coxlab/physiology_rig/sensors/light_sensor/light_sensor_v4_box.pdf

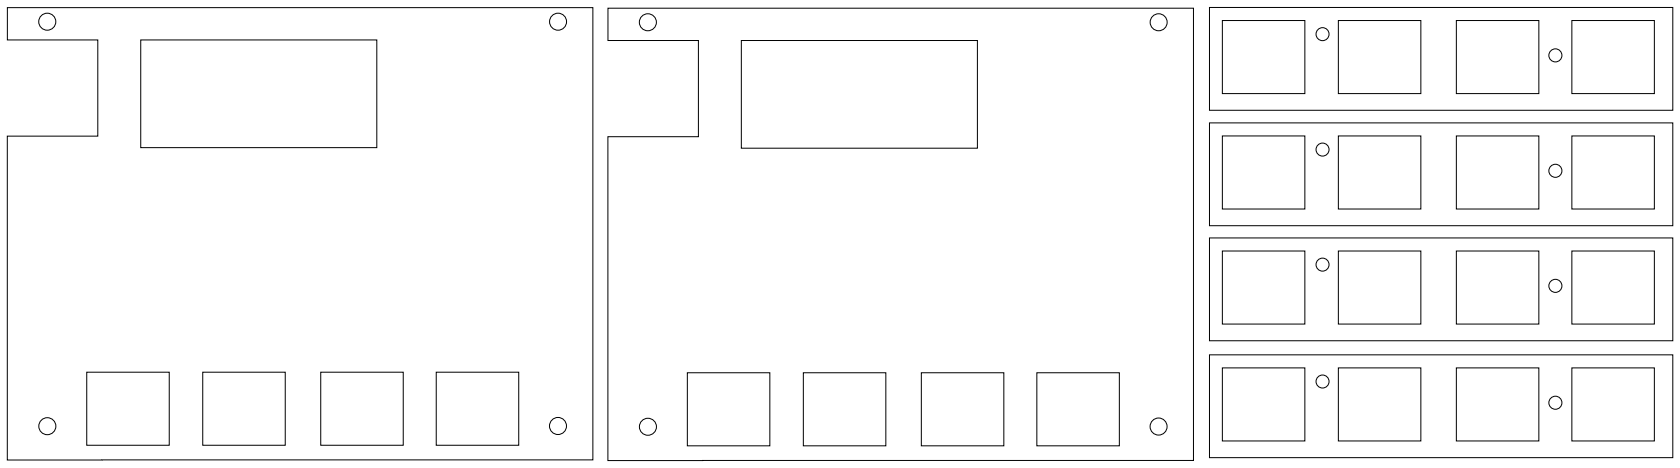
[picture p1: figure]
