coxlab/physiology_rig/implants/ratcam/ratcam/bracket.pdf

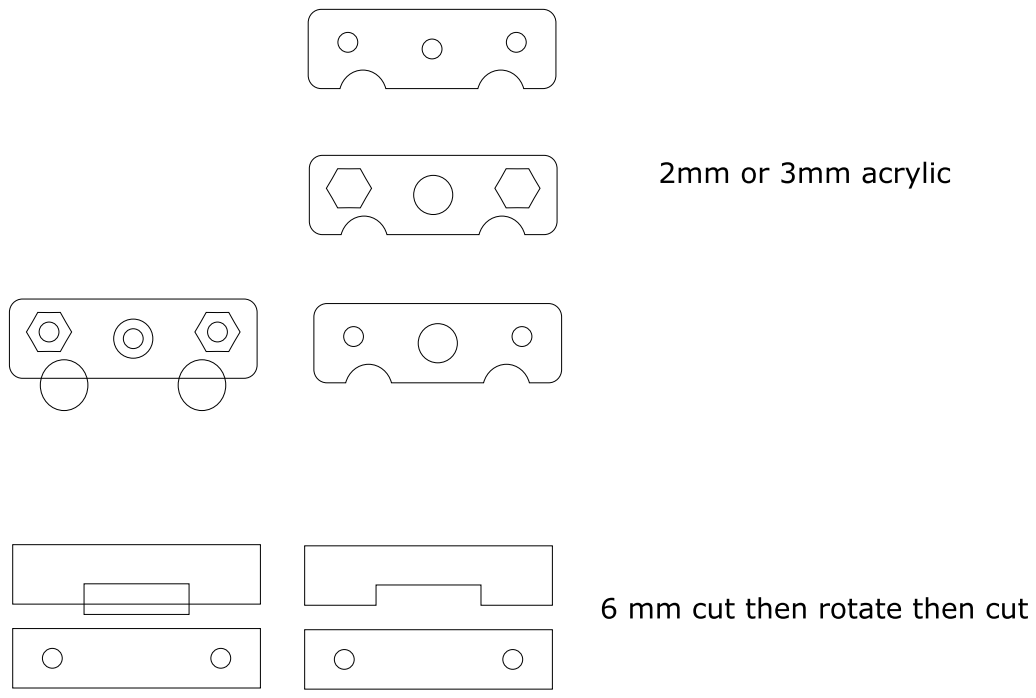
[picture p2: page 1]
