coxlab/physiology_rig/sensors/light_sensor/eagleUp/eagleUp_light_sensor_bottom_mask.png

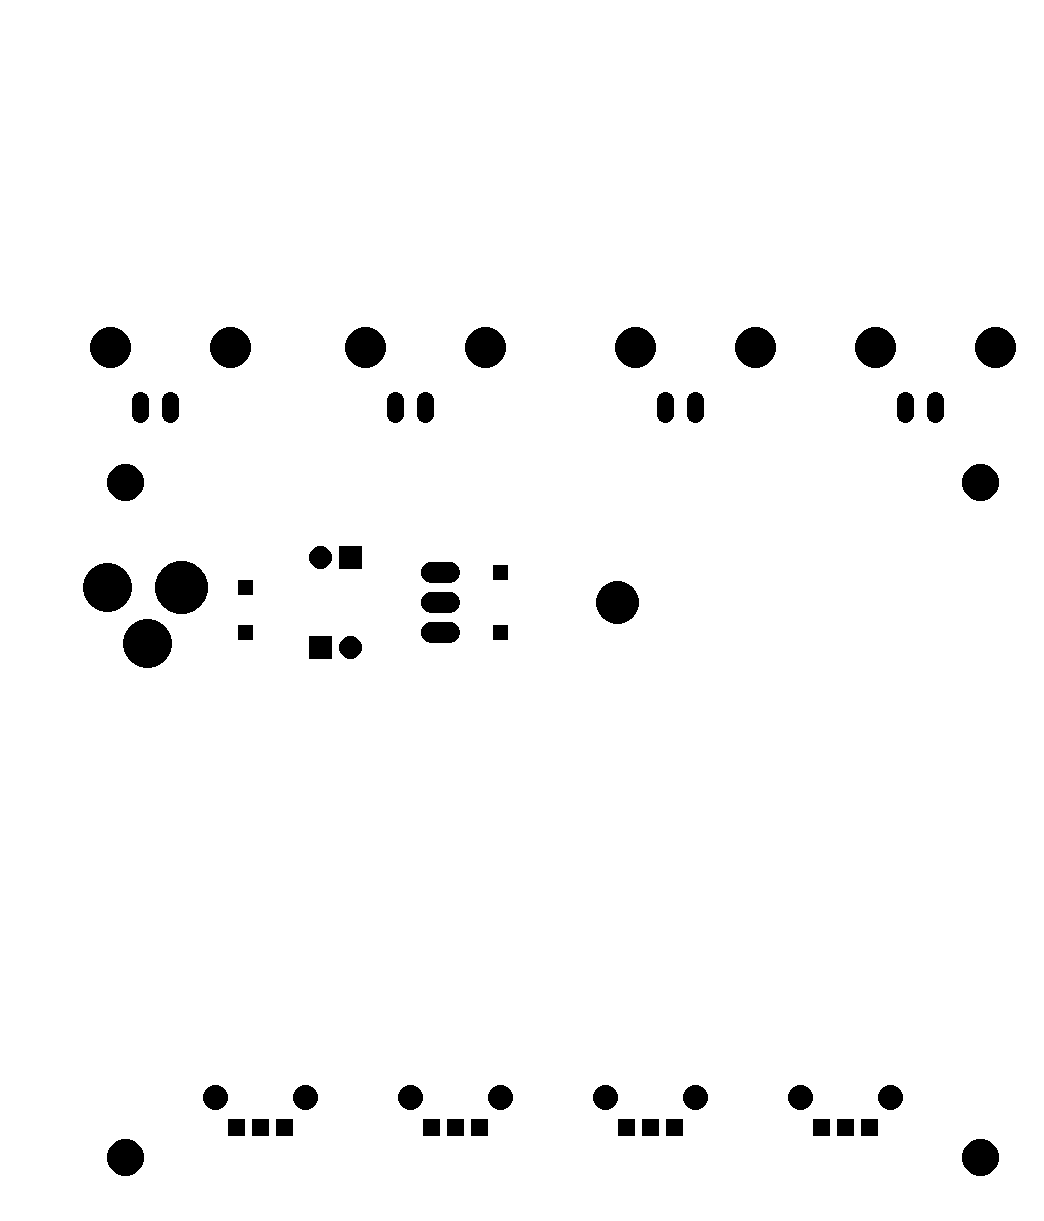
sensors/light_sensor/eagleUp/eagleUp_light_sensor_bottom_mask.png
