coxlab/physiology_rig/sensors/light_sensor/eagleUp/eagleUp_light_sensor_imagesize.png

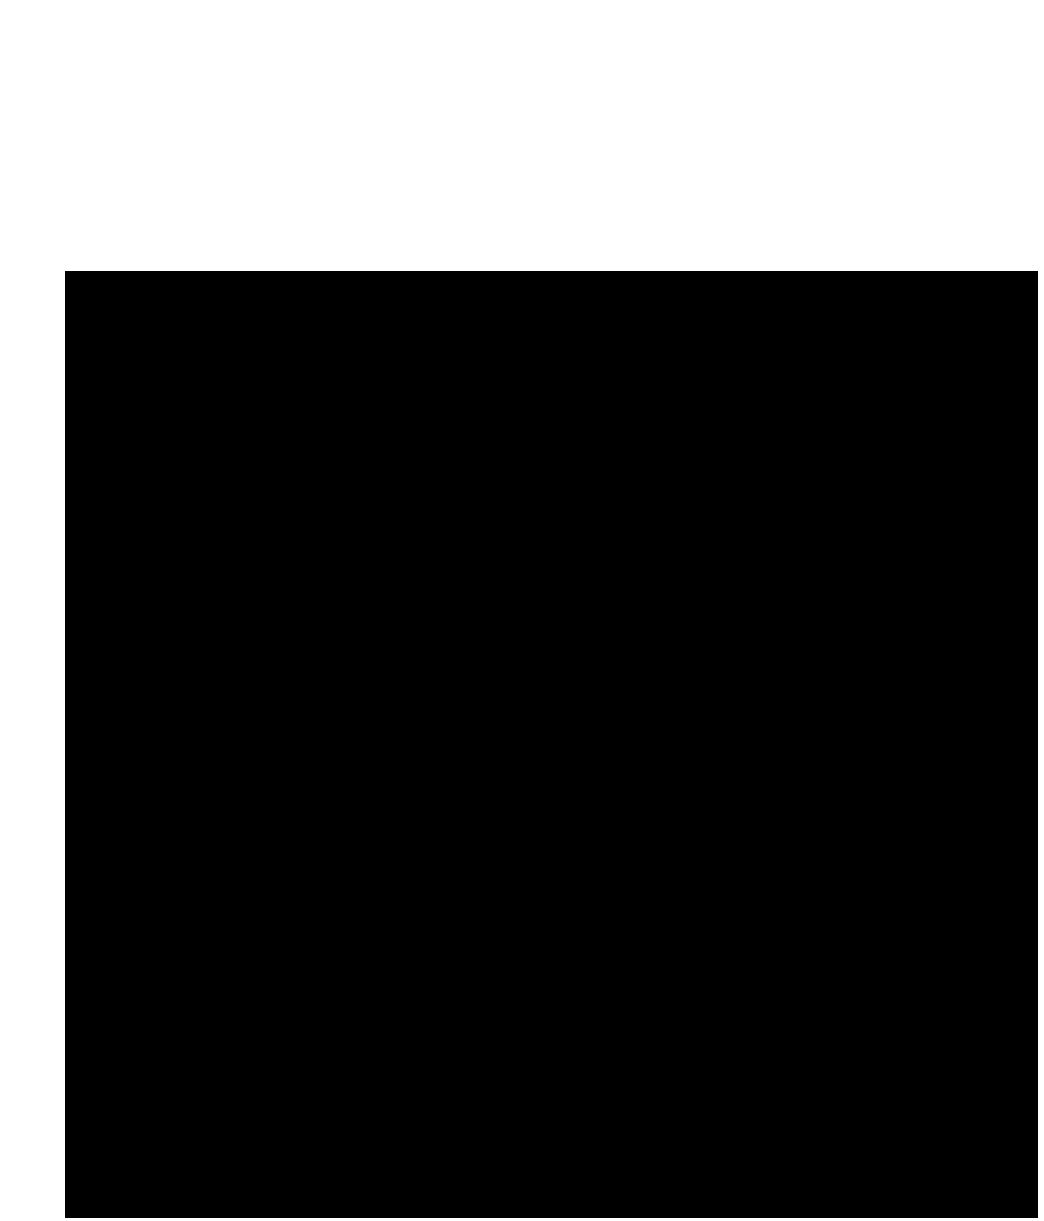
sensors/light_sensor/eagleUp/eagleUp_light_sensor_imagesize.png
