coxlab/physiology_rig/sensors/light_sensor/eagleUp/eagleUp_light_sensor_outline.png

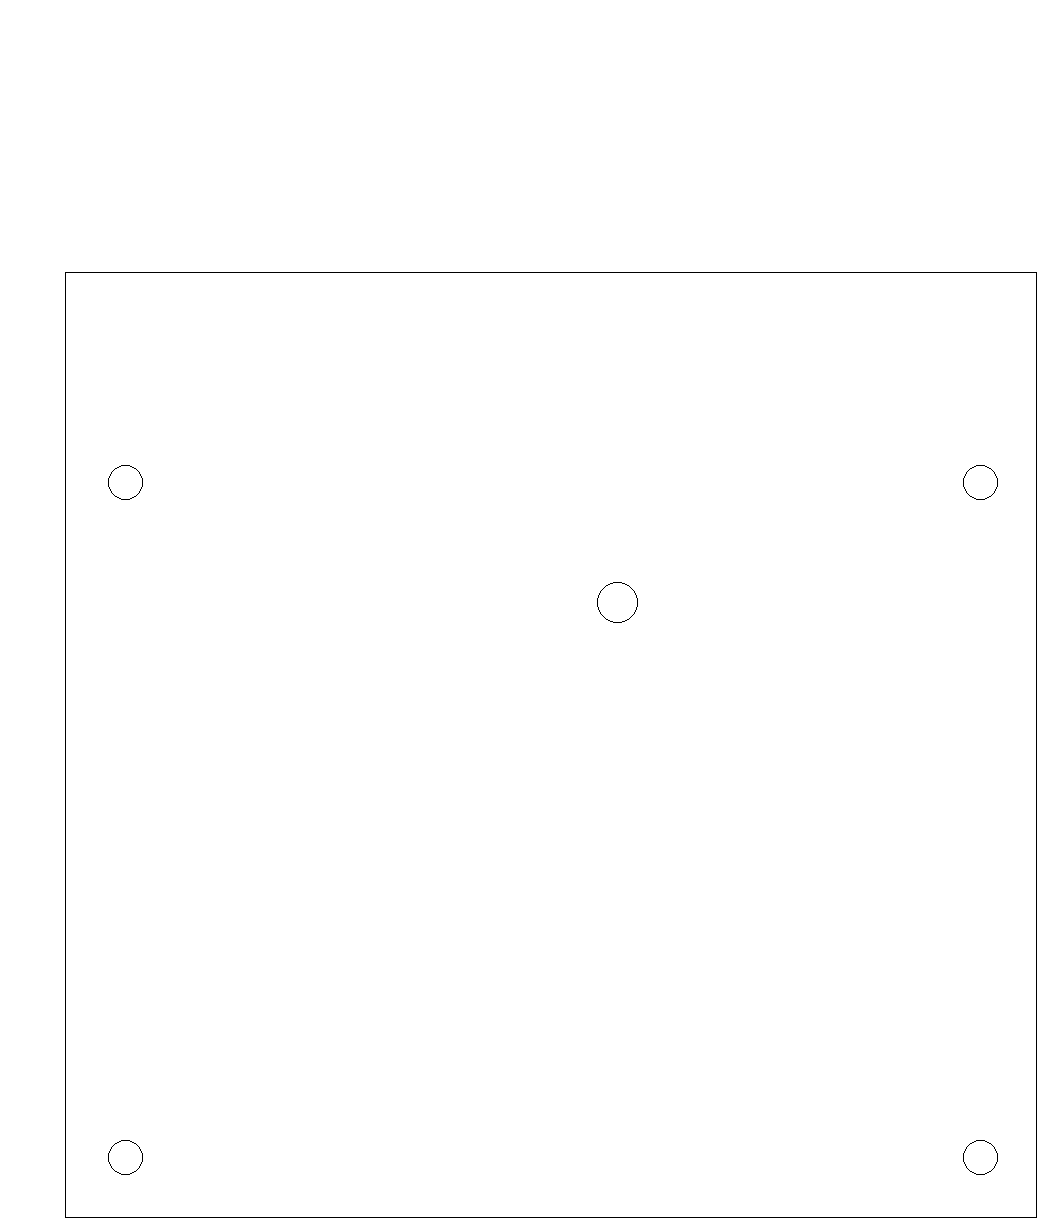
sensors/light_sensor/eagleUp/eagleUp_light_sensor_outline.png
