coxlab/physiology_rig/sensors/light_sensor/eagleUp/eagleUp_light_sensor_top.png

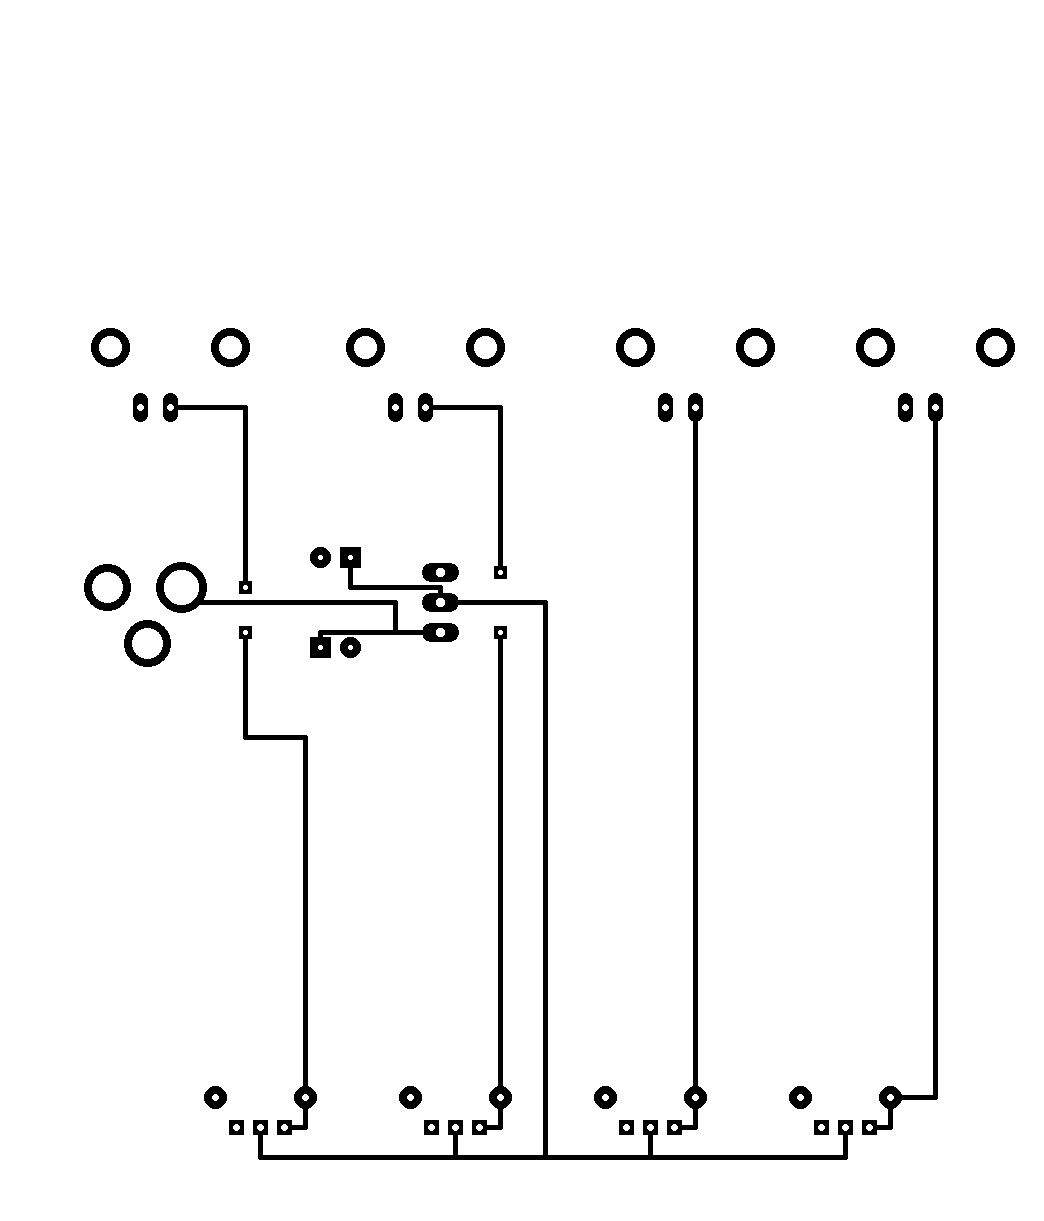
sensors/light_sensor/eagleUp/eagleUp_light_sensor_top.png
