coxlab/physiology_rig/sensors/light_sensor/light_sensor_v4.png

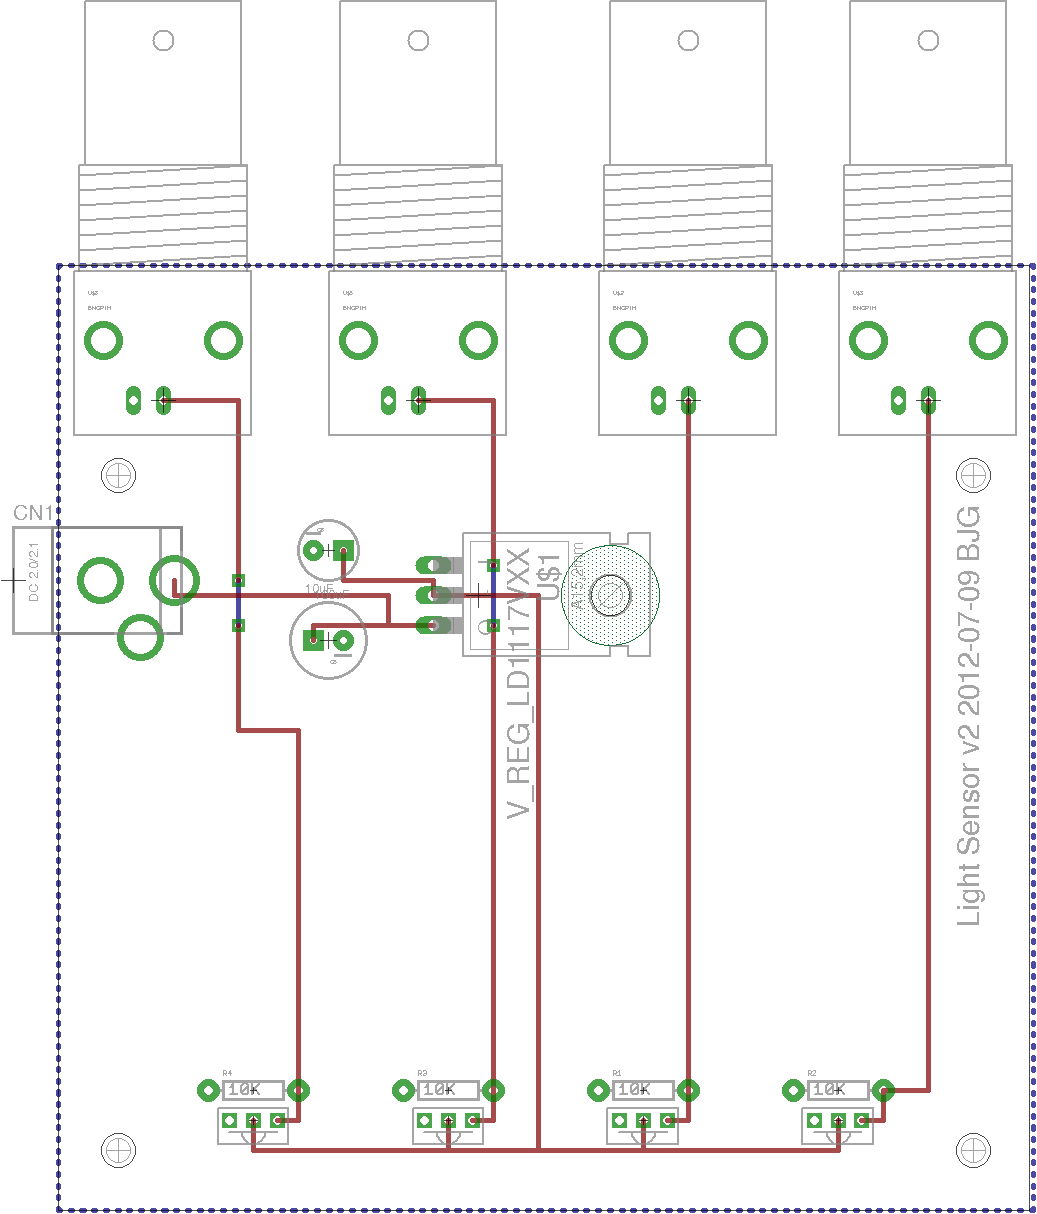
sensors/light_sensor/light_sensor_v4.png
