coxlab/physiology_rig/sensors/light_sensor/light_sensor_v4_box.png

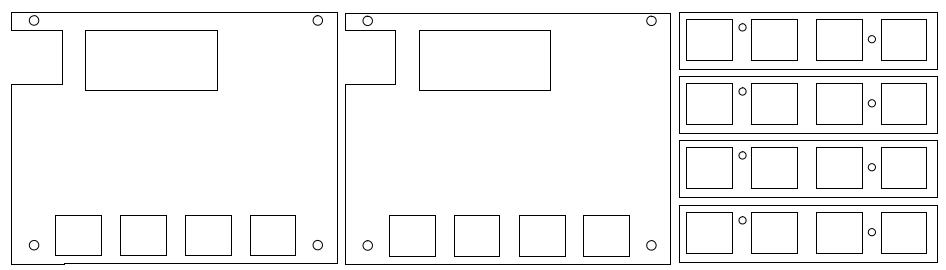
sensors/light_sensor/light_sensor_v4_box.png
