coxlab/physiology_rig/cnc/v1_14x14/electrode_arm/ripple_head.SLDASM

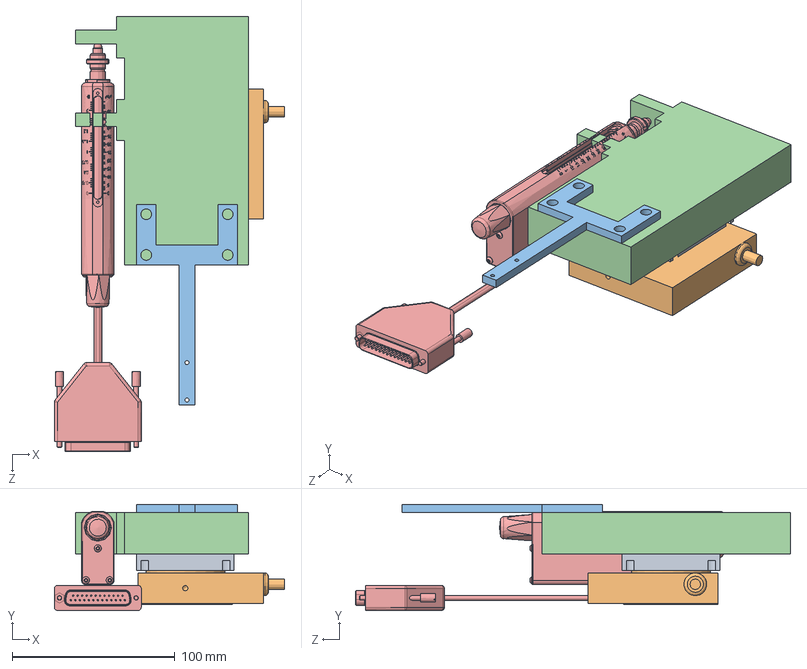
[picture p13: CAD file, 2012-07-30]
cnc/v1_14x14/electrode_arm/ripple_head.SLDASM
141.4 x 65.1 x 267.0 mm
b_to_w
Newport-SR50CC
w_to_ripple
fake_stage
Newport-LTA-HS
