coxlab/physiology_rig/implants/windows/rectangle/D/mated.SLDASM

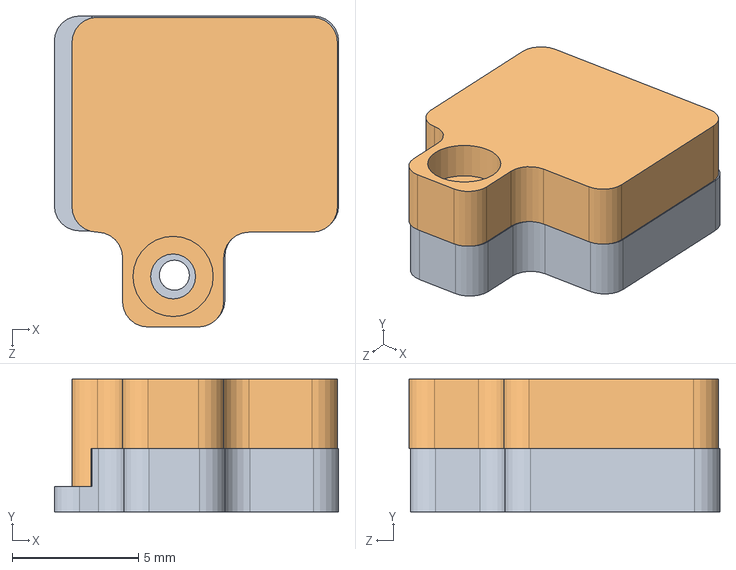
[picture p14: CAD file, 2012-07-30]
implants/windows/rectangle/D/mated.SLDASM
11.2 x 5.25 x 12.3 mm
rectangle_window_D
rectangle_lid_D
