coxlab/physiology_rig/cnc/v1_14x14/commercial_parts/8020/8020-40-4040-Lite.step

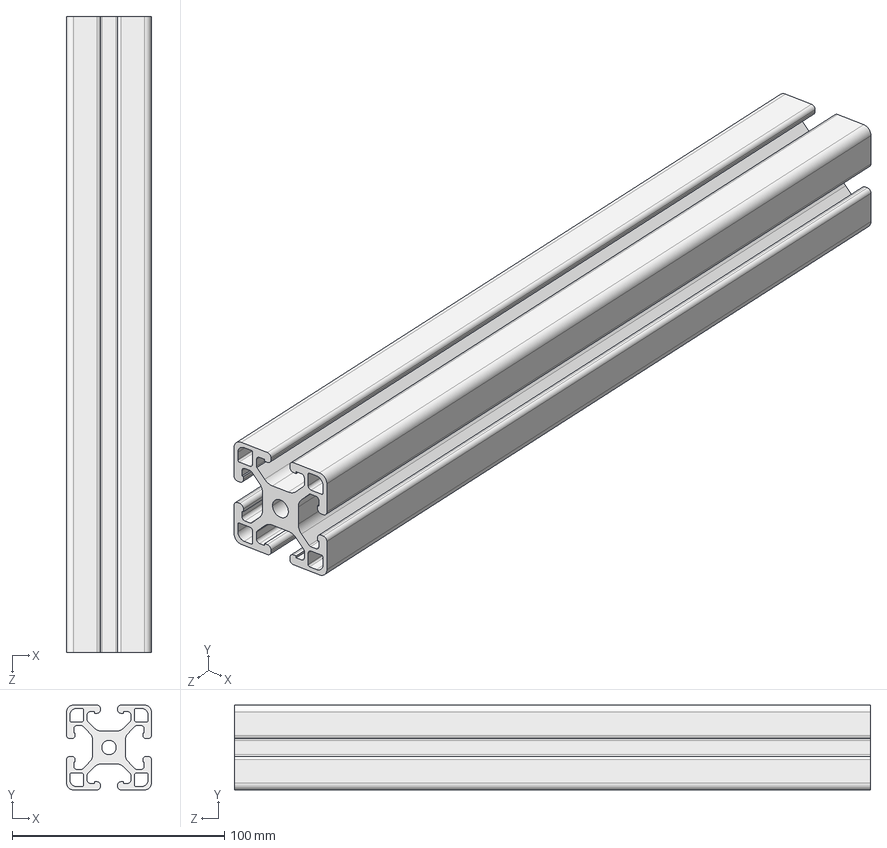
[picture p15: CAD file, 2012-07-30]
cnc/v1_14x14/commercial_parts/8020/8020-40-4040-Lite.step
40.0 x 40.0 x 300.0 mm
