coxlab/physiology_rig/cnc/v1_14x14/commercial_parts/nema_23.stp

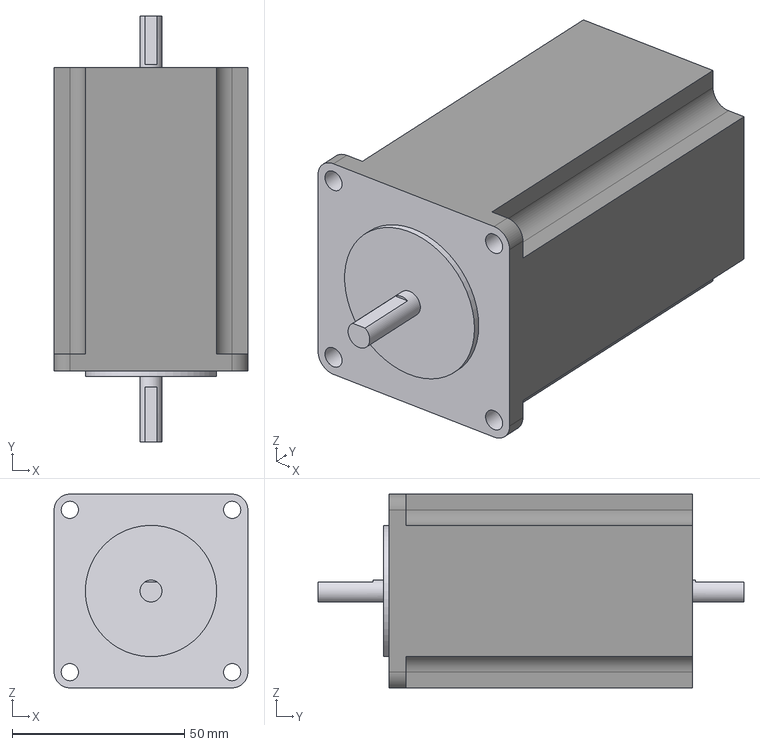
[picture p16: CAD file, 2012-07-30]
cnc/v1_14x14/commercial_parts/nema_23.stp
56.2 x 123.6 x 56.2 mm
