coxlab/physiology_rig/cnc/v1_14x14/commercial_parts/newport/newport_SR50CC.stp

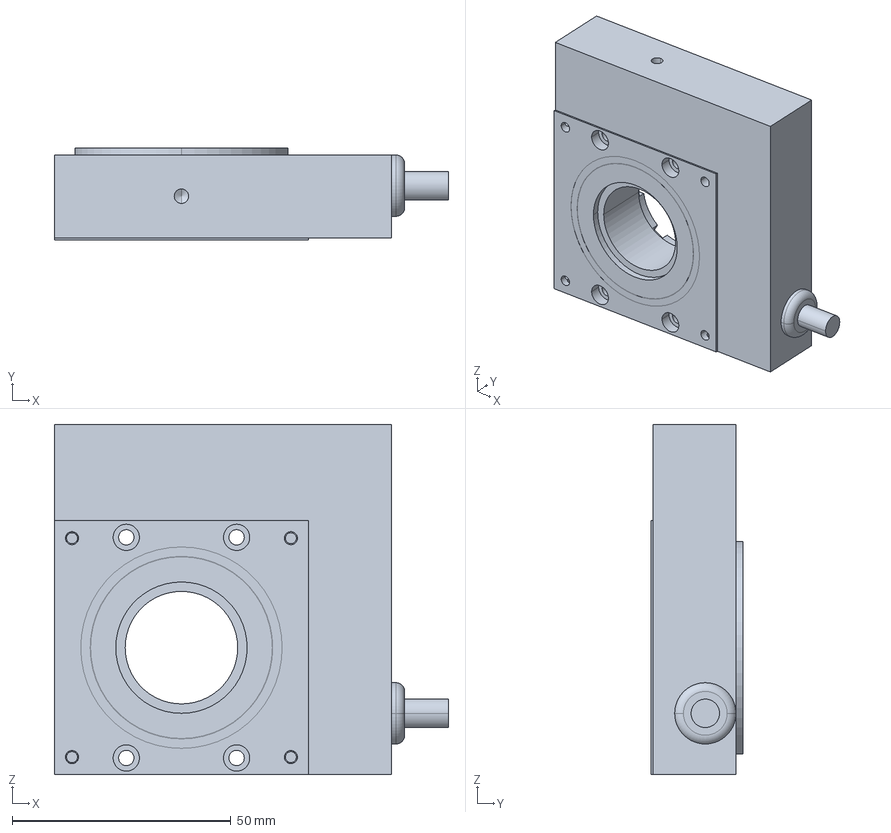
[picture p17: CAD file, 2012-07-30]
cnc/v1_14x14/commercial_parts/newport/newport_SR50CC.stp
90.0 x 21.0 x 80.0 mm
