coxlab/physiology_rig/cnc/v1_14x14/electrode_arm/tdt_preamp_mount/preamp_mount.SLDPRT

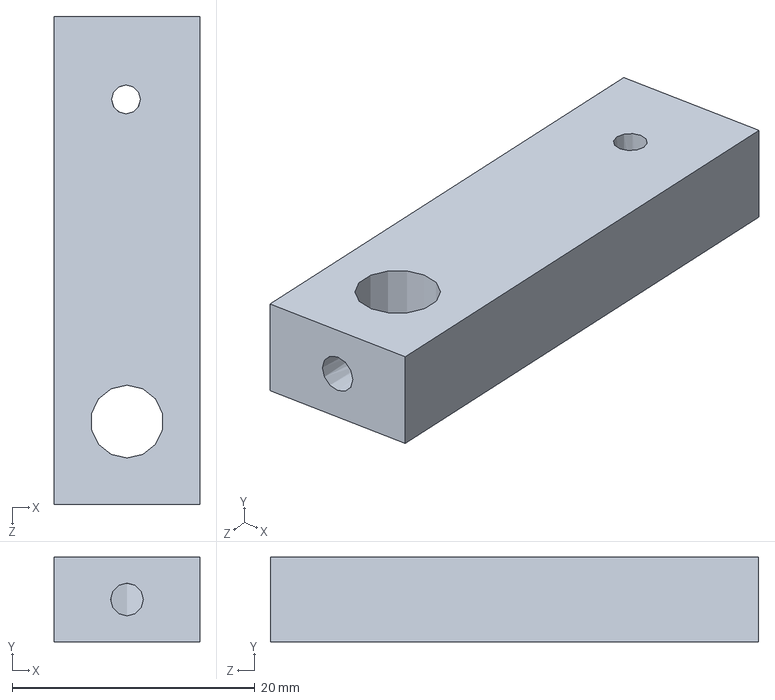
[picture p18: CAD file, 2012-07-30]
cnc/v1_14x14/electrode_arm/tdt_preamp_mount/preamp_mount.SLDPRT
12.0 x 7.00 x 40.2 mm
