coxlab/physiology_rig/cnc/v1_14x14/mounting_plates/cnc_z_plate/cnc_z_plate.SLDPRT

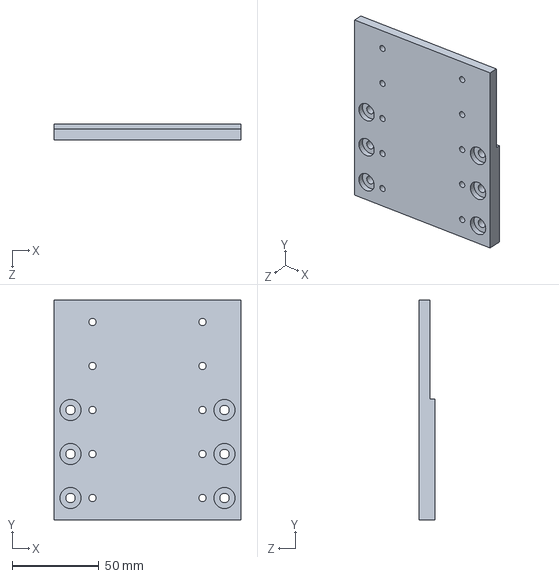
[picture p19: CAD file, 2012-07-30]
cnc/v1_14x14/mounting_plates/cnc_z_plate/cnc_z_plate.SLDPRT
108.0 x 127.0 x 9.53 mm
