coxlab/physiology_rig/cnc/v1_14x14/mounting_plates/z_to_b.SLDPRT

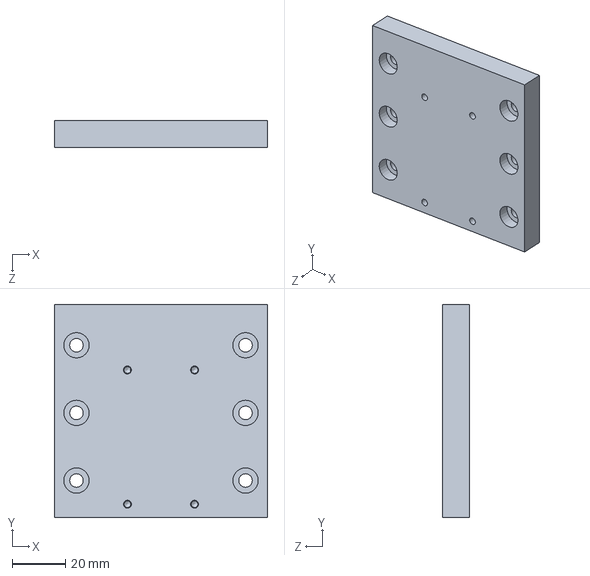
[picture p20: CAD file, 2012-07-30]
cnc/v1_14x14/mounting_plates/z_to_b.SLDPRT
80.0 x 80.0 x 10.0 mm
