coxlab/physiology_rig/implants/kinematic_mount/hats/D/TricornerHatD_fordxf.DXF

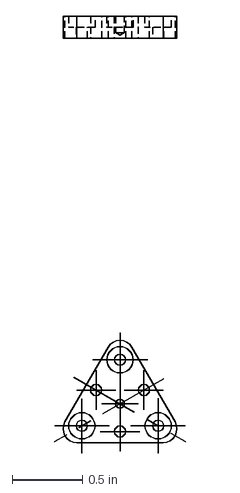
[picture p22: CAD file, 2012-07-30]
implants/kinematic_mount/hats/D/TricornerHatD_fordxf.DXF
0.941 x 3.12 in
