coxlab/physiology_rig/implants/kinematic_mount/hats/E/TricornerHatE.SLDPRT

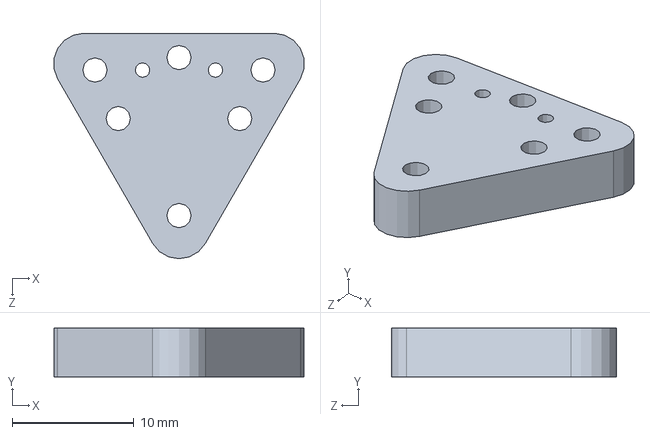
[picture p23: CAD file, 2012-07-30]
implants/kinematic_mount/hats/E/TricornerHatE.SLDPRT
20.6 x 4.00 x 18.6 mm
