coxlab/physiology_rig/implants/kinematic_mount/hats/F/TricornerHatF_nodims_2.dxf

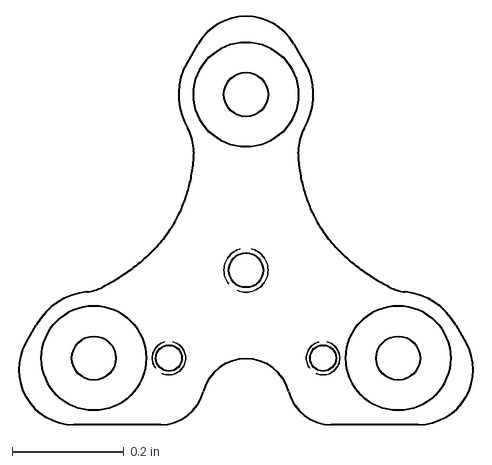
[picture p24: CAD file, 2012-07-30]
implants/kinematic_mount/hats/F/TricornerHatF_nodims_2.dxf
0.822 x 0.73 in
