coxlab/physiology_rig/implants/kinematic_mount/magnet_chuck_redesign/ferrous_insert_no_dims.dxf

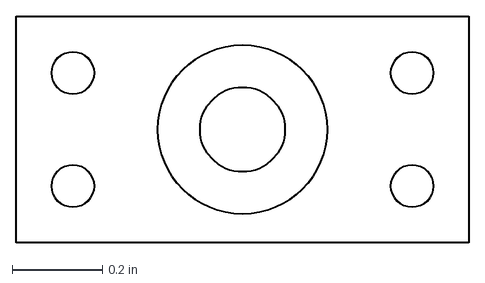
[picture p25: CAD file, 2012-07-30]
implants/kinematic_mount/magnet_chuck_redesign/ferrous_insert_no_dims.dxf
1.00 x 0.5 in
