coxlab/physiology_rig/implants/kinematic_mount/seat/grid/TricornerGround.SLDPRT

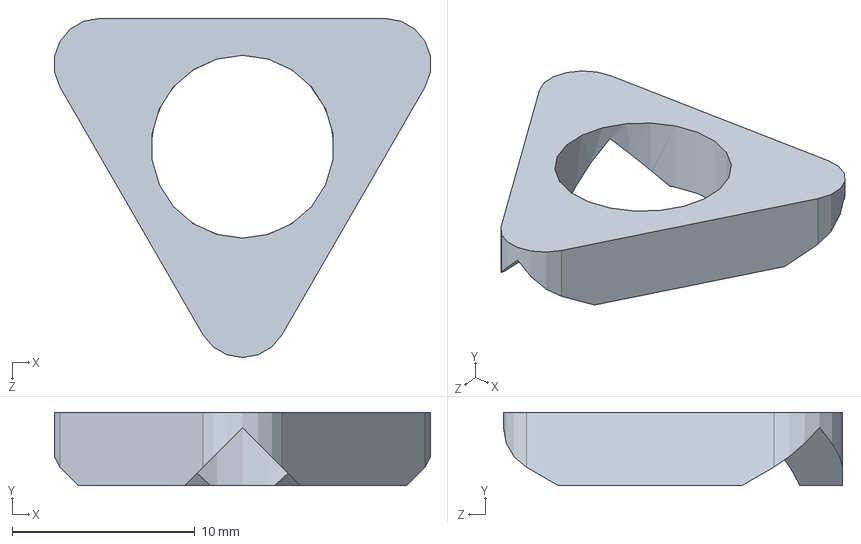
[picture p26: CAD file, 2012-07-30]
implants/kinematic_mount/seat/grid/TricornerGround.SLDPRT
20.6 x 4.00 x 18.6 mm
