coxlab/physiology_rig/implants/kinematic_mount/test_jig/tricorner_test_rig_noAnnotation.DXF

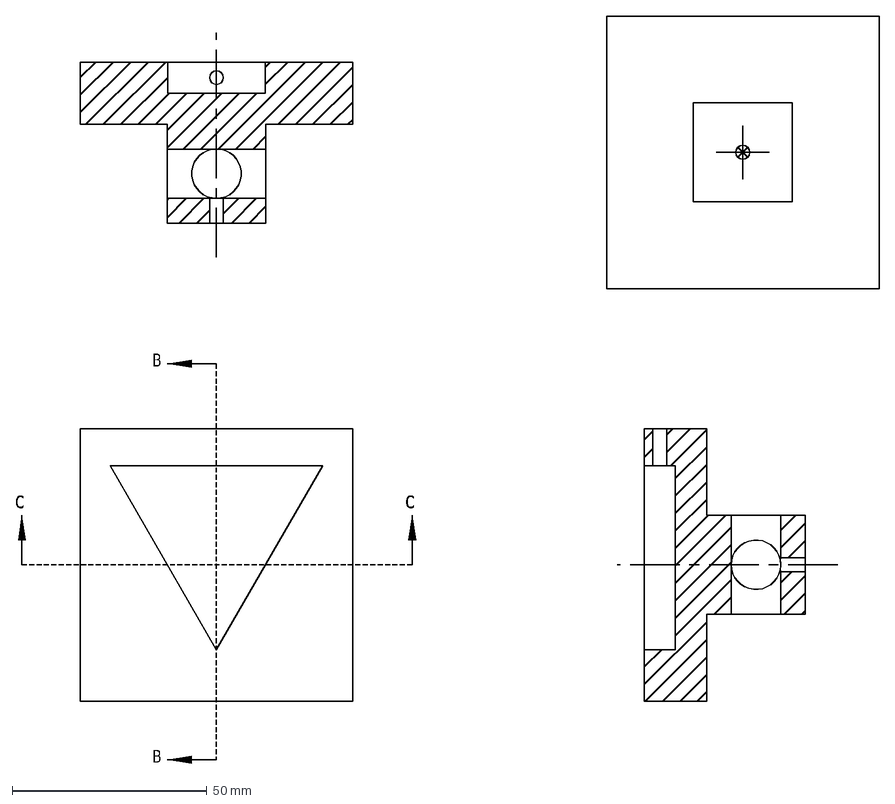
[picture p27: CAD file, 2012-07-30]
implants/kinematic_mount/test_jig/tricorner_test_rig_noAnnotation.DXF
B
C
