coxlab/physiology_rig/implants/ratcam/ratcam/TricornerGround.stl

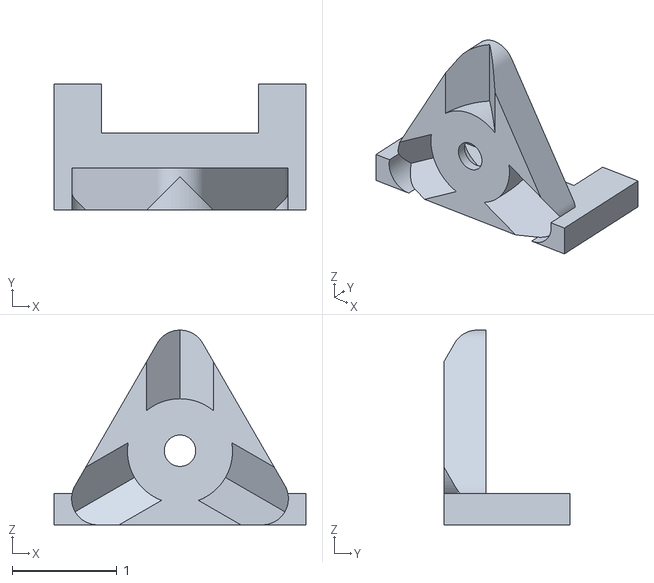
[picture p28: CAD file, 2012-07-30]
implants/ratcam/ratcam/TricornerGround.stl
2.40 x 1.20 x 1.86
