coxlab/physiology_rig/implants/ratcam/ratcam_mount/A/ratcam_mount.SLDPRT

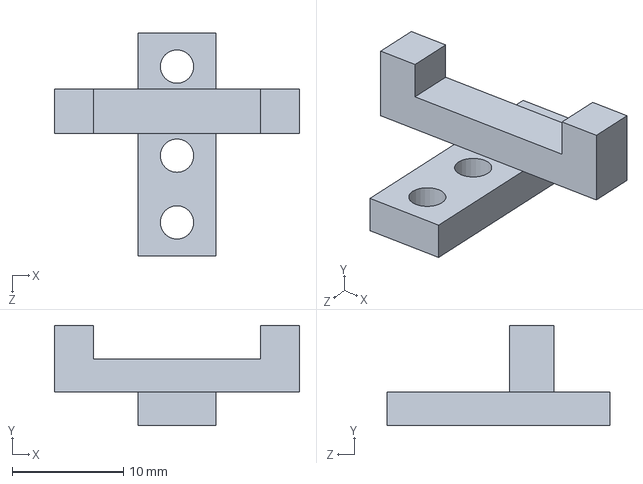
[picture p29: CAD file, 2012-07-30]
implants/ratcam/ratcam_mount/A/ratcam_mount.SLDPRT
22.0 x 9.00 x 20.0 mm
