coxlab/physiology_rig/implants/windows/rectangle/A/rectangle_lid_B.SLDPRT

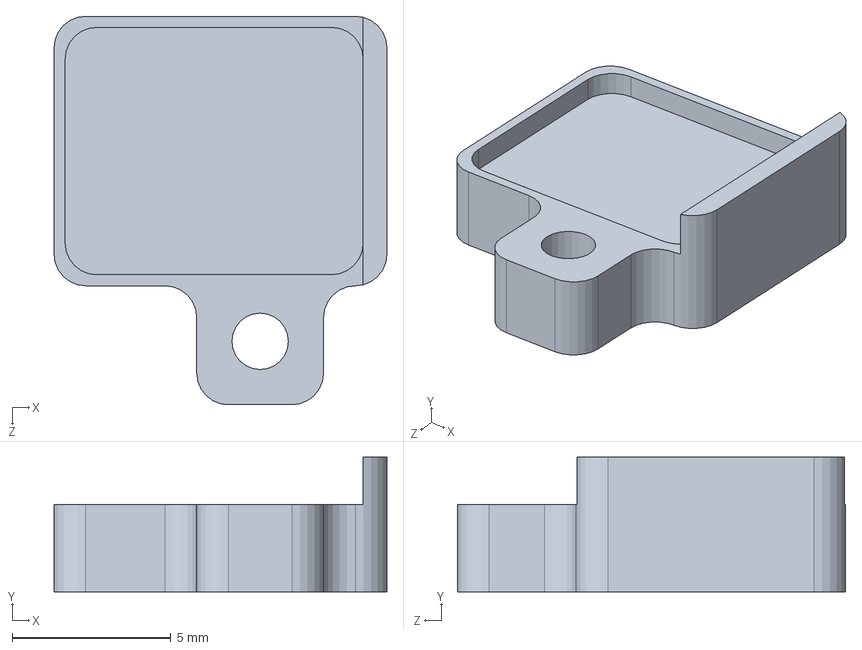
[picture p30: CAD file, 2012-07-30]
implants/windows/rectangle/A/rectangle_lid_B.SLDPRT
10.5 x 4.25 x 12.3 mm
