coxlab/physiology_rig/implants/windows/rectangle/C/rectangle_window_C.SLDPRT

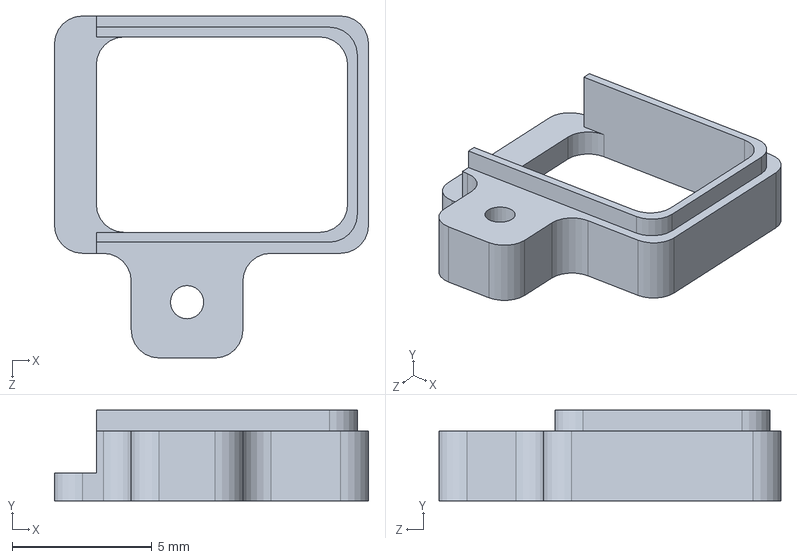
[picture p31: CAD file, 2012-07-30]
implants/windows/rectangle/C/rectangle_window_C.SLDPRT
11.2 x 3.25 x 12.3 mm
