coxlab/physiology_rig/implants/windows/rectangle/E/inventor/rectangle_lid_E_dims.dxf

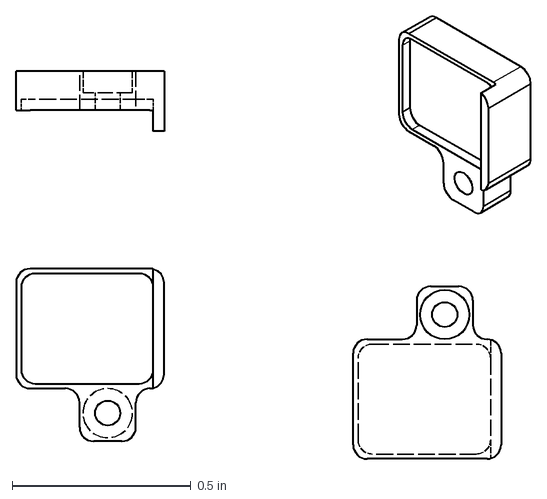
[picture p32: CAD file, 2012-07-30]
implants/windows/rectangle/E/inventor/rectangle_lid_E_dims.dxf
1.44 x 1.24 in
