coxlab/physiology_rig/implants/windows/rectangle/E/rectangle_window_E.dxf

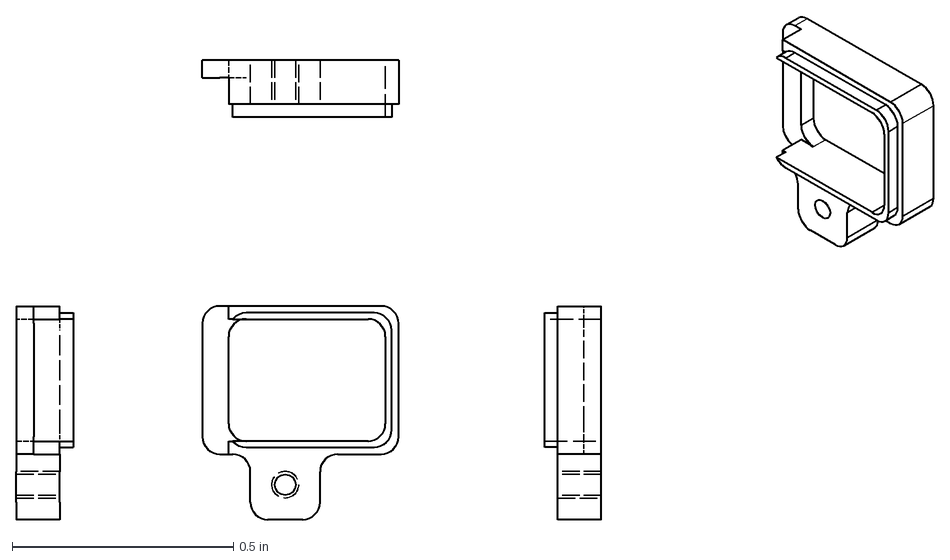
[picture p33: CAD file, 2012-07-30]
implants/windows/rectangle/E/rectangle_window_E.dxf
2.07 x 1.14 in
