coxlab/physiology_rig/implants/windows/square/C/7mmWindowC.SLDPRT

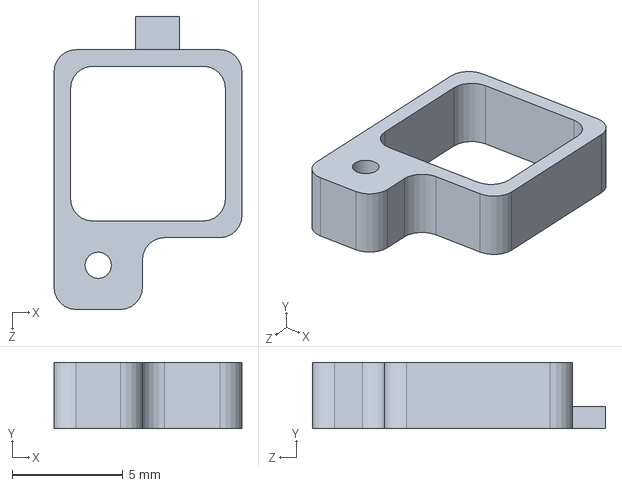
[picture p35: CAD file, 2012-07-30]
implants/windows/square/C/7mmWindowC.SLDPRT
8.50 x 3.00 x 13.2 mm
