coxlab/physiology_rig/implants/windows/square/D/7mmWindowD.DXF

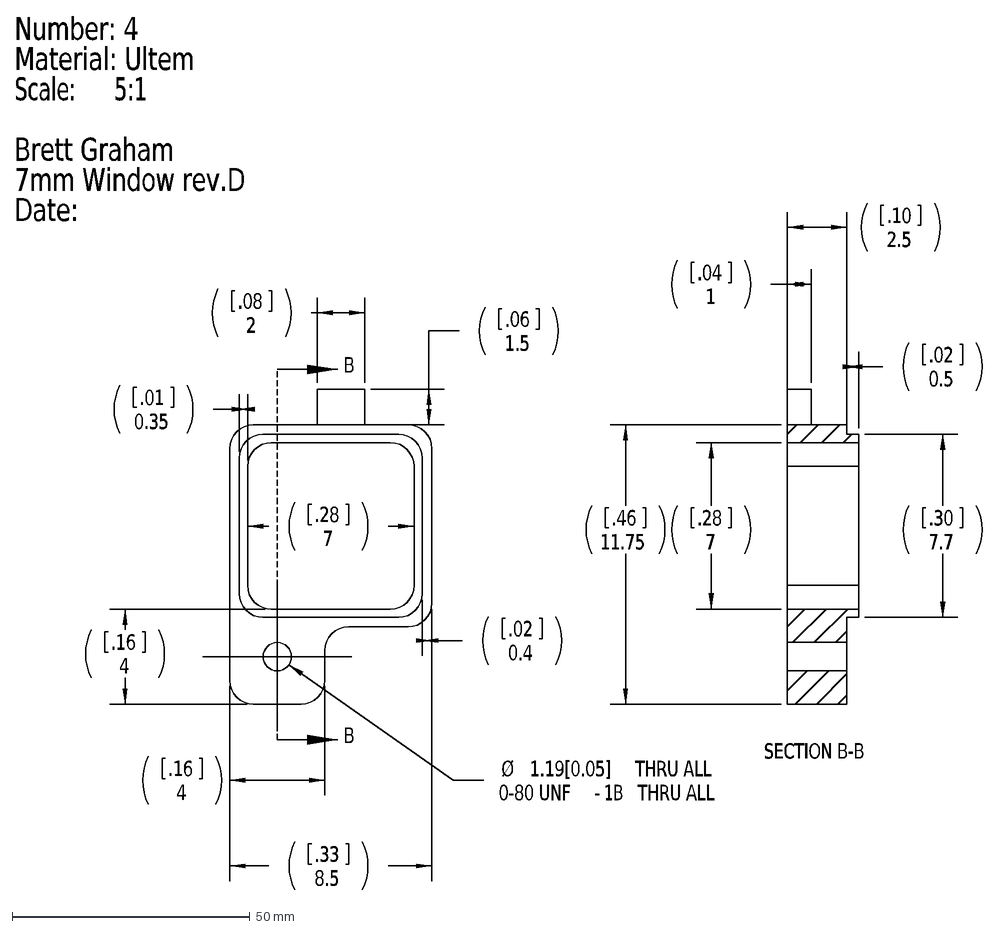
[picture p36: CAD file, 2012-07-30]
implants/windows/square/D/7mmWindowD.DXF
Number: 4
Material: Ultem
Scale: 5:1
Brett Graham
7mm Window rev.D
Date:
2
.08
1.5
.06
4
.16
8.5
.33
7
.28
0-80 UNF
- 1B
THRU ALL
Ø
1.19[0.05]
0.4
.02
0.35
.01
B
11.75
.46
1
.04
2.5
.10
0.5
7.7
.30
SECTION B-B
