coxlab/physiology_rig/implants/windows/wide/a_0.5mm_wall/lid.dxf

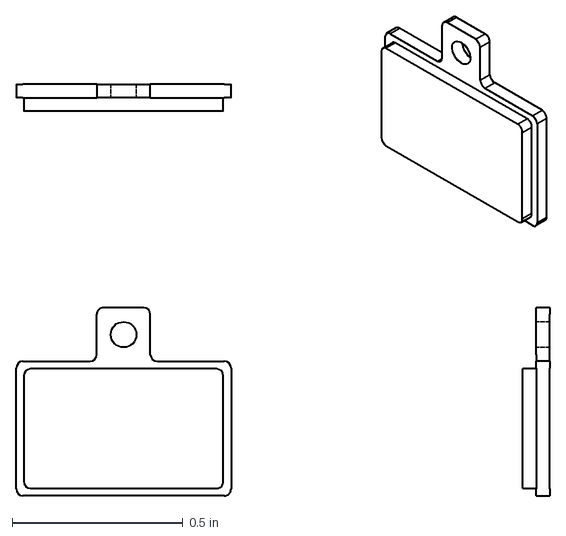
[picture p37: CAD file, 2012-07-30]
implants/windows/wide/a_0.5mm_wall/lid.dxf
1.56 x 1.41 in
