coxlab/physiology_rig/implants/windows/wide/b_1mm_wall/lid.dxf

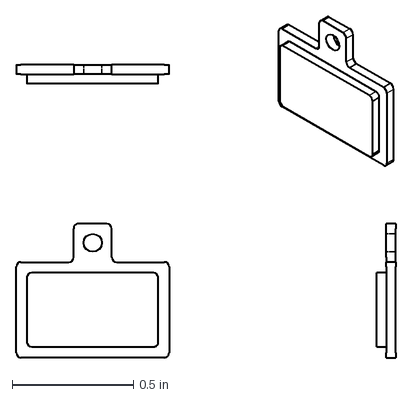
[picture p38: CAD file, 2012-07-30]
implants/windows/wide/b_1mm_wall/lid.dxf
1.56 x 1.41 in
