coxlab/physiology_rig/implants/windows/wide/c_7mm_0.5mm_wall/lid.dxf

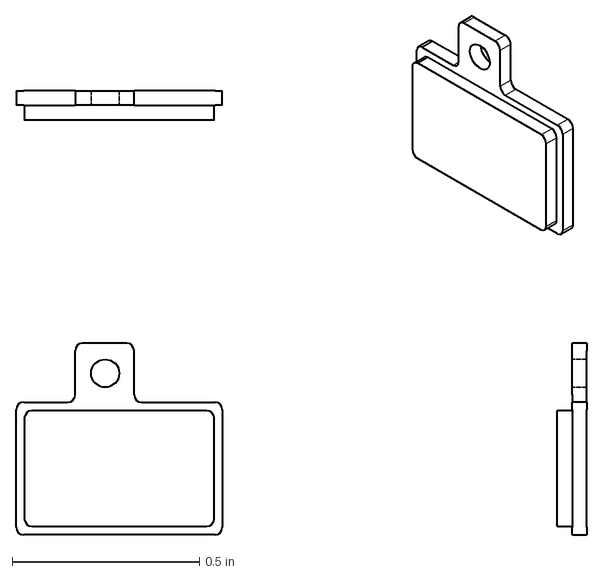
[picture p39: CAD file, 2012-07-30]
implants/windows/wide/c_7mm_0.5mm_wall/lid.dxf
1.53 x 1.39 in
