coxlab/physiology_rig/recording/audio/garbage2.0/garbage2_mount/garbage2_mount.SLDPRT

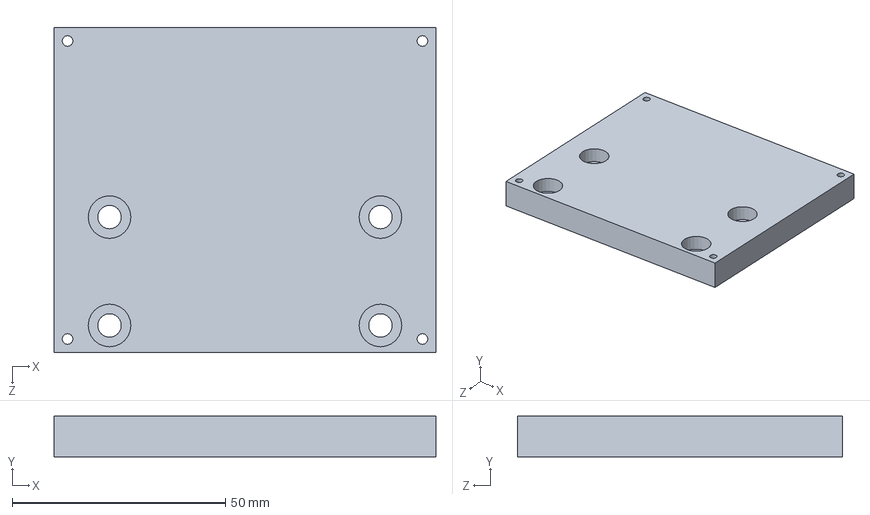
[picture p40: CAD file, 2012-07-30]
recording/audio/garbage2.0/garbage2_mount/garbage2_mount.SLDPRT
89.5 x 9.53 x 76.2 mm
