coxlab/physiology_rig/recording/neuro_nexus_probes/a/a_10.SLDPRT

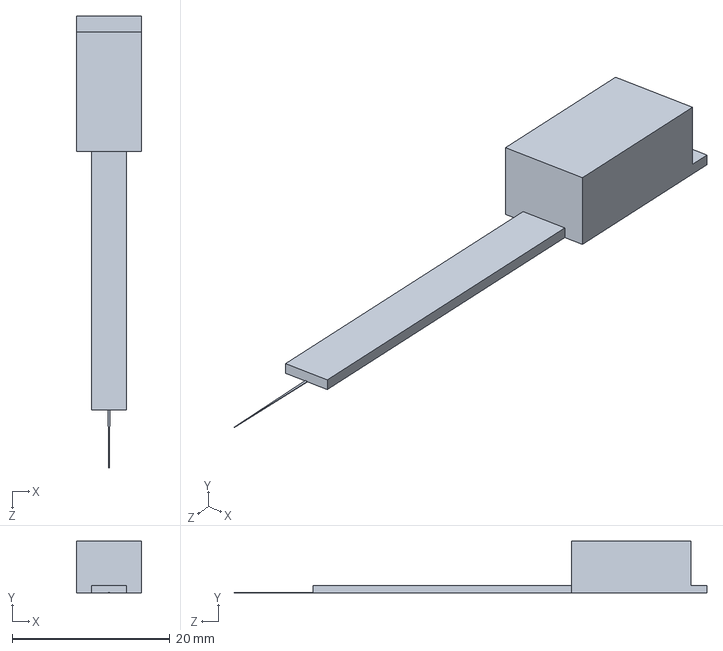
[picture p41: CAD file, 2012-07-30]
recording/neuro_nexus_probes/a/a_10.SLDPRT
8.30 x 6.55 x 60.0 mm
