coxlab/physiology_rig/recording/single_channel/alpha_omega_holder/alpha_omega_holder.stl

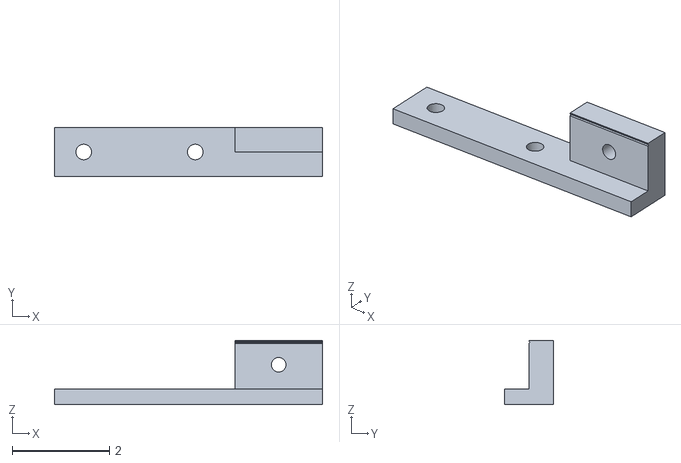
[picture p42: CAD file, 2012-07-30]
recording/single_channel/alpha_omega_holder/alpha_omega_holder.stl
5.50 x 1.00 x 1.32
