coxlab/physiology_rig/sensors/light_sensor/light_sensor.dxf

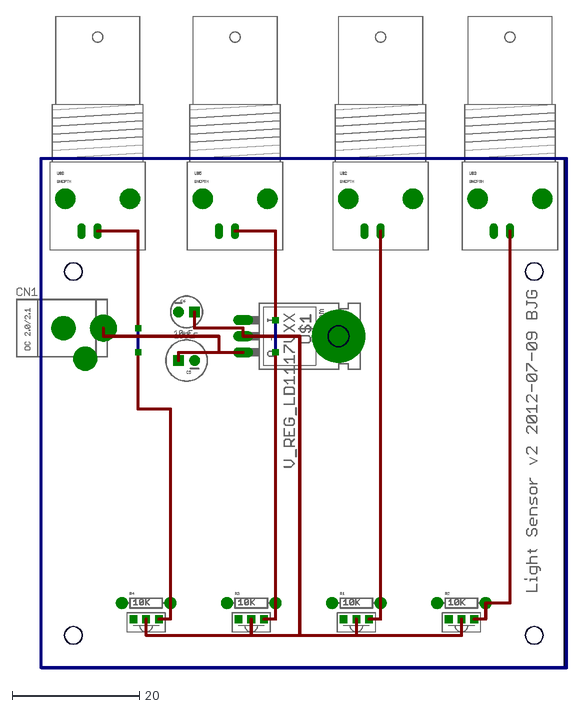
[picture p43: CAD file, 2012-07-30]
sensors/light_sensor/light_sensor.dxf
86.7 x 102.6
