coxlab/physiology_rig/sensors/phidget_to_bb_plate/phidget_to_bb_plate.dxf

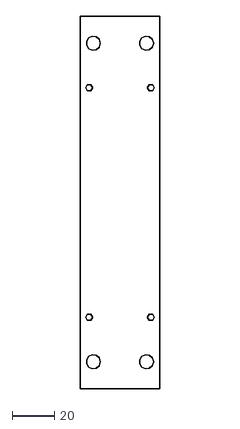
[picture p44: CAD file, 2013-03-04]
sensors/phidget_to_bb_plate/phidget_to_bb_plate.dxf
37.5 x 175.5
