coxlab/physiology_rig/stereo_cameras/scorpion_cameras/scorpion_lens_adaptor/scorpion_lens_adaptor.SLDPRT

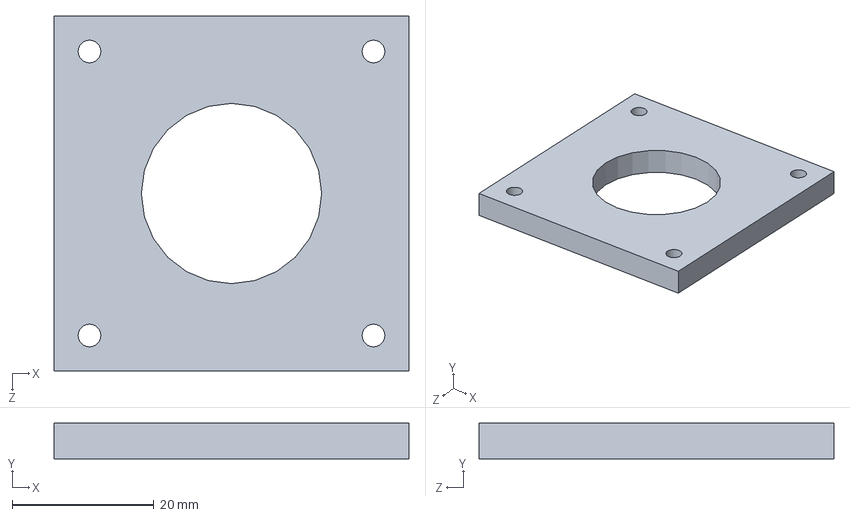
[picture p45: CAD file, 2012-07-30]
stereo_cameras/scorpion_cameras/scorpion_lens_adaptor/scorpion_lens_adaptor.SLDPRT
50.0 x 5.00 x 50.0 mm
