coxlab/physiology_rig/stereo_cameras/scorpion_cameras/scorpion_mount/ptgrey_scorpion_mount.SLDPRT

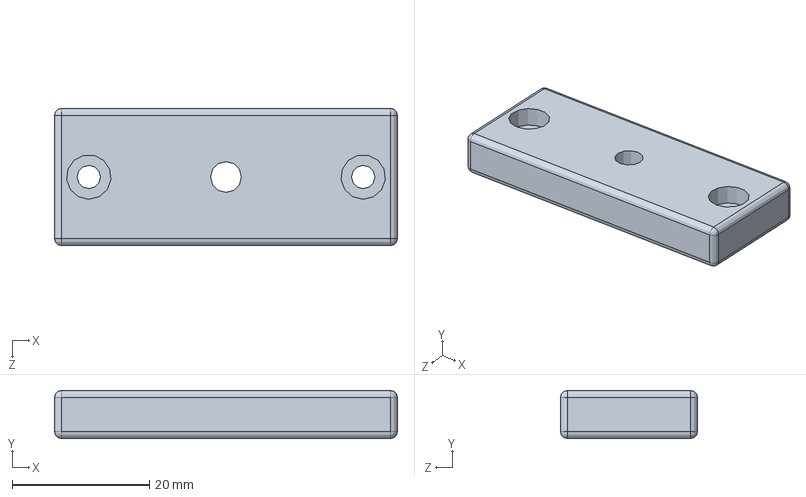
[picture p46: CAD file, 2012-07-30]
stereo_cameras/scorpion_cameras/scorpion_mount/ptgrey_scorpion_mount.SLDPRT
50.0 x 7.00 x 20.0 mm
