coxlab/physiology_rig/stereo_cameras/scorpion_cameras/stereo_cameras_plate/stereo_cameras_plate.dxf

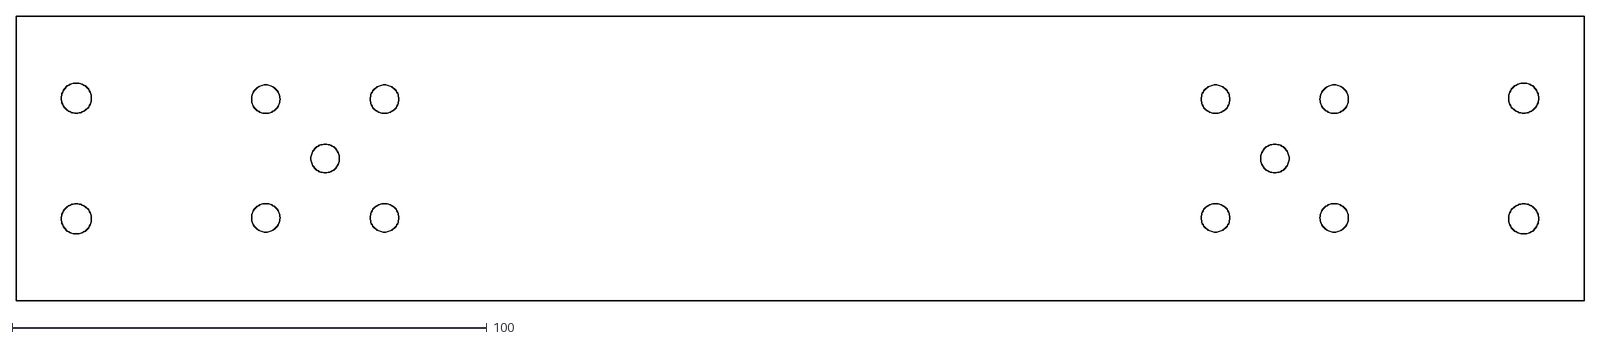
[picture p47: CAD file, 2013-03-04]
stereo_cameras/scorpion_cameras/stereo_cameras_plate/stereo_cameras_plate.dxf
330.2 x 60.0
