coxlab/physiology_rig/structured_light/reference_object/A/structured_light_registration_object..stp

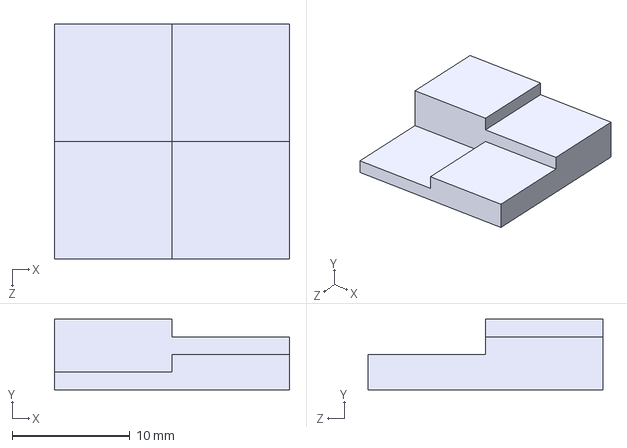
[picture p48: CAD file, 2012-07-30]
structured_light/reference_object/A/structured_light_registration_object..stp
20.0 x 6.00 x 20.0 mm
