coxlab/physiology_rig/structured_light/reference_plate/other_tricorner_registration_plate.SLDPRT

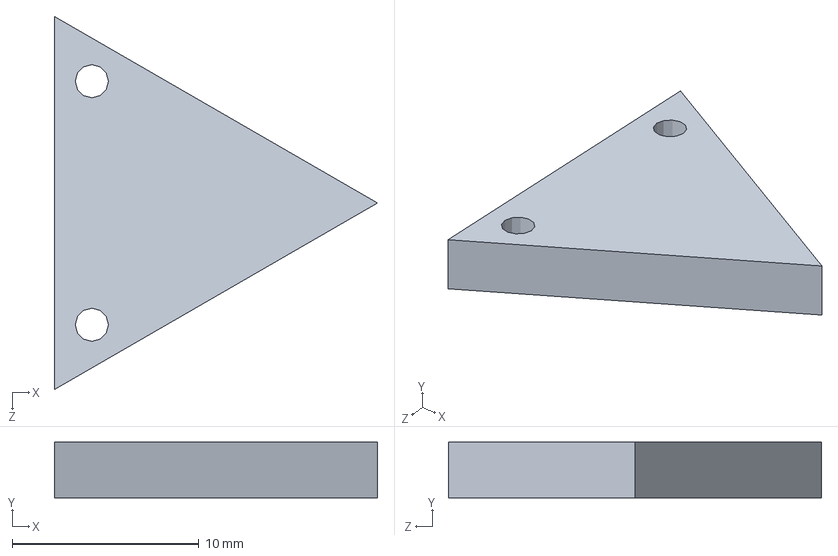
[picture p49: CAD file, 2012-07-30]
structured_light/reference_plate/other_tricorner_registration_plate.SLDPRT
17.3 x 3.00 x 20.0 mm
