coxlab/physiology_rig/two_photon/objective/N20X-PFH-Solidworks.sldprt

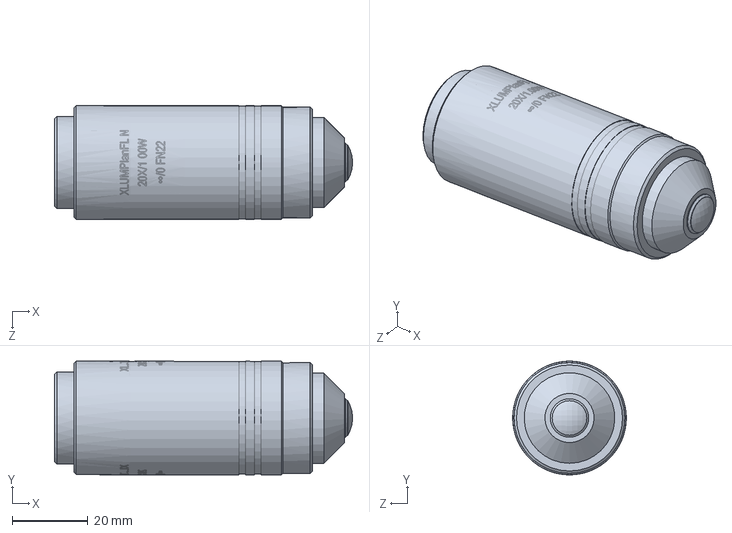
[picture p50: CAD file, 2013-04-24]
two_photon/objective/N20X-PFH-Solidworks.sldprt
78.6 x 30.0 x 29.9 mm
