coxlab/physiology_rig/cnc/v1_14x14/commercial_parts/8020/8020-25-2525.step

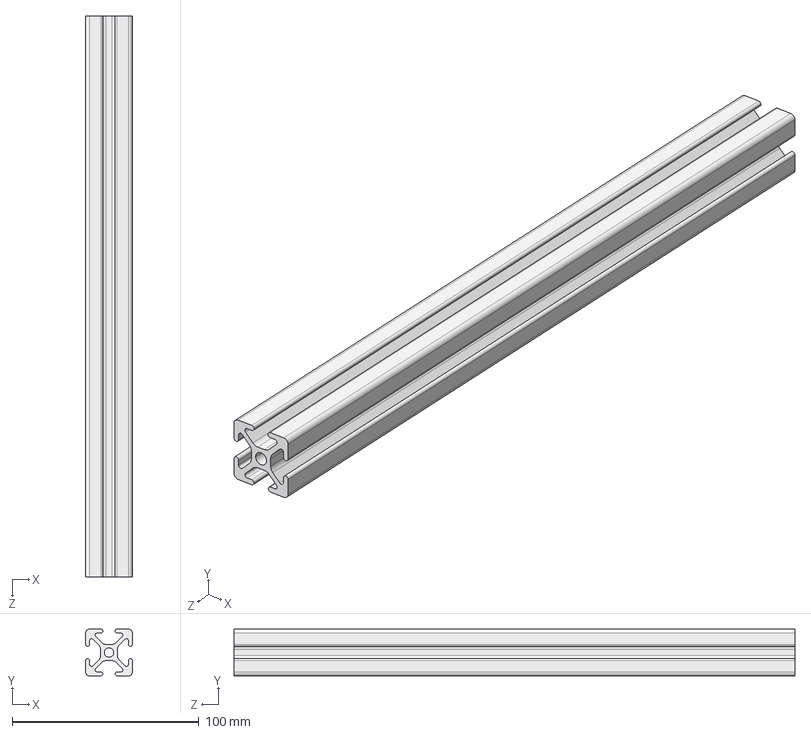
[picture p51: CAD file, 2012-07-30]
cnc/v1_14x14/commercial_parts/8020/8020-25-2525.step
25.0 x 25.0 x 300.0 mm
