coxlab/physiology_rig/cnc/v1_14x14/commercial_parts/newport/Newport-LTA-HS.SLDPRT

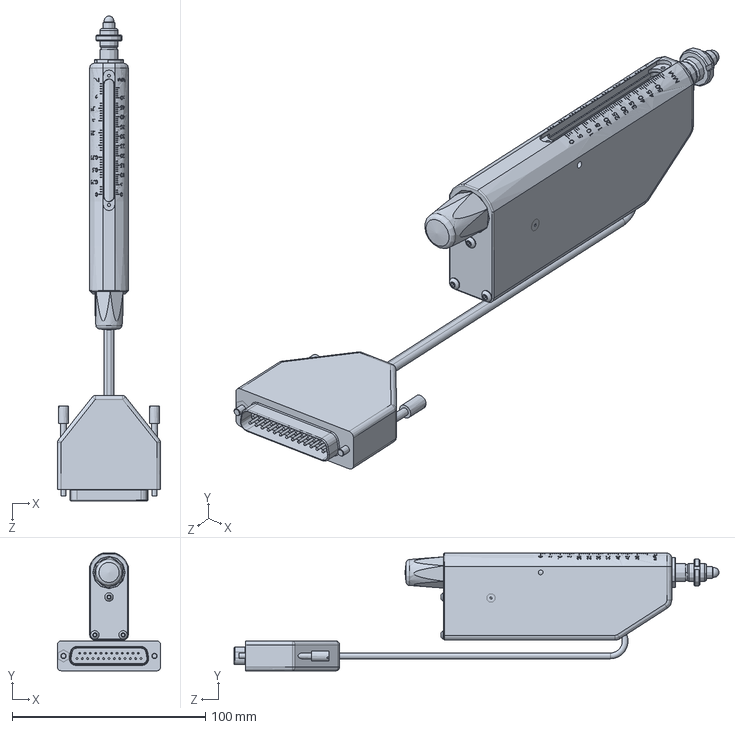
[picture p52: CAD file, 2012-07-30]
cnc/v1_14x14/commercial_parts/newport/Newport-LTA-HS.SLDPRT
53.4 x 60.9 x 250.8 mm
