coxlab/physiology_rig/cnc/v1_14x14/electrode_arm/failed_head/w_to_tdt_fordxf.DXF

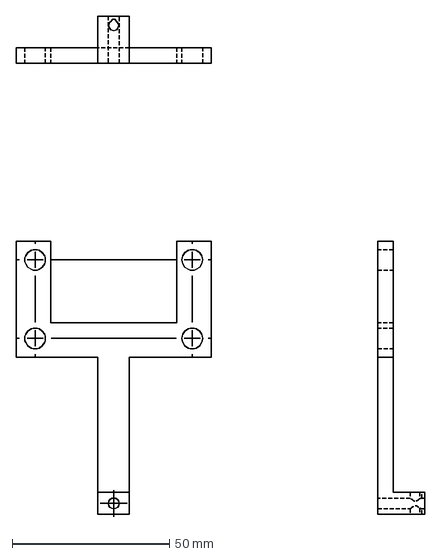
[picture p53: CAD file, 2012-07-30]
cnc/v1_14x14/electrode_arm/failed_head/w_to_tdt_fordxf.DXF
130.0 x 159.3 mm
