coxlab/physiology_rig/implants/kinematic_mount/hats/D/TricornerHatD.SLDPRT

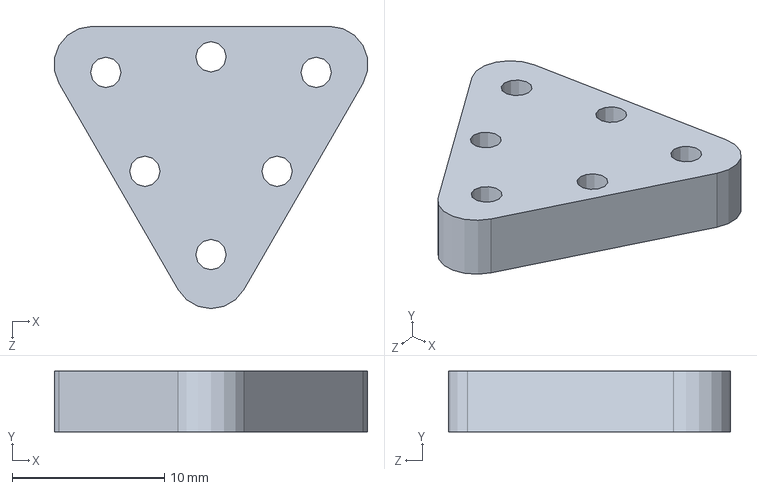
[picture p55: CAD file, 2012-07-30]
implants/kinematic_mount/hats/D/TricornerHatD.SLDPRT
20.6 x 4.00 x 18.6 mm
