coxlab/physiology_rig/implants/kinematic_mount/hats/E/TricornerHatE_fordxf_am.DXF

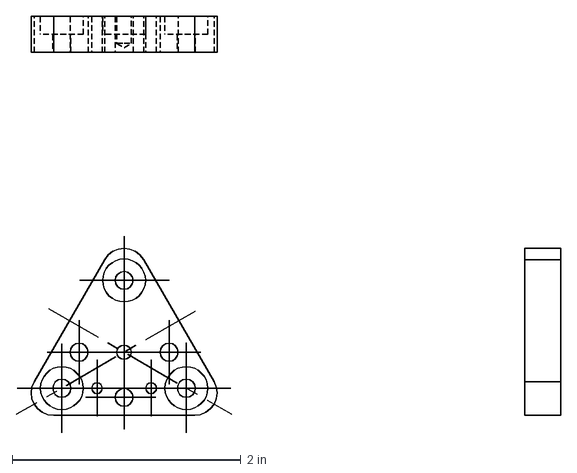
[picture p56: CAD file, 2012-07-30]
implants/kinematic_mount/hats/E/TricornerHatE_fordxf_am.DXF
4.76 x 3.64 in
