coxlab/physiology_rig/implants/kinematic_mount/hats/F/TricornerHatF_nodims.dxf

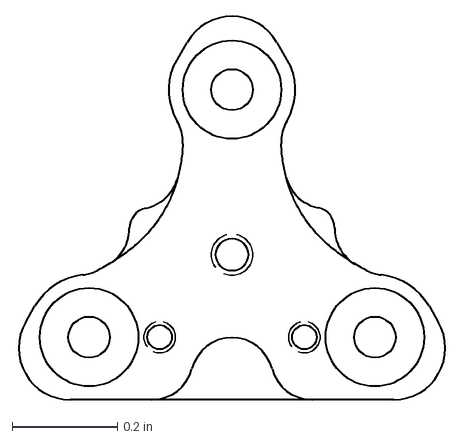
[picture p57: CAD file, 2012-07-30]
implants/kinematic_mount/hats/F/TricornerHatF_nodims.dxf
0.822 x 0.73 in
