coxlab/physiology_rig/implants/kinematic_mount/magnet_chuck_redesign/simple_chuck_force_bridge_no_dims.dxf

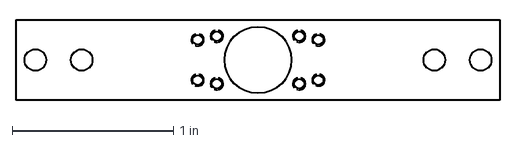
[picture p58: CAD file, 2012-07-30]
implants/kinematic_mount/magnet_chuck_redesign/simple_chuck_force_bridge_no_dims.dxf
3.00 x 0.5 in
