coxlab/physiology_rig/implants/kinematic_mount/seat/grid/TricornerSeat.SLDPRT

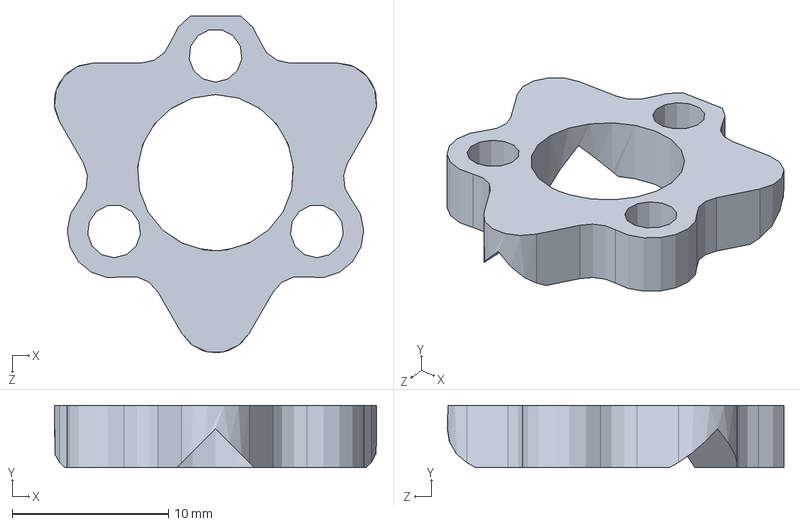
[picture p59: CAD file, 2012-07-30]
implants/kinematic_mount/seat/grid/TricornerSeat.SLDPRT
20.6 x 4.00 x 21.6 mm
