coxlab/physiology_rig/implants/kinematic_mount/test_jig/tricorner_test_rig.SLDPRT

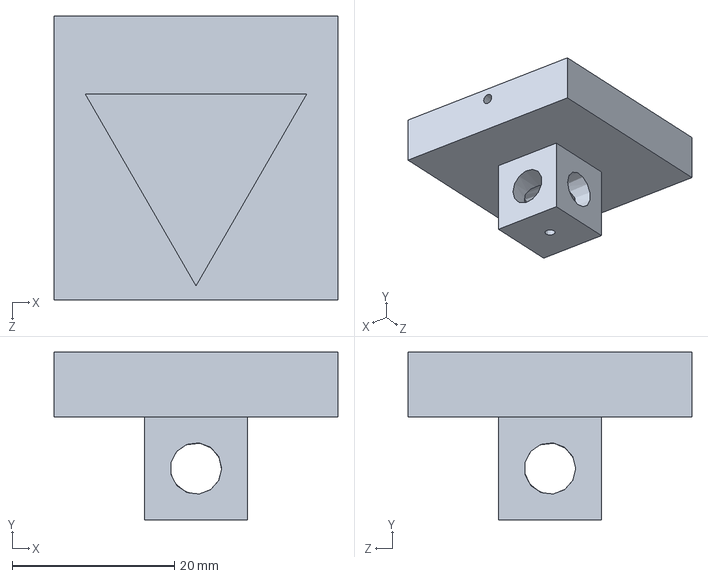
[picture p60: CAD file, 2012-07-30]
implants/kinematic_mount/test_jig/tricorner_test_rig.SLDPRT
35.0 x 20.7 x 35.0 mm
