coxlab/physiology_rig/implants/windows/rectangle/E/inventor/rectangle_window_E_dims.dxf

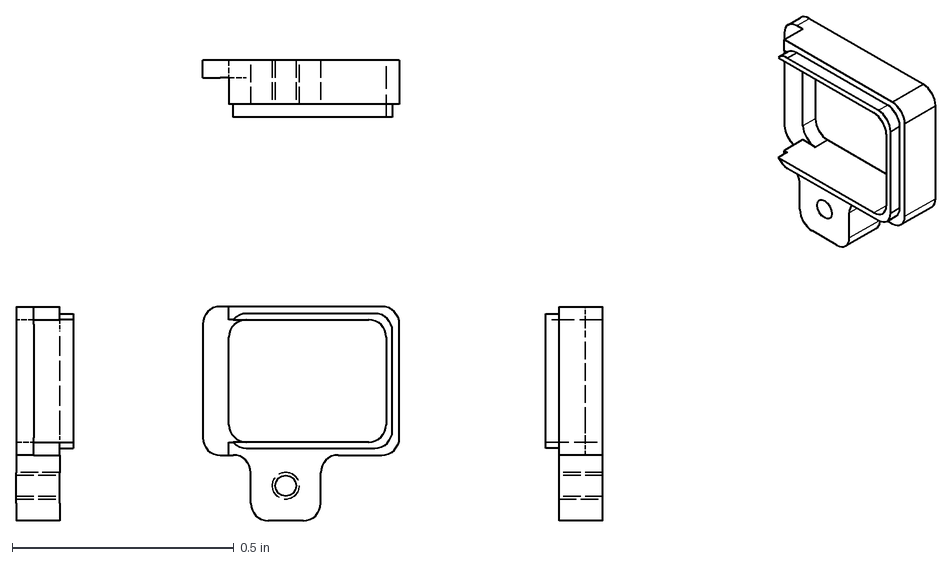
[picture p62: CAD file, 2012-07-30]
implants/windows/rectangle/E/inventor/rectangle_window_E_dims.dxf
2.07 x 1.14 in
