coxlab/physiology_rig/implants/windows/rectangle/E/rectangle_lid_E.dxf

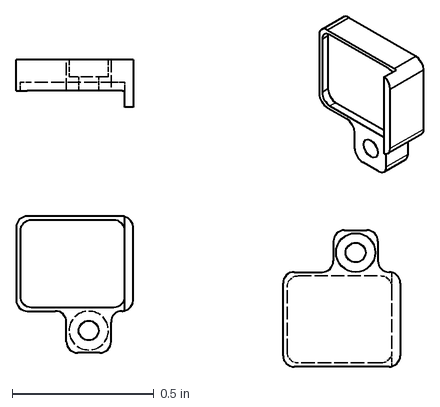
[picture p63: CAD file, 2012-07-30]
implants/windows/rectangle/E/rectangle_lid_E.dxf
1.44 x 1.24 in
