coxlab/physiology_rig/implants/windows/square/A/8mmWindow_am.DXF

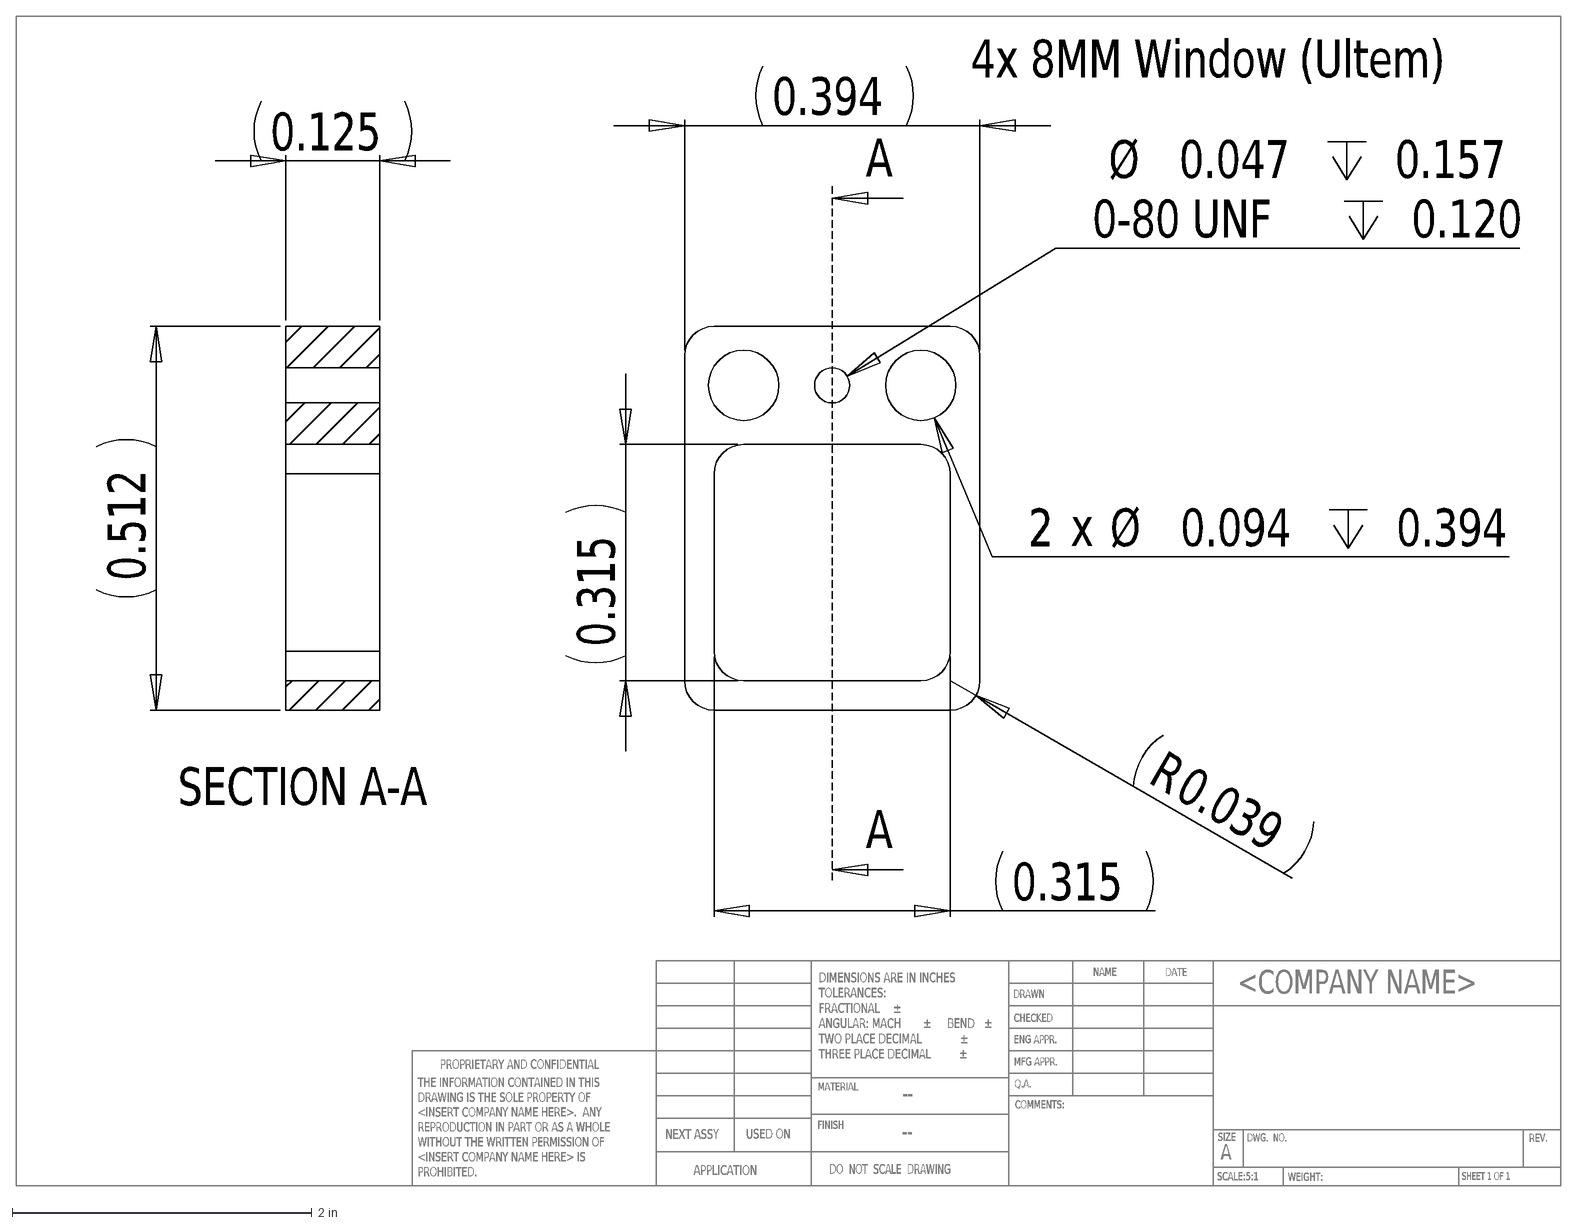
[picture p64: CAD file, 2012-07-30]
implants/windows/square/A/8mmWindow_am.DXF
4x 8MM Window (Ultem)
<COMPANY NAME>
SCALE:5:1
SIZE
DWG. NO.
A
REV.
MATERIAL
FINISH
--
DO NOT SCALE DRAWING
APPLICATION
USED ON
NEXT ASSY
DIMENSIONS ARE IN INCHES
TOLERANCES:
FRACTIONAL
±
ANGULAR: MACH
BEND
TWO PLACE DECIMAL
THREE PLACE DECIMAL
NAME
DATE
DRAWN
CHECKED
ENG APPR.
MFG APPR.
Q.A.
SHEET 1 OF 1
WEIGHT:
COMMENTS:
THE INFORMATION CONTAINED IN THIS
DRAWING IS THE SOLE PROPERTY OF
<INSERT COMPANY NAME HERE>. ANY
REPRODUCTION IN PART OR AS A WHOLE
WITHOUT THE WRITTEN PERMISSION OF
<INSERT COMPANY NAME HERE> IS
PROHIBITED.
PROPRIETARY AND CONFIDENTIAL
0.315
R
0.039
0.394
0-80 UNF
0.120
Ø
0.047
0.157
2
x
0.094
0.125
0.512
SECTION A-A
