coxlab/physiology_rig/implants/windows/square/B/7mmWindowB.SLDPRT

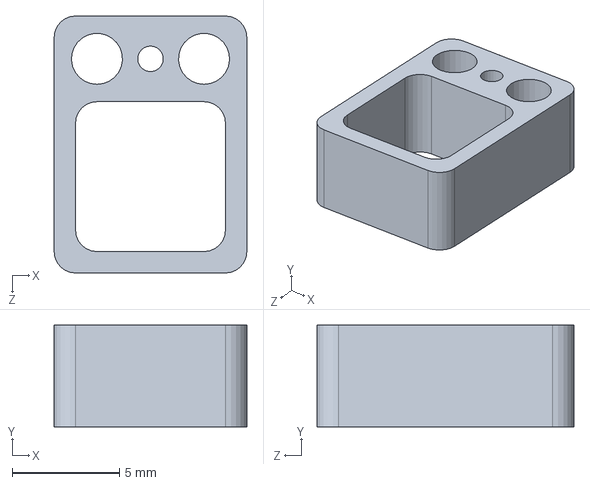
[picture p65: CAD file, 2012-07-30]
implants/windows/square/B/7mmWindowB.SLDPRT
9.00 x 4.76 x 12.0 mm
