coxlab/physiology_rig/implants/windows/square/C/7mmPanelC.SLDPRT

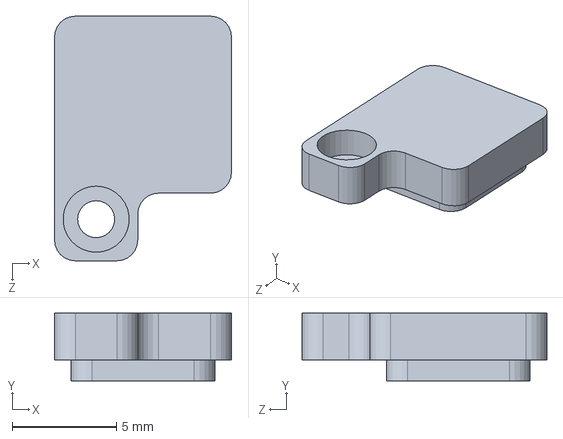
[picture p66: CAD file, 2012-07-30]
implants/windows/square/C/7mmPanelC.SLDPRT
8.50 x 3.25 x 11.8 mm
