coxlab/physiology_rig/implants/windows/wide/a_0.5mm_wall/base.dxf

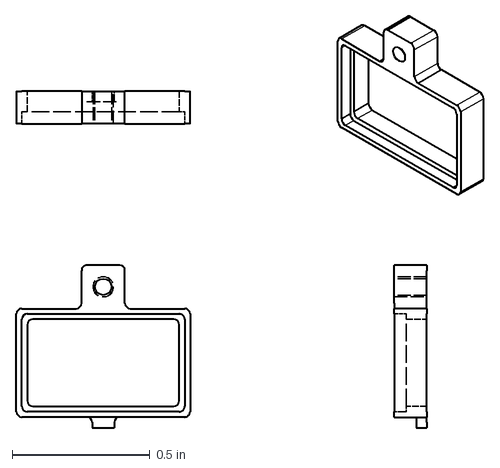
[picture p67: CAD file, 2012-07-30]
implants/windows/wide/a_0.5mm_wall/base.dxf
1.69 x 1.49 in
