coxlab/physiology_rig/implants/windows/wide/b_1mm_wall/base.dxf

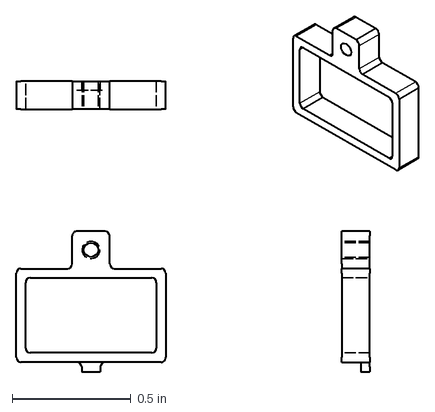
[picture p68: CAD file, 2012-07-30]
implants/windows/wide/b_1mm_wall/base.dxf
1.69 x 1.49 in
