coxlab/physiology_rig/implants/windows/wide/c_7mm_0.5mm_wall/base.dxf

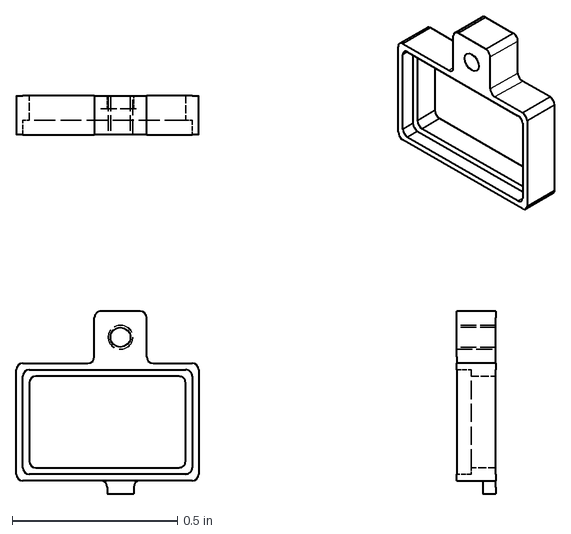
[picture p69: CAD file, 2012-07-30]
implants/windows/wide/c_7mm_0.5mm_wall/base.dxf
1.63 x 1.44 in
