coxlab/physiology_rig/cnc/v1_14x14/electrode_arm/failed_head/w_to_ripple.SLDPRT

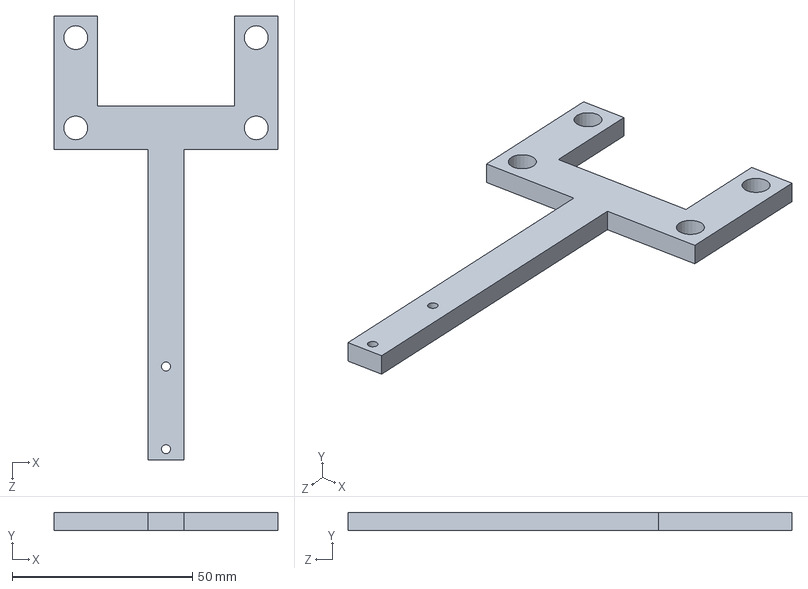
[picture p70: CAD file, 2012-07-30]
cnc/v1_14x14/electrode_arm/failed_head/w_to_ripple.SLDPRT
62.0 x 5.00 x 123.0 mm
