coxlab/physiology_rig/implants/kinematic_mount/hats/E/TricornerHatE_fordxf.DXF

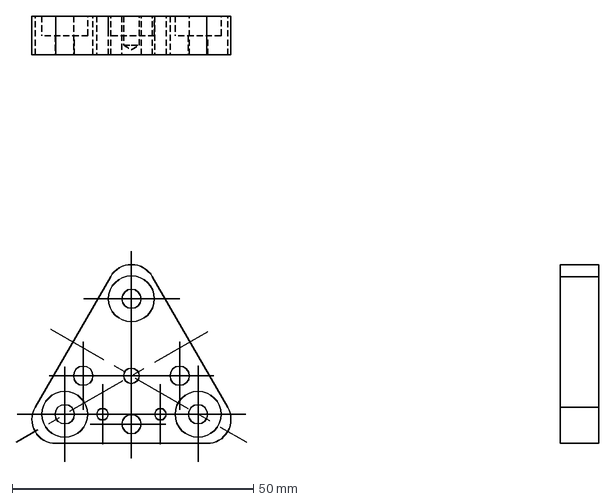
[picture p71: CAD file, 2012-07-30]
implants/kinematic_mount/hats/E/TricornerHatE_fordxf.DXF
120.8 x 92.4 mm
