coxlab/physiology_rig/implants/kinematic_mount/hats/F/TricornerHatF.dxf

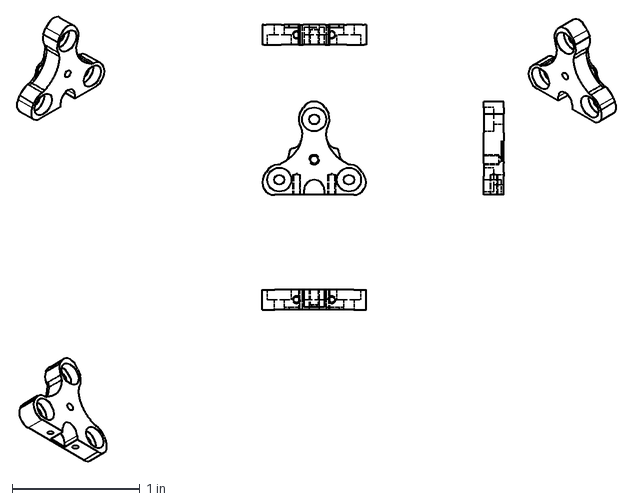
[picture p72: CAD file, 2012-07-30]
implants/kinematic_mount/hats/F/TricornerHatF.dxf
4.70 x 3.48 in
