coxlab/physiology_rig/implants/windows/rectangle/A/rectangle.SLDPRT

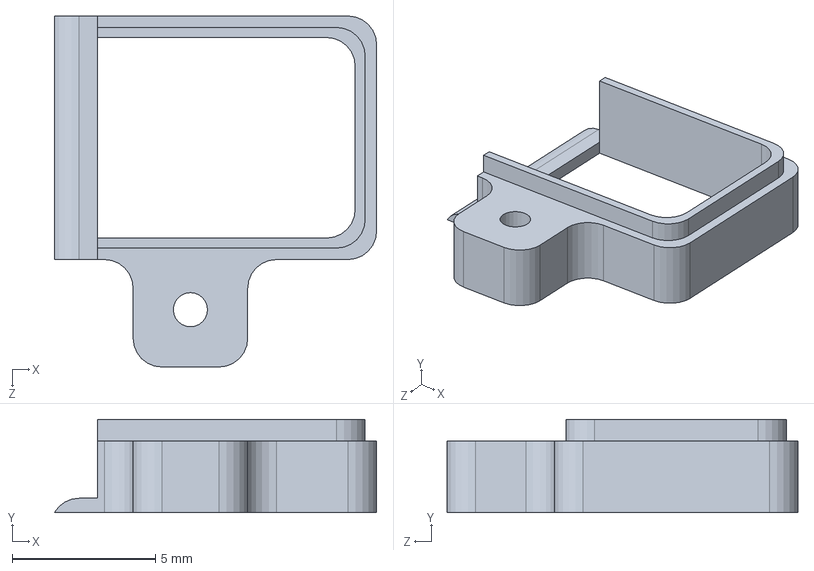
[picture p73: CAD file, 2012-07-30]
implants/windows/rectangle/A/rectangle.SLDPRT
11.2 x 3.25 x 12.3 mm
