coxlab/physiology_rig/implants/windows/rectangle/B/rectangle_lid_B_nodims.DXF

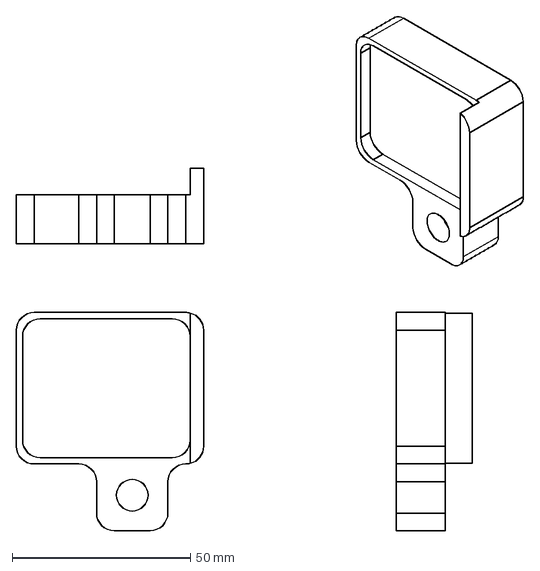
[picture p74: CAD file, 2012-07-30]
implants/windows/rectangle/B/rectangle_lid_B_nodims.DXF
142.3 x 144.4 mm
