coxlab/physiology_rig/implants/windows/rectangle/C/rectangle_lid_C_nodims.DXF

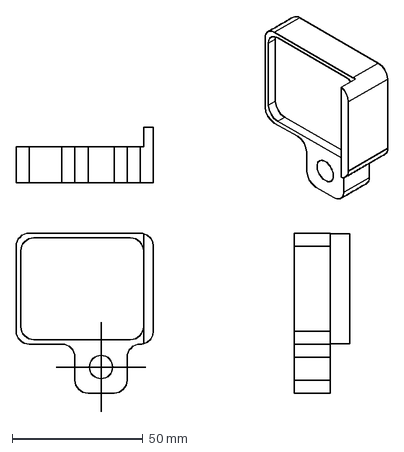
[picture p75: CAD file, 2012-07-30]
implants/windows/rectangle/C/rectangle_lid_C_nodims.DXF
142.3 x 151.5 mm
