coxlab/physiology_rig/implants/windows/square/D/7mmLidD.DXF

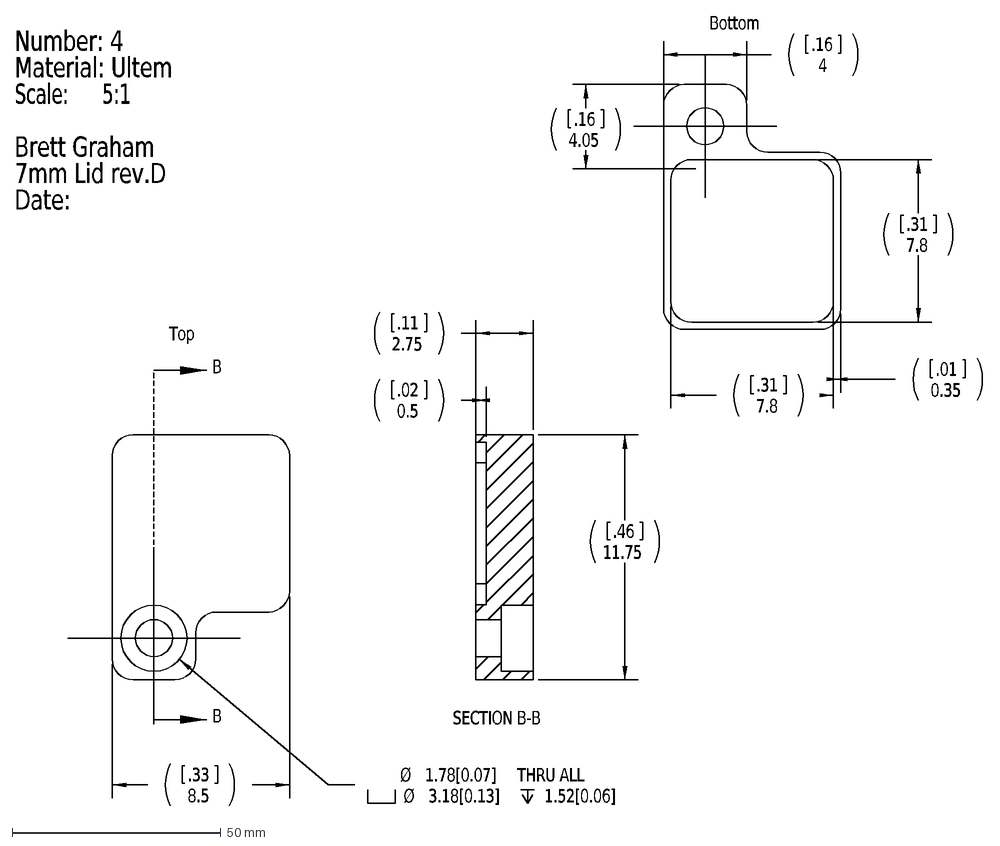
[picture p77: CAD file, 2012-07-30]
implants/windows/square/D/7mmLidD.DXF
Number: 4
Material: Ultem
Scale: 5:1
Brett Graham
7mm Lid rev.D
Date:
Bottom
Top
8.5
.33
Ø
3.18[0.13]
1.52[0.06]
1.78[0.07]
THRU ALL
B
4
.16
4.05
7.8
.31
0.35
.01
11.75
.46
2.75
.11
0.5
.02
SECTION B-B
