coxlab/physiology_rig/two_photon/objective/N20X-PFH-AutoCADDXF.dxf

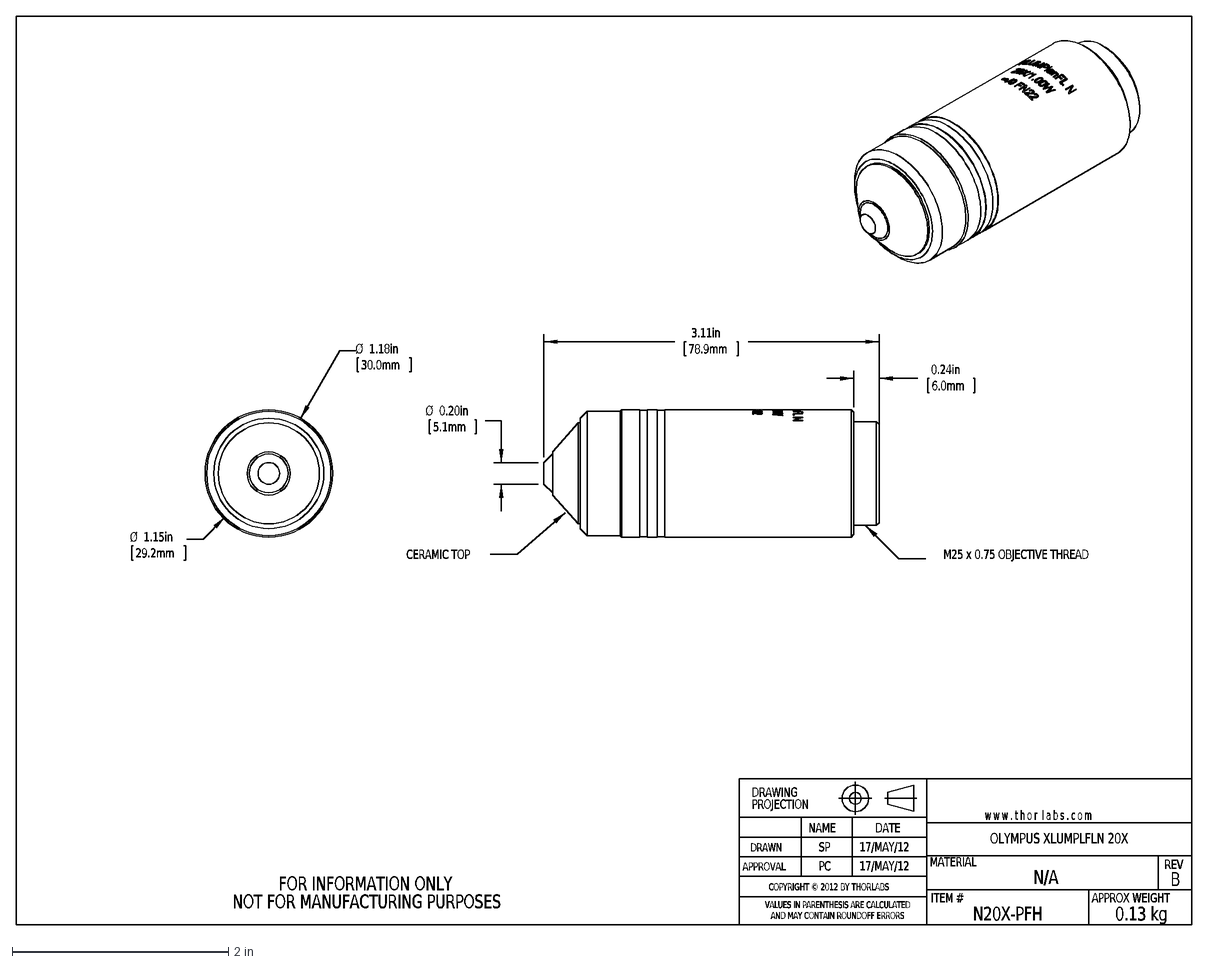
[picture p78: CAD file, 2013-04-24]
two_photon/objective/N20X-PFH-AutoCADDXF.dxf
B
N20X-PFH
MATERIAL
DRAWN
APPROVAL
REV
SP
PC
17/MAY/12
DATE
w w w . t h o r l a b s . c o m
ITEM #
APPROX WEIGHT
N/A
0.13 kg
VALUES IN PARENTHESIS ARE CALCULATED
AND MAY CONTAIN ROUNDOFF ERRORS
DRAWING
PROJECTION
NAME
FOR INFORMATION ONLY
NOT FOR MANUFACTURING PURPOSES
OLYMPUS XLUMPLFLN 20X
COPYRIGHT © 2012 BY THORLABS
Ø
1.18in
30.0mm
1.15in
29.2mm
0.24in
6.0mm
0.20in
5.1mm
3.11in
78.9mm
CERAMIC TOP
M25 x 0.75 OBJECTIVE THREAD
