coxlab/physiology_rig/implants/windows/rectangle/A/rectangle_window_B_nodims.DXF

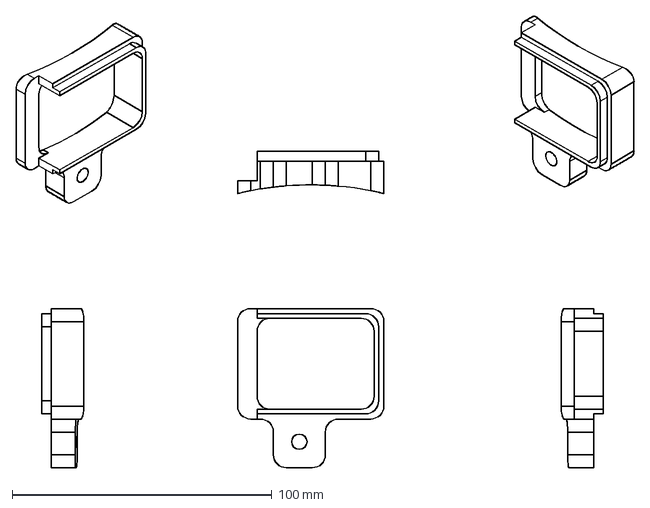
[picture p80: CAD file, 2012-07-30]
implants/windows/rectangle/A/rectangle_window_B_nodims.DXF
237.7 x 173.7 mm
