coxlab/physiology_rig/implants/windows/rectangle/C/rectangle_window_C_nodims.DXF

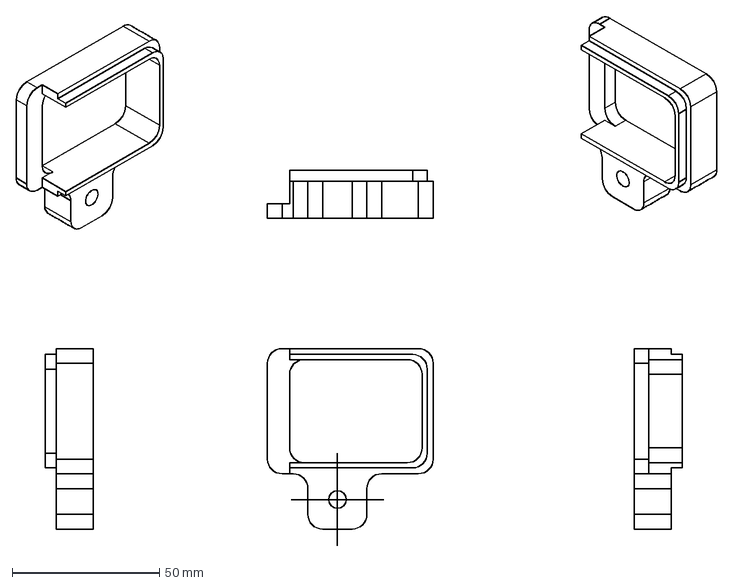
[picture p81: CAD file, 2012-07-30]
implants/windows/rectangle/C/rectangle_window_C_nodims.DXF
237.9 x 179.7 mm
