coxlab/physiology_rig/implants/windows/square/A/8mmPanel_am.DXF

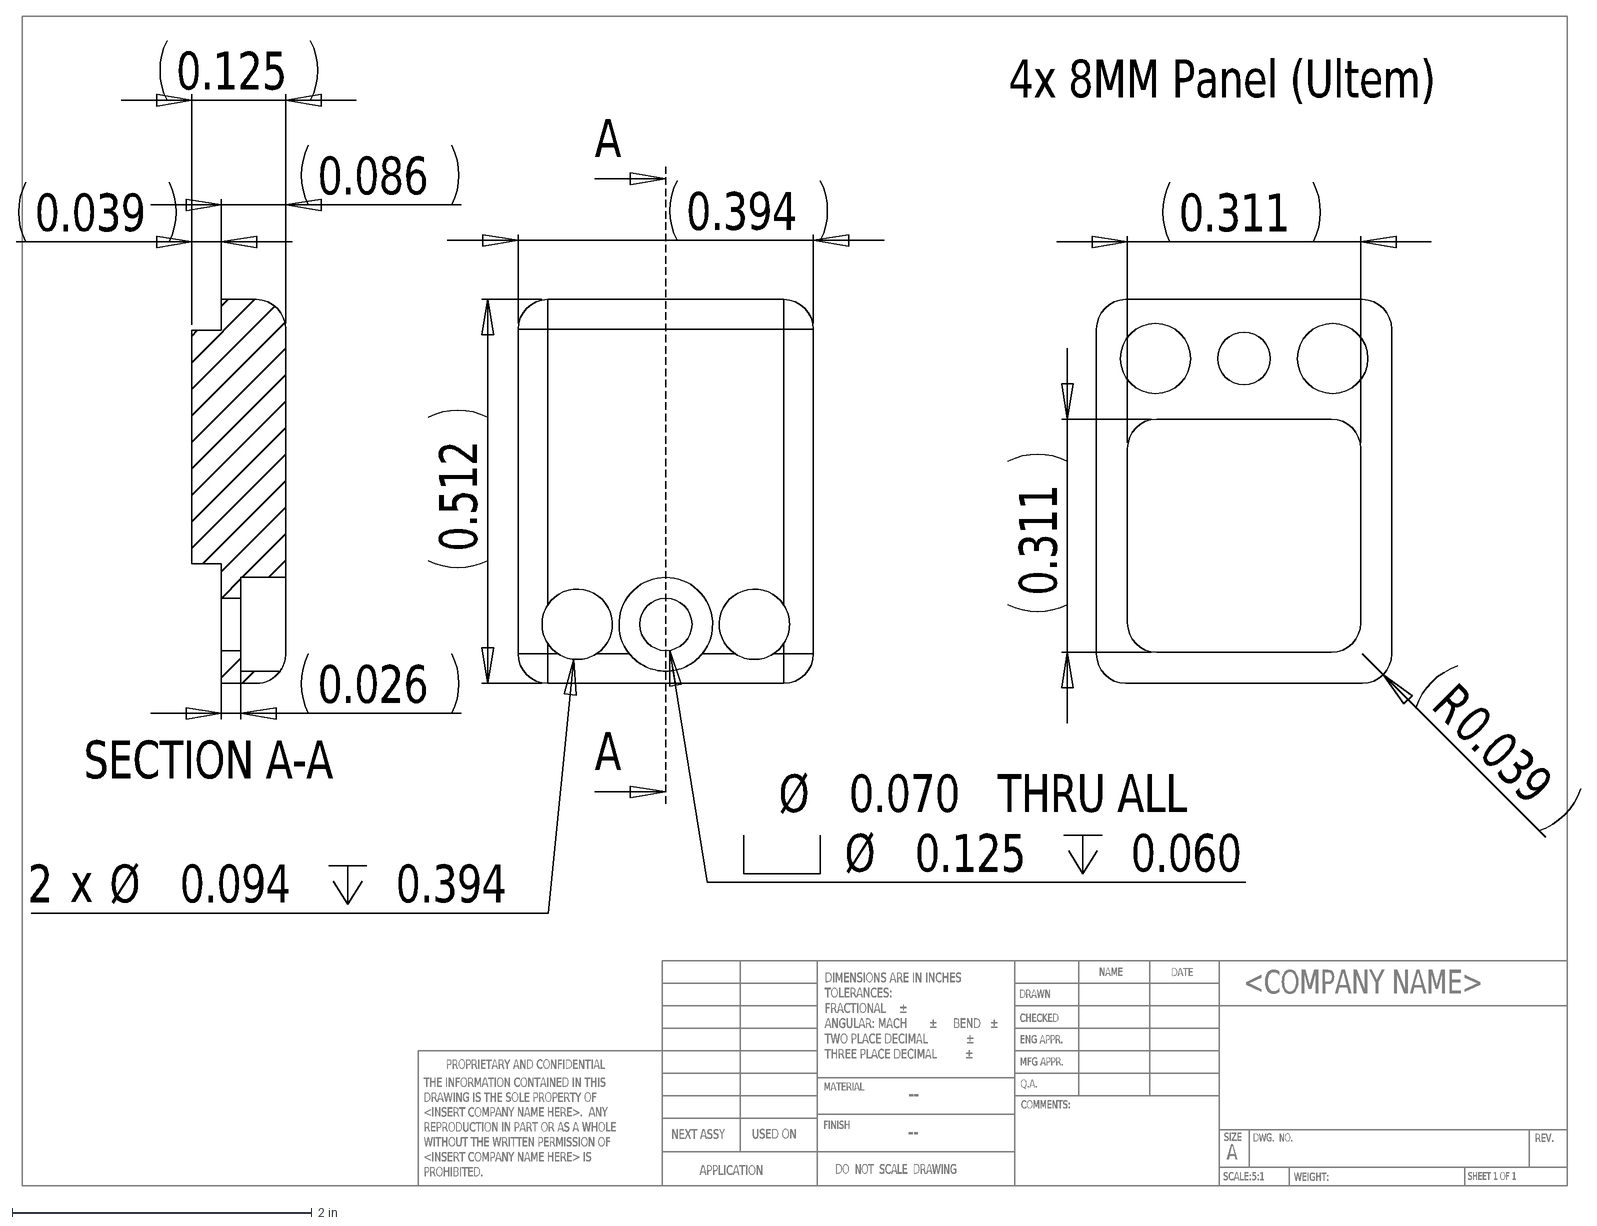
[picture p82: CAD file, 2012-07-30]
implants/windows/square/A/8mmPanel_am.DXF
4x 8MM Panel (Ultem)
<COMPANY NAME>
SCALE:5:1
SIZE
DWG. NO.
A
REV.
MATERIAL
FINISH
--
DO NOT SCALE DRAWING
APPLICATION
USED ON
NEXT ASSY
DIMENSIONS ARE IN INCHES
TOLERANCES:
FRACTIONAL
±
ANGULAR: MACH
BEND
TWO PLACE DECIMAL
THREE PLACE DECIMAL
NAME
DATE
DRAWN
CHECKED
ENG APPR.
MFG APPR.
Q.A.
SHEET 1 OF 1
WEIGHT:
COMMENTS:
THE INFORMATION CONTAINED IN THIS
DRAWING IS THE SOLE PROPERTY OF
<INSERT COMPANY NAME HERE>. ANY
REPRODUCTION IN PART OR AS A WHOLE
WITHOUT THE WRITTEN PERMISSION OF
<INSERT COMPANY NAME HERE> IS
PROHIBITED.
PROPRIETARY AND CONFIDENTIAL
0.311
R
0.039
0.394
0.512
2
x
Ø
0.094
0.125
0.060
0.070
THRU ALL
0.086
0.026
SECTION A-A
