coxlab/physiology_rig/implants/windows/square/D/7mmPanelC.SLDPRT

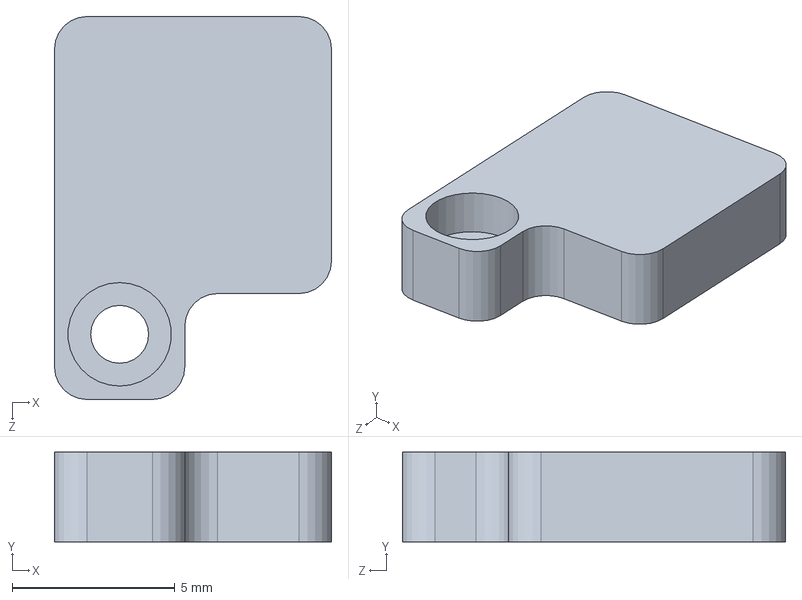
[picture p83: CAD file, 2012-07-30]
implants/windows/square/D/7mmPanelC.SLDPRT
8.50 x 2.75 x 11.8 mm
