coxlab/physiology_rig/cnc/v1_14x14/electrode_arm/failed_head/w_to_ripple_fordxf.DXF

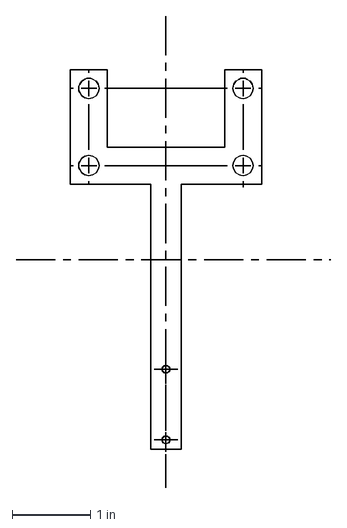
[picture p84: CAD file, 2012-07-30]
cnc/v1_14x14/electrode_arm/failed_head/w_to_ripple_fordxf.DXF
4.02 x 6.03 in
