coxlab/physiology_rig/implants/windows/rectangle/B/rectangle_lid.SLDPRT

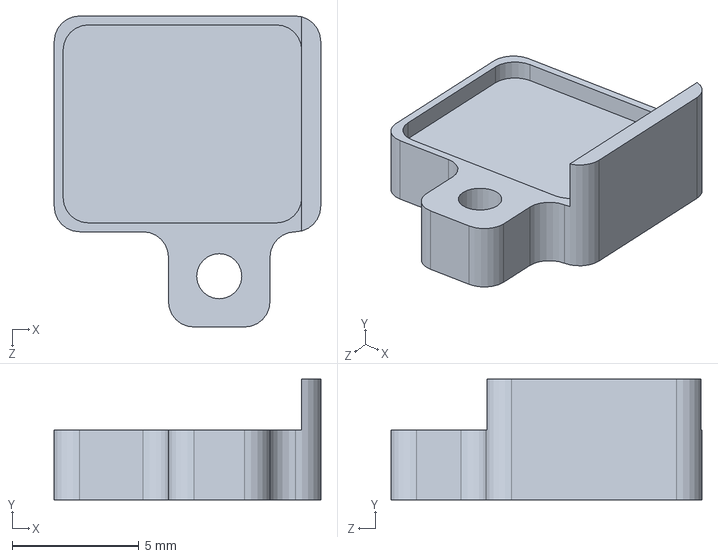
[picture p85: CAD file, 2012-07-30]
implants/windows/rectangle/B/rectangle_lid.SLDPRT
10.5 x 4.75 x 12.3 mm
