coxlab/physiology_rig/implants/windows/square/A/7mmPanel_am.DXF

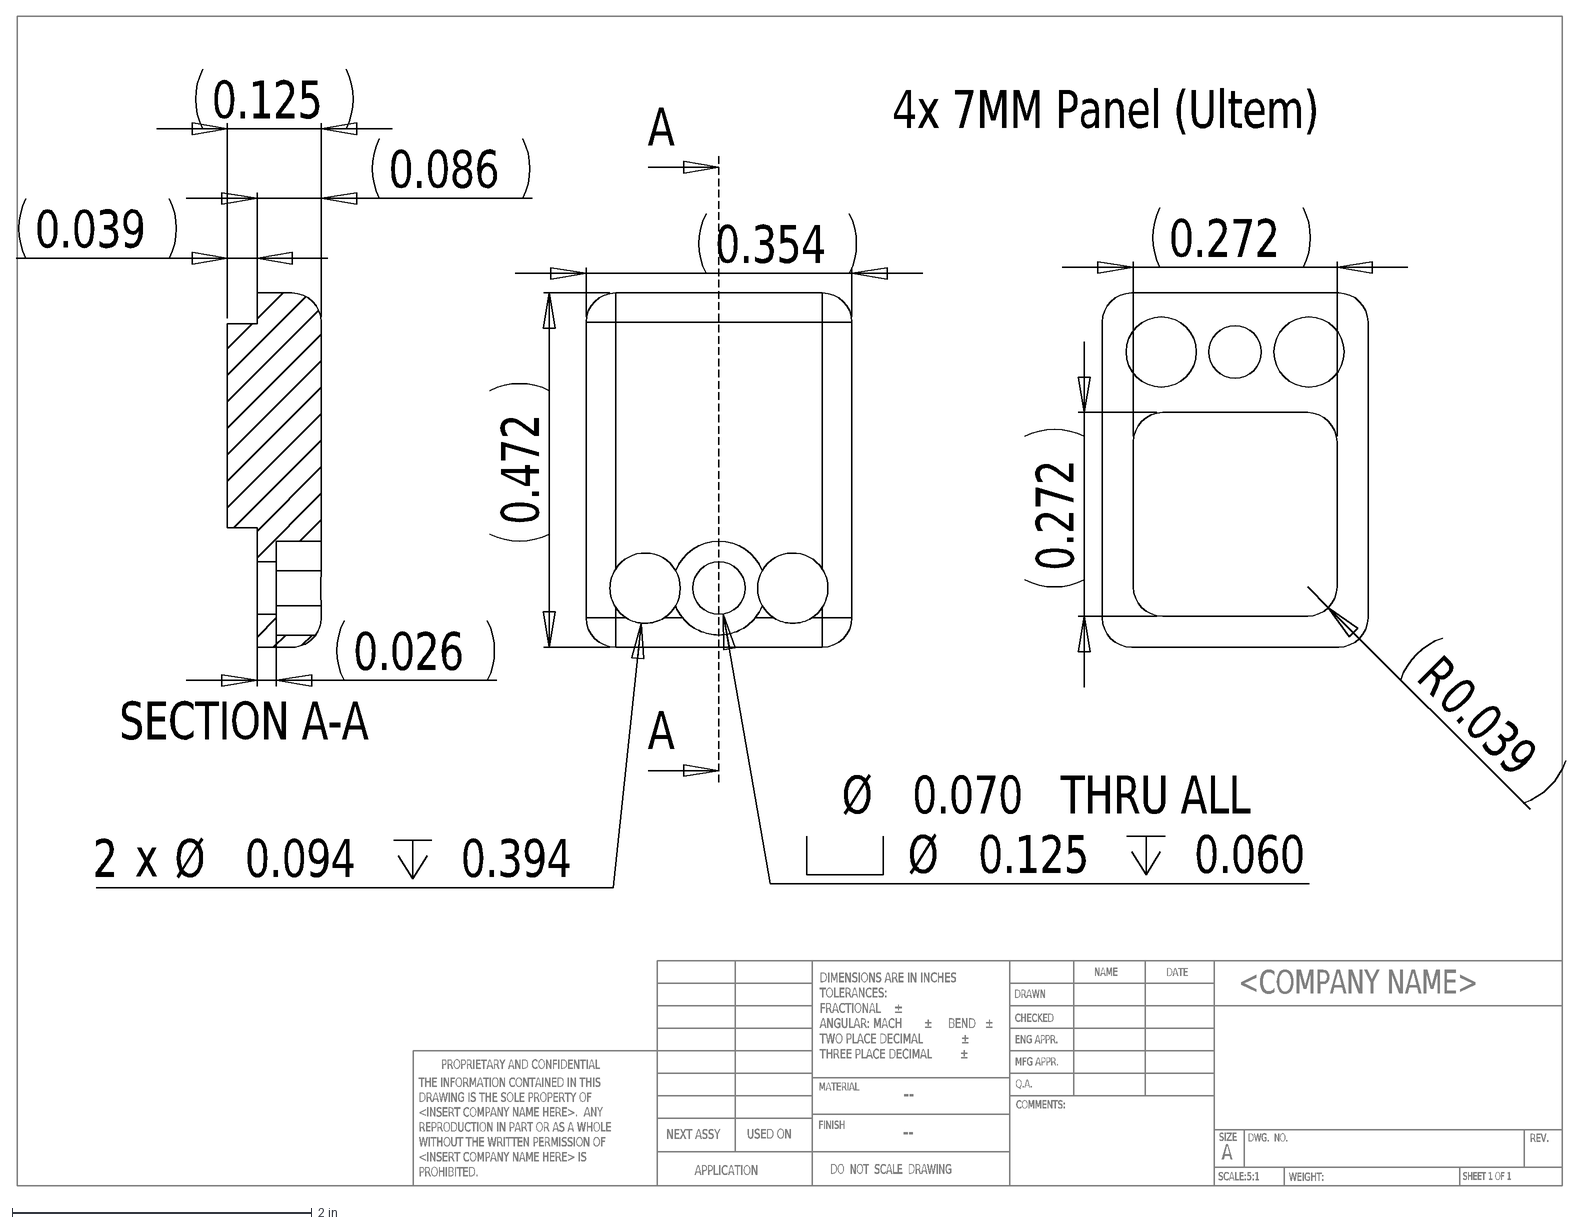
[picture p86: CAD file, 2012-07-30]
implants/windows/square/A/7mmPanel_am.DXF
4x 7MM Panel (Ultem)
<COMPANY NAME>
SCALE:5:1
SIZE
DWG. NO.
A
REV.
MATERIAL
FINISH
--
DO NOT SCALE DRAWING
APPLICATION
USED ON
NEXT ASSY
DIMENSIONS ARE IN INCHES
TOLERANCES:
FRACTIONAL
±
ANGULAR: MACH
BEND
TWO PLACE DECIMAL
THREE PLACE DECIMAL
NAME
DATE
DRAWN
CHECKED
ENG APPR.
MFG APPR.
Q.A.
SHEET 1 OF 1
WEIGHT:
COMMENTS:
THE INFORMATION CONTAINED IN THIS
DRAWING IS THE SOLE PROPERTY OF
<INSERT COMPANY NAME HERE>. ANY
REPRODUCTION IN PART OR AS A WHOLE
WITHOUT THE WRITTEN PERMISSION OF
<INSERT COMPANY NAME HERE> IS
PROHIBITED.
PROPRIETARY AND CONFIDENTIAL
0.272
R
0.039
0.354
0.472
2
x
Ø
0.094
0.394
0.125
0.060
0.070
THRU ALL
0.086
0.026
SECTION A-A
