coxlab/physiology_rig/cnc/v1_14x14/electrode_arm/failed_head/w_to_tdt.SLDPRT

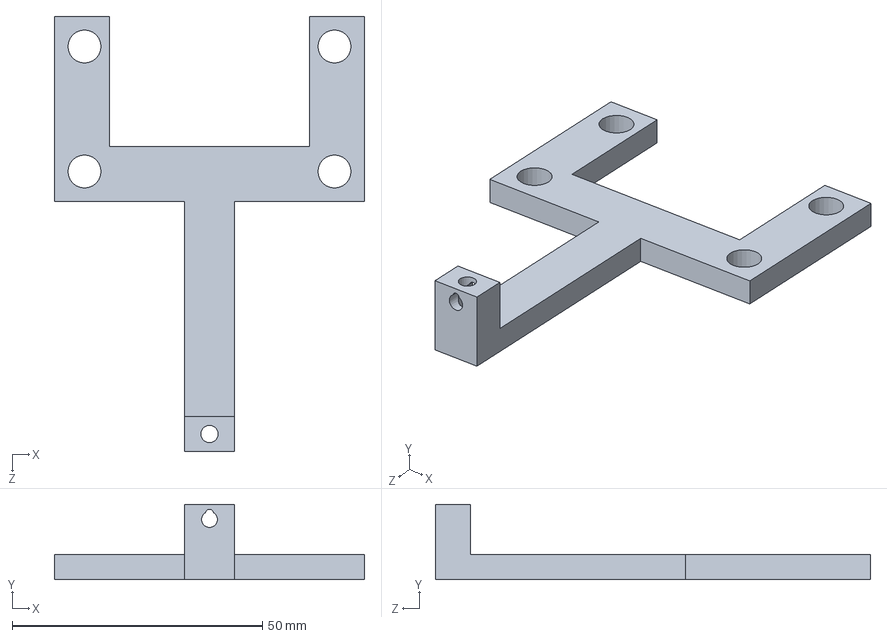
[picture p87: CAD file, 2012-07-30]
cnc/v1_14x14/electrode_arm/failed_head/w_to_tdt.SLDPRT
62.0 x 15.0 x 87.0 mm
