coxlab/physiology_rig/implants/windows/square/A/7mmWindow.SLDPRT

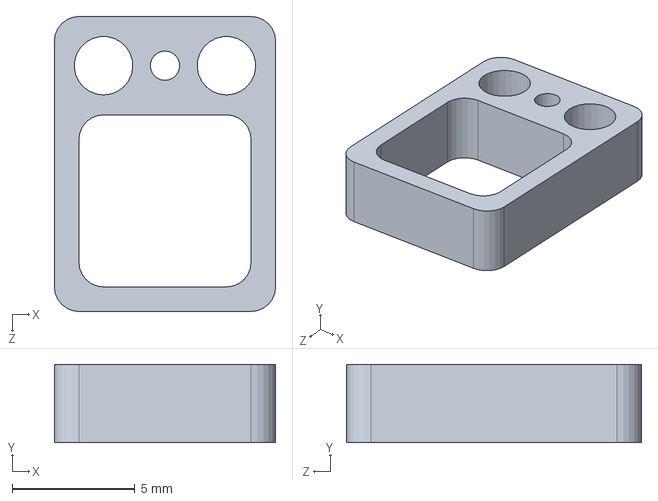
[picture p88: CAD file, 2012-07-30]
implants/windows/square/A/7mmWindow.SLDPRT
9.00 x 3.17 x 12.0 mm
