coxlab/physiology_rig/cnc/v1_14x14/electrode_arm/failed_head/test.DXF

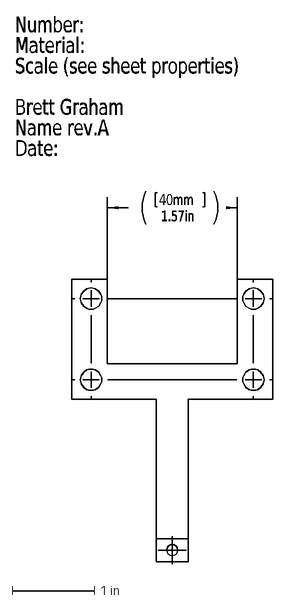
[picture p89: CAD file, 2012-07-30]
cnc/v1_14x14/electrode_arm/failed_head/test.DXF
Number:
Material:
Scale (see sheet properties)
Brett Graham
Name rev.A
Date:
1.57in
40mm
