coxlab/physiology_rig/cnc/v1_14x14/electrode_arm/failed_head/b_to_w.SLDPRT

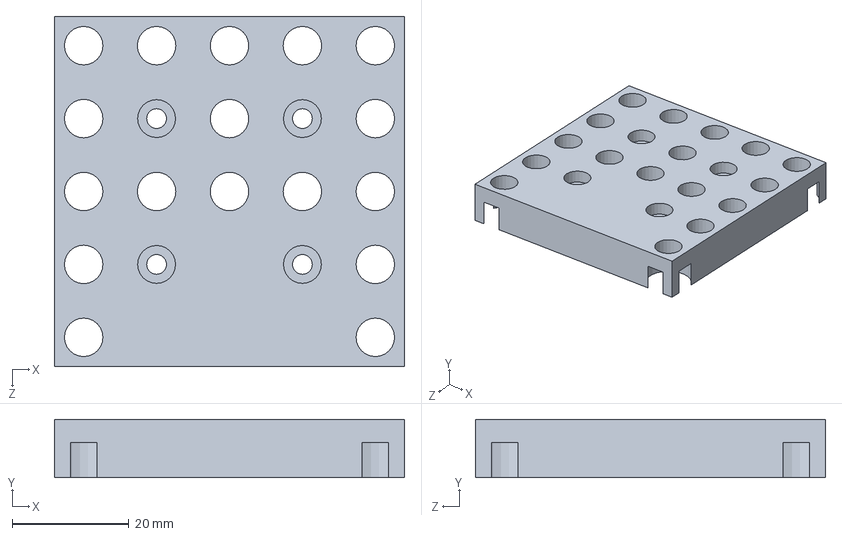
[picture p91: CAD file, 2012-07-30]
cnc/v1_14x14/electrode_arm/failed_head/b_to_w.SLDPRT
60.0 x 10.0 x 60.0 mm
