coxlab/physiology_rig/implants/windows/square/A/8mmPanel.SLDPRT

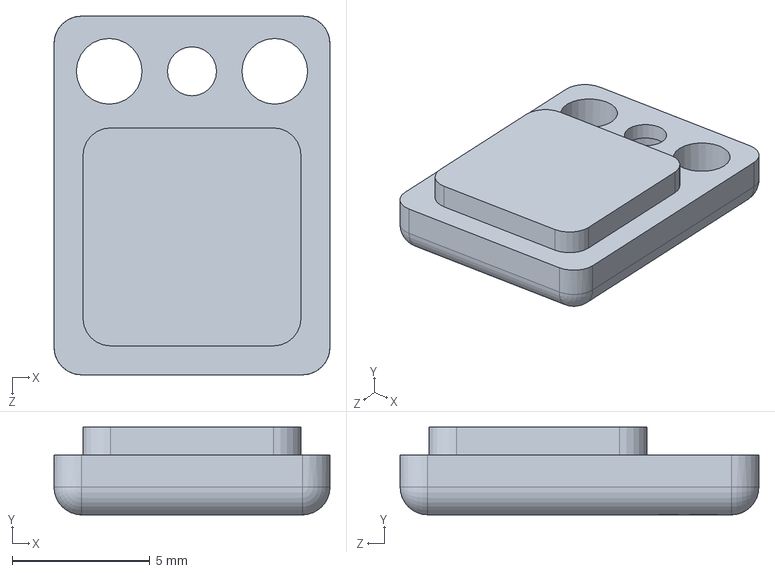
[picture p92: CAD file, 2012-07-30]
implants/windows/square/A/8mmPanel.SLDPRT
10.0 x 3.17 x 13.0 mm
