coxlab/physiology_rig/cnc/v1_14x14/electrode_arm/failed_head/b_to_w_v3_fordxf.DXF

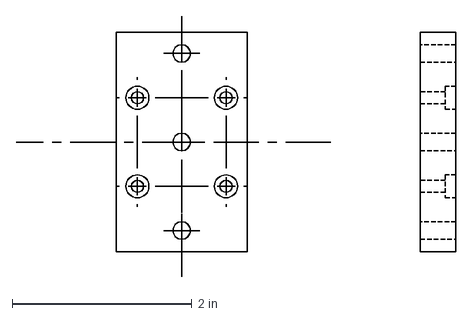
[picture p93: CAD file, 2012-07-30]
cnc/v1_14x14/electrode_arm/failed_head/b_to_w_v3_fordxf.DXF
4.89 x 2.90 in
