coxlab/physiology_rig/cnc/v1_14x14/electrode_arm/failed_head/fake_stage.SLDPRT

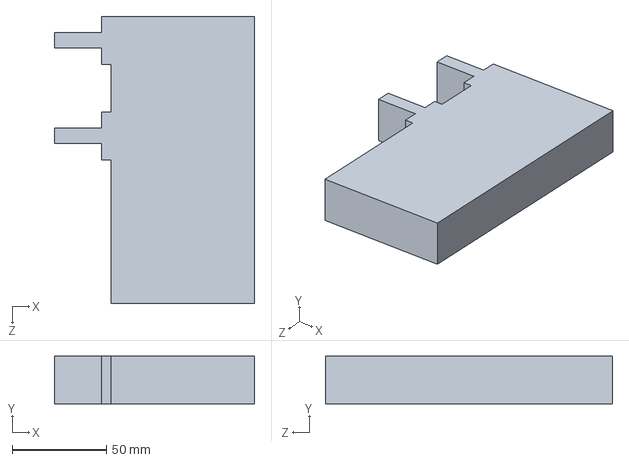
[picture p94: CAD file, 2012-07-30]
cnc/v1_14x14/electrode_arm/failed_head/fake_stage.SLDPRT
106.2 x 25.4 x 152.4 mm
