coxlab/physiology_rig/cnc/v1_14x14/electrode_arm/failed_head/b_to_w_v3.SLDPRT

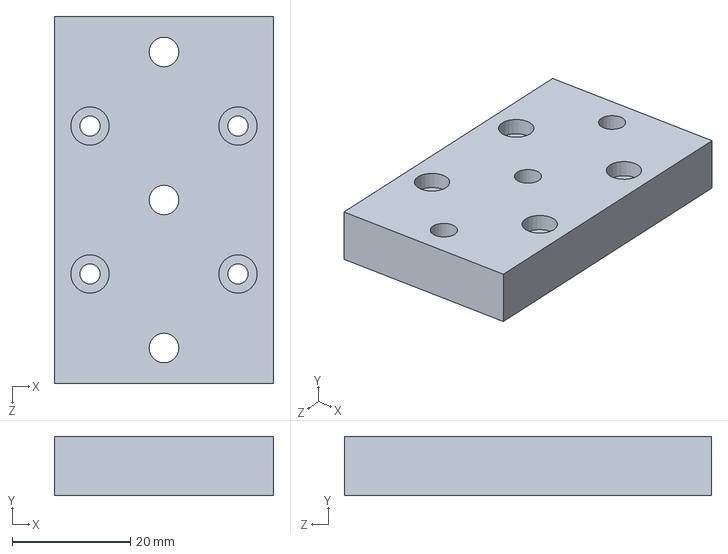
[picture p95: CAD file, 2012-07-30]
cnc/v1_14x14/electrode_arm/failed_head/b_to_w_v3.SLDPRT
37.0 x 10.0 x 62.0 mm
