coxlab/physiology_rig/(list of files, cad)

Other CAD files:
implants/windows/rectangle/D/rectangle_window_D.SLDPRT
implants/windows/square/B/7mmPanelB.SLDPRT
implants/windows/rectangle/C/rectangle_lid_C.SLDPRT
implants/windows/rectangle/D/rectangle_lid_D.SLDPRT
implants/windows/square/D/7mmWindowC.SLDPRT
structured_light/reference_plate/tricorner_registration_plate.SLDPRT
two_photon/objective/N20X-PFH-Step.step
implants/windows/rectangle/A/rectangle_window.SLDPRT
cnc/v1_14x14/commercial_parts/8020/8020-25-2525.ipt
cnc/v1_14x14/commercial_parts/8020/8020-40-4040-Lite.ipt
cnc/v1_14x14/commercial_parts/my_nema_23.ipt
cnc/v1_14x14/commercial_parts/newport/Newport-SR50CC.SLDPRT
cnc/v1_14x14/commercial_parts/newport/newport_SR50CC.ipt
cnc/v1_14x14/commercial_parts/thorlabs/19760-E0W.step
cnc/v1_14x14/commercial_parts/thorlabs/thorlabs_w_stage.ipt
cnc/v1_14x14/electrode_arm/failed_head/b_to_w.DXF
cnc/v1_14x14/electrode_arm/failed_head/b_to_w.SLDDRW
cnc/v1_14x14/electrode_arm/failed_head/b_to_w_v2.DXF
cnc/v1_14x14/electrode_arm/failed_head/b_to_w_v2.SLDDRW
cnc/v1_14x14/electrode_arm/failed_head/b_to_w_v2.SLDPRT
cnc/v1_14x14/electrode_arm/failed_head/b_to_w_v2_fordxf.DXF
cnc/v1_14x14/electrode_arm/failed_head/b_to_w_v2_fordxf.SLDDRW
cnc/v1_14x14/electrode_arm/failed_head/b_to_w_v3.DXF
cnc/v1_14x14/electrode_arm/failed_head/b_to_w_v3.SLDDRW
cnc/v1_14x14/electrode_arm/failed_head/b_to_w_v3_fordxf.SLDDRW
cnc/v1_14x14/electrode_arm/failed_head/w_to_ripple.DXF
cnc/v1_14x14/electrode_arm/failed_head/w_to_ripple.SLDDRW
cnc/v1_14x14/electrode_arm/failed_head/w_to_ripple_fordxf.SLDDRW
cnc/v1_14x14/electrode_arm/failed_head/w_to_tdt.DXF
cnc/v1_14x14/electrode_arm/failed_head/w_to_tdt.SLDDRW
cnc/v1_14x14/electrode_arm/failed_head/w_to_tdt_fordxf.SLDDRW
cnc/v1_14x14/electrode_arm/head_assembly.iam
cnc/v1_14x14/electrode_arm/ripple_arm.ipt
cnc/v1_14x14/electrode_arm/tdt_arm.ipt
cnc/v1_14x14/electrode_arm/tdt_holder.ipt
cnc/v1_14x14/electrode_arm/tdt_preamp_mount/preamp_mount.DXF
cnc/v1_14x14/electrode_arm/tdt_preamp_mount/preamp_mount.SLDDRW
cnc/v1_14x14/electrode_arm/thorlabs_cnc_head/19760-E0W.sldprt
cnc/v1_14x14/electrode_arm/thorlabs_cnc_head/b_plate.DXF
cnc/v1_14x14/electrode_arm/thorlabs_cnc_head/b_plate.SLDDRW
cnc/v1_14x14/electrode_arm/thorlabs_cnc_head/b_plate.SLDPRT
cnc/v1_14x14/electrode_arm/thorlabs_cnc_head/b_plate_fordxf.DXF
cnc/v1_14x14/electrode_arm/thorlabs_cnc_head/b_plate_fordxf.SLDDRW
cnc/v1_14x14/electrode_arm/thorlabs_cnc_head/ripple_arm.SLDDRW
cnc/v1_14x14/electrode_arm/thorlabs_cnc_head/ripple_arm.SLDPRT
cnc/v1_14x14/electrode_arm/thorlabs_cnc_head/ripple_arm_for_dxf.DXF
cnc/v1_14x14/electrode_arm/thorlabs_cnc_head/ripple_arm_for_dxf.SLDDRW
cnc/v1_14x14/electrode_arm/thorlabs_cnc_head/ripple_to_tdt.SLDDRW
cnc/v1_14x14/electrode_arm/thorlabs_cnc_head/ripple_to_tdt.SLDPRT
cnc/v1_14x14/electrode_arm/thorlabs_cnc_head/ripple_to_tdt_for_dxf.DXF
cnc/v1_14x14/electrode_arm/thorlabs_cnc_head/ripple_to_tdt_for_dxf.SLDDRW
cnc/v1_14x14/electrode_arm/thorlabs_cnc_head/tdt_arm.SLDDRW
cnc/v1_14x14/electrode_arm/thorlabs_cnc_head/tdt_arm.SLDPRT
cnc/v1_14x14/electrode_arm/thorlabs_cnc_head/tdt_holder.DXF
cnc/v1_14x14/electrode_arm/thorlabs_cnc_head/tdt_holder.SLDDRW
cnc/v1_14x14/electrode_arm/thorlabs_cnc_head/tdt_holder.SLDPRT
cnc/v1_14x14/electrode_arm/thorlabs_cnc_head/tdt_mount.SLDASM
cnc/v1_14x14/electrode_arm/thorlabs_cnc_head/test1.SLDASM
cnc/v1_14x14/electrode_arm/thorlabs_cnc_head/w_plate.DXF
cnc/v1_14x14/electrode_arm/thorlabs_cnc_head/w_plate.SLDDRW
cnc/v1_14x14/electrode_arm/thorlabs_cnc_head/w_plate.SLDPRT
cnc/v1_14x14/electrode_arm/thorlabs_cnc_head/w_plate_fordxf.DXF
cnc/v1_14x14/electrode_arm/thorlabs_cnc_head/w_plate_fordxf.SLDDRW
cnc/v1_14x14/mounting_plates/b_plate.ipt
cnc/v1_14x14/mounting_plates/cnc_z_plate/cnc_z_plate.SLDDRW
cnc/v1_14x14/mounting_plates/w_plate.ipt
cnc/v2_XY_suspended/cnc_assembly.iam
cnc/v2_XY_suspended/cnc_assembly_wo_z.iam
cnc/v2_XY_suspended/commercial_parts/velox_cnc/New XZ_Combo Master.iam
cnc/v2_XY_suspended/commercial_parts/velox_cnc/z_axis.iam
cnc/v2_XY_suspended/mounting_plates/l_bracket.ipt
cnc/v2_XY_suspended/mounting_plates/z_plate.ipt
implants/kinematic_mount/hats/D/TricornerHatD.DXF
implants/kinematic_mount/hats/D/TricornerHatD.SLDDRW
implants/kinematic_mount/hats/D/TricornerHatD_fordxf.SLDDRW
implants/kinematic_mount/hats/E/TricornerHatE.DXF
implants/kinematic_mount/hats/E/TricornerHatE.SLDDRW
implants/kinematic_mount/hats/E/TricornerHatE_fordxf.SLDDRW
implants/kinematic_mount/hats/F/TricornerHatF.idw
implants/kinematic_mount/hats/F/TricornerHatF.ipt
implants/kinematic_mount/hats/F/TricornerHatF_nodims.idw
implants/kinematic_mount/hats/F/TricornerHatF_nodims_1.idw
implants/kinematic_mount/hats/F/TricornerHatF_nodims_2.idw
implants/kinematic_mount/magnet_chuck_redesign/MagnetHolderTrimmedC.ipt
implants/kinematic_mount/magnet_chuck_redesign/OldVersions/al_collar.0003.ipt
implants/kinematic_mount/magnet_chuck_redesign/OldVersions/ferrous_insert.0002.idw
implants/kinematic_mount/magnet_chuck_redesign/OldVersions/ferrous_insert.0002.ipt
implants/kinematic_mount/magnet_chuck_redesign/OldVersions/new_assembly.0005.iam
implants/kinematic_mount/magnet_chuck_redesign/OldVersions/simple_chuck.0009.ipt
implants/kinematic_mount/magnet_chuck_redesign/OldVersions/simple_chuck_force_bridge.0005.ipt
implants/kinematic_mount/magnet_chuck_redesign/TricornerSeat.ipt
implants/kinematic_mount/magnet_chuck_redesign/al_collar.ipt
implants/kinematic_mount/magnet_chuck_redesign/ferrous_insert.idw
implants/kinematic_mount/magnet_chuck_redesign/ferrous_insert.ipt
implants/kinematic_mount/magnet_chuck_redesign/ferrous_insert_no_dims.idw
implants/kinematic_mount/magnet_chuck_redesign/magnet_125.ipt
implants/kinematic_mount/magnet_chuck_redesign/new_assembly.iam
implants/kinematic_mount/magnet_chuck_redesign/old_assembly.iam
implants/kinematic_mount/magnet_chuck_redesign/simple_chuck.ipt
implants/kinematic_mount/magnet_chuck_redesign/simple_chuck_force_bridge.idw
implants/kinematic_mount/magnet_chuck_redesign/simple_chuck_force_bridge.ipt
implants/kinematic_mount/magnet_chuck_redesign/simple_chuck_force_bridge_no_dims.idw
implants/kinematic_mount/seat/grid/TricornerSeat.dxf
implants/kinematic_mount/seat/grid/TricornerSeat.idw
implants/kinematic_mount/seat/grid/TricornerSeat.ipt
implants/kinematic_mount/seat/grid/TricornerSeat.stl
implants/kinematic_mount/seat/z_old/TricornerSeat.STL
implants/kinematic_mount/test_jig/tricorner_test_rig.DXF
implants/kinematic_mount/test_jig/tricorner_test_rig.SLDDRW
implants/kinematic_mount/z_old_from_chris/316Ball.SLDPRT
implants/kinematic_mount/z_old_from_chris/34N42Magnet.SLDPRT
implants/kinematic_mount/z_old_from_chris/Assembly Ball ground hat magnet.SLDASM
implants/kinematic_mount/z_old_from_chris/Bridge Assembly.SLDASM
implants/kinematic_mount/z_old_from_chris/Bridge1 For DXF Out.DXF
implants/kinematic_mount/z_old_from_chris/Bridge1 For DXF Out.SLDDRW
implants/kinematic_mount/z_old_from_chris/Bridge1.SLDDRW
implants/kinematic_mount/z_old_from_chris/Bridge1.SLDPRT
implants/kinematic_mount/z_old_from_chris/EighthBall.SLDPRT
implants/kinematic_mount/z_old_from_chris/Magnet Switch Collar.SLDPRT
implants/kinematic_mount/z_old_from_chris/MagnetHolder.SLDPRT
implants/kinematic_mount/z_old_from_chris/MagnetHolderB.SLDPRT
implants/kinematic_mount/z_old_from_chris/MagnetHolderC.DWG
implants/kinematic_mount/z_old_from_chris/MagnetHolderC.SLDDRW
implants/kinematic_mount/z_old_from_chris/MagnetHolderC.SLDPRT
implants/kinematic_mount/z_old_from_chris/MagnetHolderTrimmedA.SLDPRT
implants/kinematic_mount/z_old_from_chris/MagnetHolderTrimmedB.SLDDRW
implants/kinematic_mount/z_old_from_chris/MagnetHolderTrimmedB.SLDPRT
implants/kinematic_mount/z_old_from_chris/MagnetHolderTrimmedBForDXF.DXF
implants/kinematic_mount/z_old_from_chris/MagnetHolderTrimmedBForDXF.SLDDRW
implants/kinematic_mount/z_old_from_chris/MagnetHolderTrimmedC.SLDPRT
implants/kinematic_mount/z_old_from_chris/MagnetHolderTrimmedD.SLDDRW
implants/kinematic_mount/z_old_from_chris/MagnetHolderTrimmedD.SLDPRT
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
