coxlab/physiology_rig/cnc/v1_14x14/info/thorlabs_stage_test_10.txt

1QM1
1SN7
1SU9.99995
1FR1.000000
1QS10
1QV12.0
1QI0.100
1QG20.8300
1QT0.00
1SL-1000000
1SR1000000
1TJ1
1OM2
1VU4.00000
1VA2.00000
1JH1.000000
1JW0.500000
1OH2.00000
1VB0.000000
1AU16.0000
1AC8.00000
1AG8.00000
1AE1000000
1JK32.0000
1KP3000.00
1KI1000.00
1KD10000.0
1VF1000.00
1AF10000.0
1KS50000.0
1FE1
1DB0
1CL1
1QR1000, 50.0000
1SS1
1GR1.000000
1SI10
1SK0.000000, 0.000000
1BA0
1CO0.000000
1TA0
1CA100
1FQ50
1ZA123H
1ZB300H
1ZE3H
1ZF3H
1ZH37H
1ZS4H
2QM1
2SN2
2SU0.000029
2FR1.000000
2QS10
2QV12.0
2QI0.500
2QG14.0000
2QT0.00
2SL-10.00000
2SR10.00000
2TJ1
2OM3
2VU1.00000
2VA0.100000
2JH0.060000
2JW0.010000
2OH0.100000
2VB0.000000
2AU2.00000
2AC0.005000
2AG0.005000
2AE1000000
2JK0.002500
2KP618.000
2KI1317.00
2KD51.0000
2VF75.0000
2AF0.000000
2KS50000.0
2FE1.00000
2DB0
2CL1
2QR1000, 50.0000
2SS2
2GR1.000000
2SI10
2SK0.000000, 0.000000
2BA0.00000
2CO0.000000
2TA0
2CA100
2FQ50
2ZA327H
2ZB307H
2ZE7H
2ZF7H
2ZH7H
2ZS6H
3QM3
3SN2
3SU0.001
3FR0.010000
3QS100
3QV30.0
3QI0.600
3QG0.5000
3QT0.00
3SL-50.000
3SR50.000
3TJ1
3OM1
3VU20.0000
3VA10.0000
3JH10.00000
3JW2.50000
3OH10.00000
3VB4.00000
3AU80.0000
3AC40.0000
3AG40.0000
3AE1000000
3JK160.000
3KP0.000000
3KI0.000000
3KD0.000000
3VF0.000000
3AF0.000000
3KS50000.0
3FE1.000
3DB0
3CL1
3QR1000, 50.0000
3SS3
3GR1.000000
3SI10
3SK0.000000, 0.000000
3BA0.000
3CO0.000000
3TA0
3CA100
3FQ50
3ZA923H
3ZB300H
3ZE3H
3ZF3H
3ZH37H
3ZS4H
ZZ113H
