coxlab/physiology_rig/sensors/photo_interrupter_lick_sensor.pdf

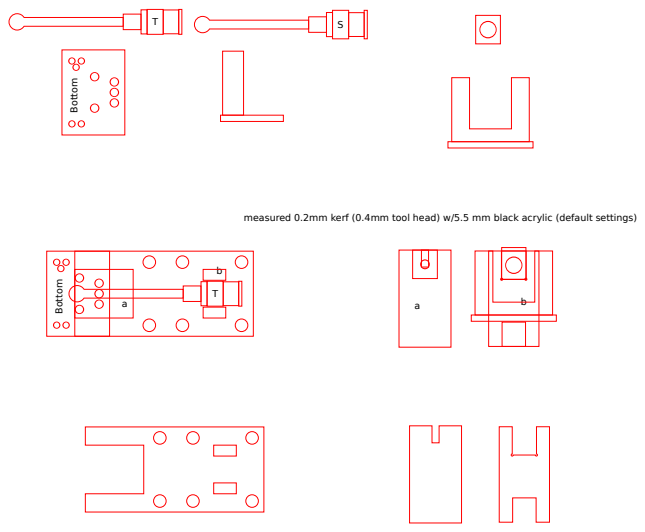
[picture p96: page 1]
Bottom

measured 0.2mm kerf (0.4mm tool head) w/5.5 mm black acrylic (default settings)
