coxlab/physiology_rig/cnc/v1_14x14/mounting_plates/cnc_z_plate/cnc_z_plate.PDF

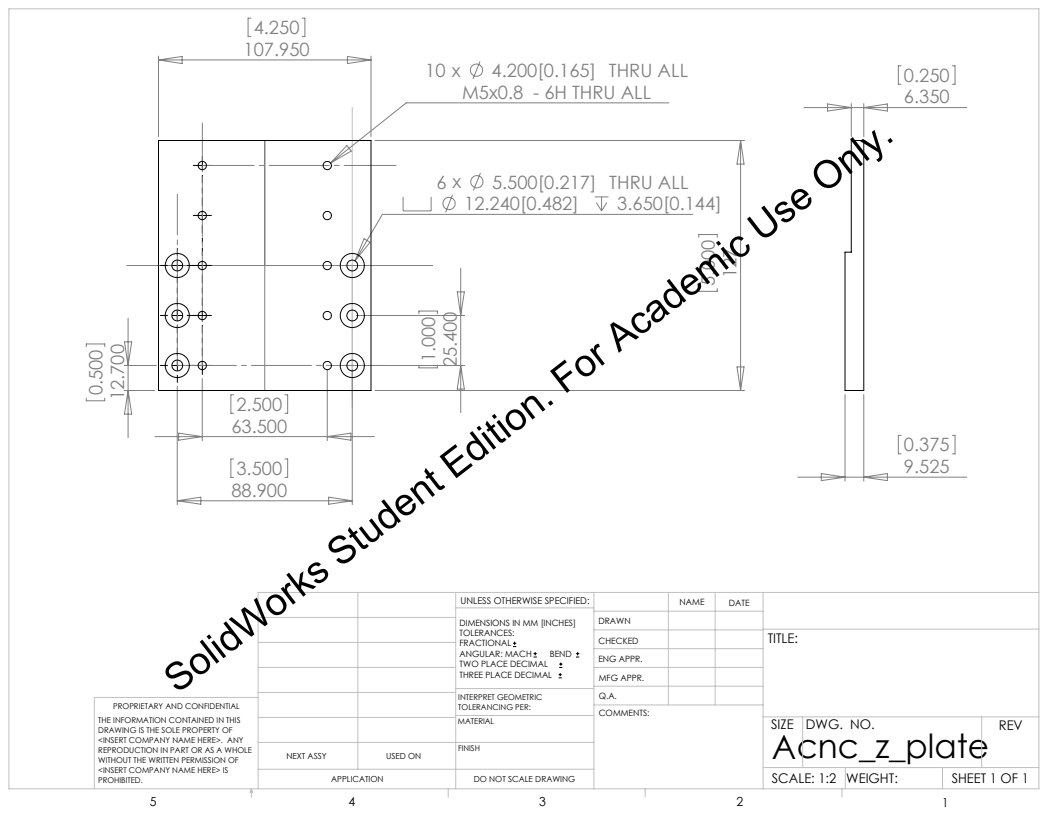
[picture p97: page 1]
M5x0.8 - 6H THRU ALL; 4.200[0.165] THRU ALL; 5.500[0.217] THRU ALL; SHEET 1 OF 1; SCALE: 1:2 WEIGHT:; DWG. NO.; REV; MFG APPR.; ENG APPR.; INTERPRET GEOMETRIC TOLERANCING PER:; ANGULAR: MACH; BEND; NEXT ASSY; USED ON

SolidWorks Student Edition. For Academic Use Only.

UNLESS OTHERWISE SPECIFIED:

DIMENSIONS IN MM [INCHES]
TOLERANCES:
FRACTIONAL
TWO PLACE DECIMAL
THREE PLACE DECIMAL

PROPRIETARY AND CONFIDENTIAL
THE INFORMATION CONTAINED IN THIS
DRAWING IS THE SOLE PROPERTY OF
<INSERT COMPANY NAME HERE>. ANY
REPRODUCTION IN PART OR AS A WHOLE
WITHOUT THE WRITTEN PERMISSION OF
<INSERT COMPANY NAME HERE> IS
PROHIBITED.

DO NOT SCALE DRAWING
