coxlab/physiology_rig/cnc/v1_14x14/commercial_parts/14x14/2012_VR_1414_AssemV2.PDF

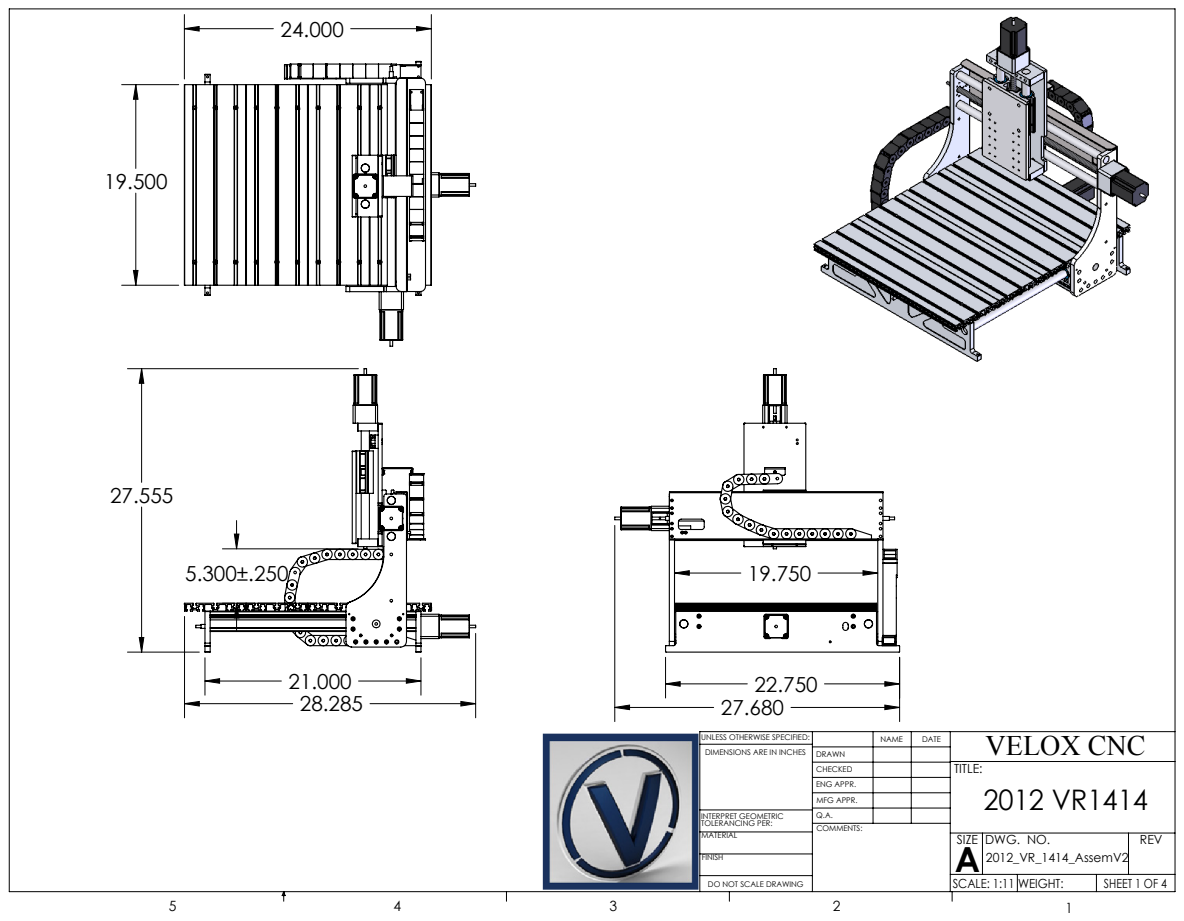
[picture p98: page 1]
SHEET 1 OF 4; SCALE: 1:11 WEIGHT:; DWG. NO.; REV; VELOX CNC DATE; MFG APPR.; ENG APPR.; INTERPRET GEOMETRIC TOLERANCING PER:

UNLESS OTHERWISE SPECIFIED:
DIMENSIONS ARE IN INCHES

DO NOT SCALE DRAWING

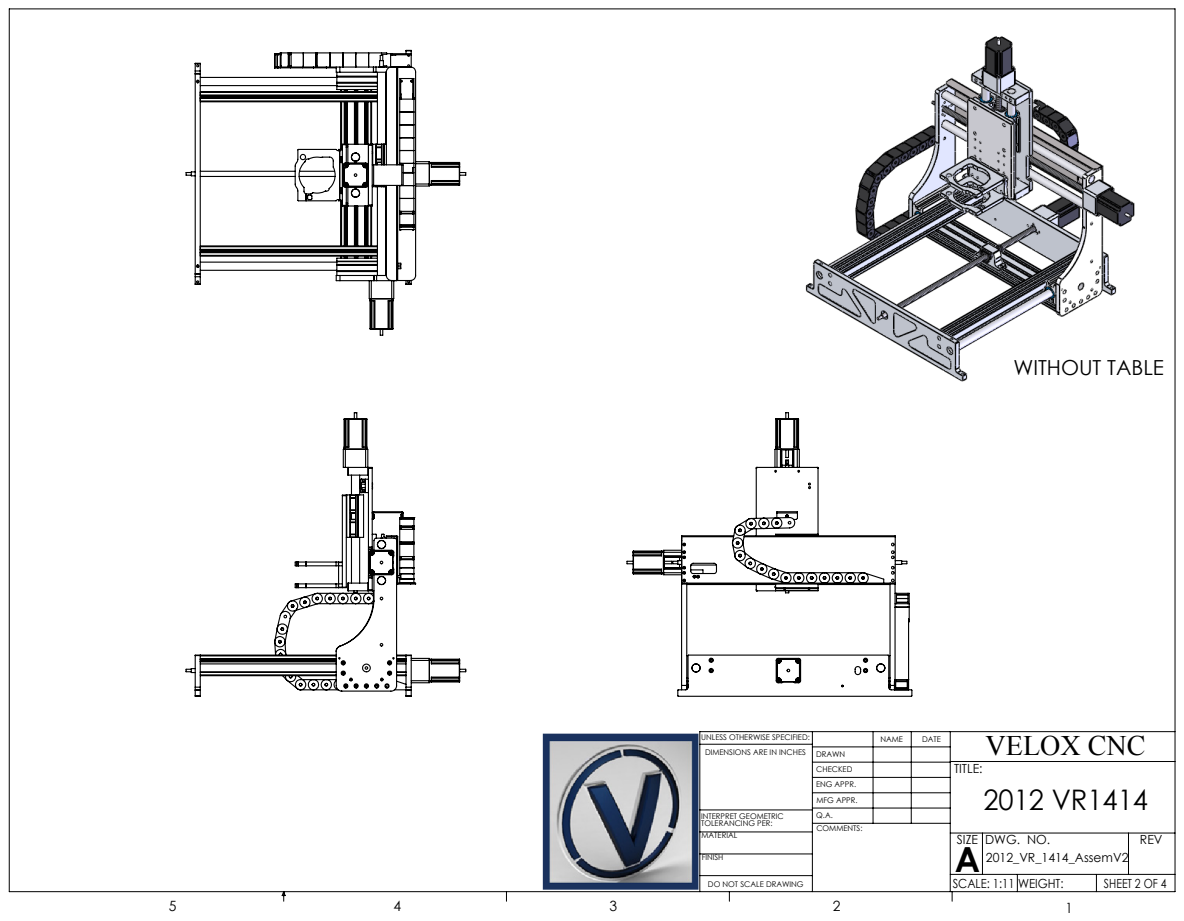
[picture p99: page 2]
WITHOUT TABLE; SHEET 2 OF 4; SCALE: 1:11 WEIGHT:; DWG. NO.; REV; VELOX CNC DATE; MFG APPR.; ENG APPR.; INTERPRET GEOMETRIC TOLERANCING PER:

UNLESS OTHERWISE SPECIFIED:
DIMENSIONS ARE IN INCHES

DO NOT SCALE DRAWING
