coxlab/physiology_rig/two_photon/objective/N20X-PFH-AutoCADPDF.pdf

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

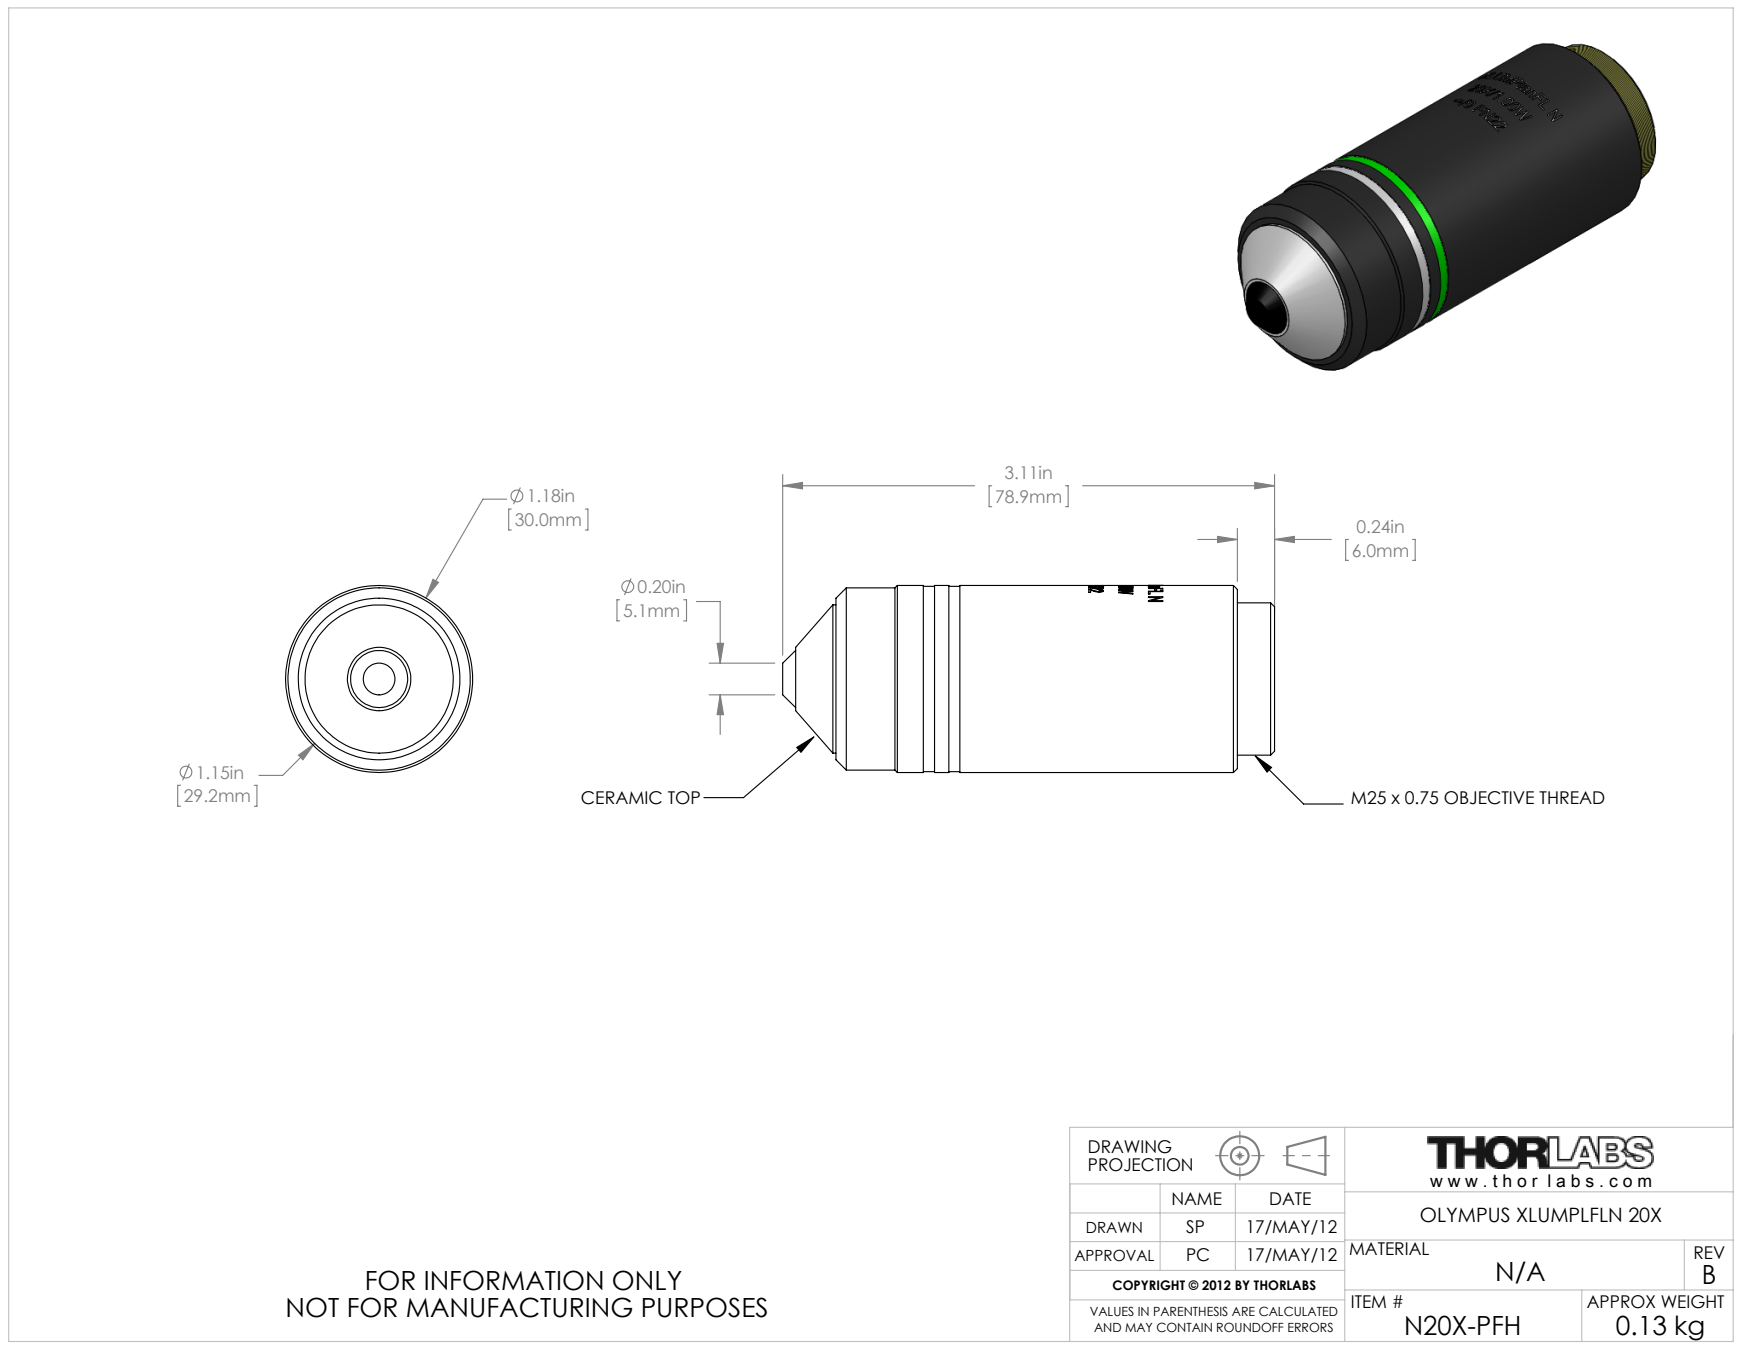
[picture p100: page 1]
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
