coxlab/physiology_rig/recording/z_old/32_channel_multiplexer/RIS-657/RIS-657 20MAR08-SCH.PDF

# RIS-657 IMPEDANCE TEST-SWITCH 20 MAR08

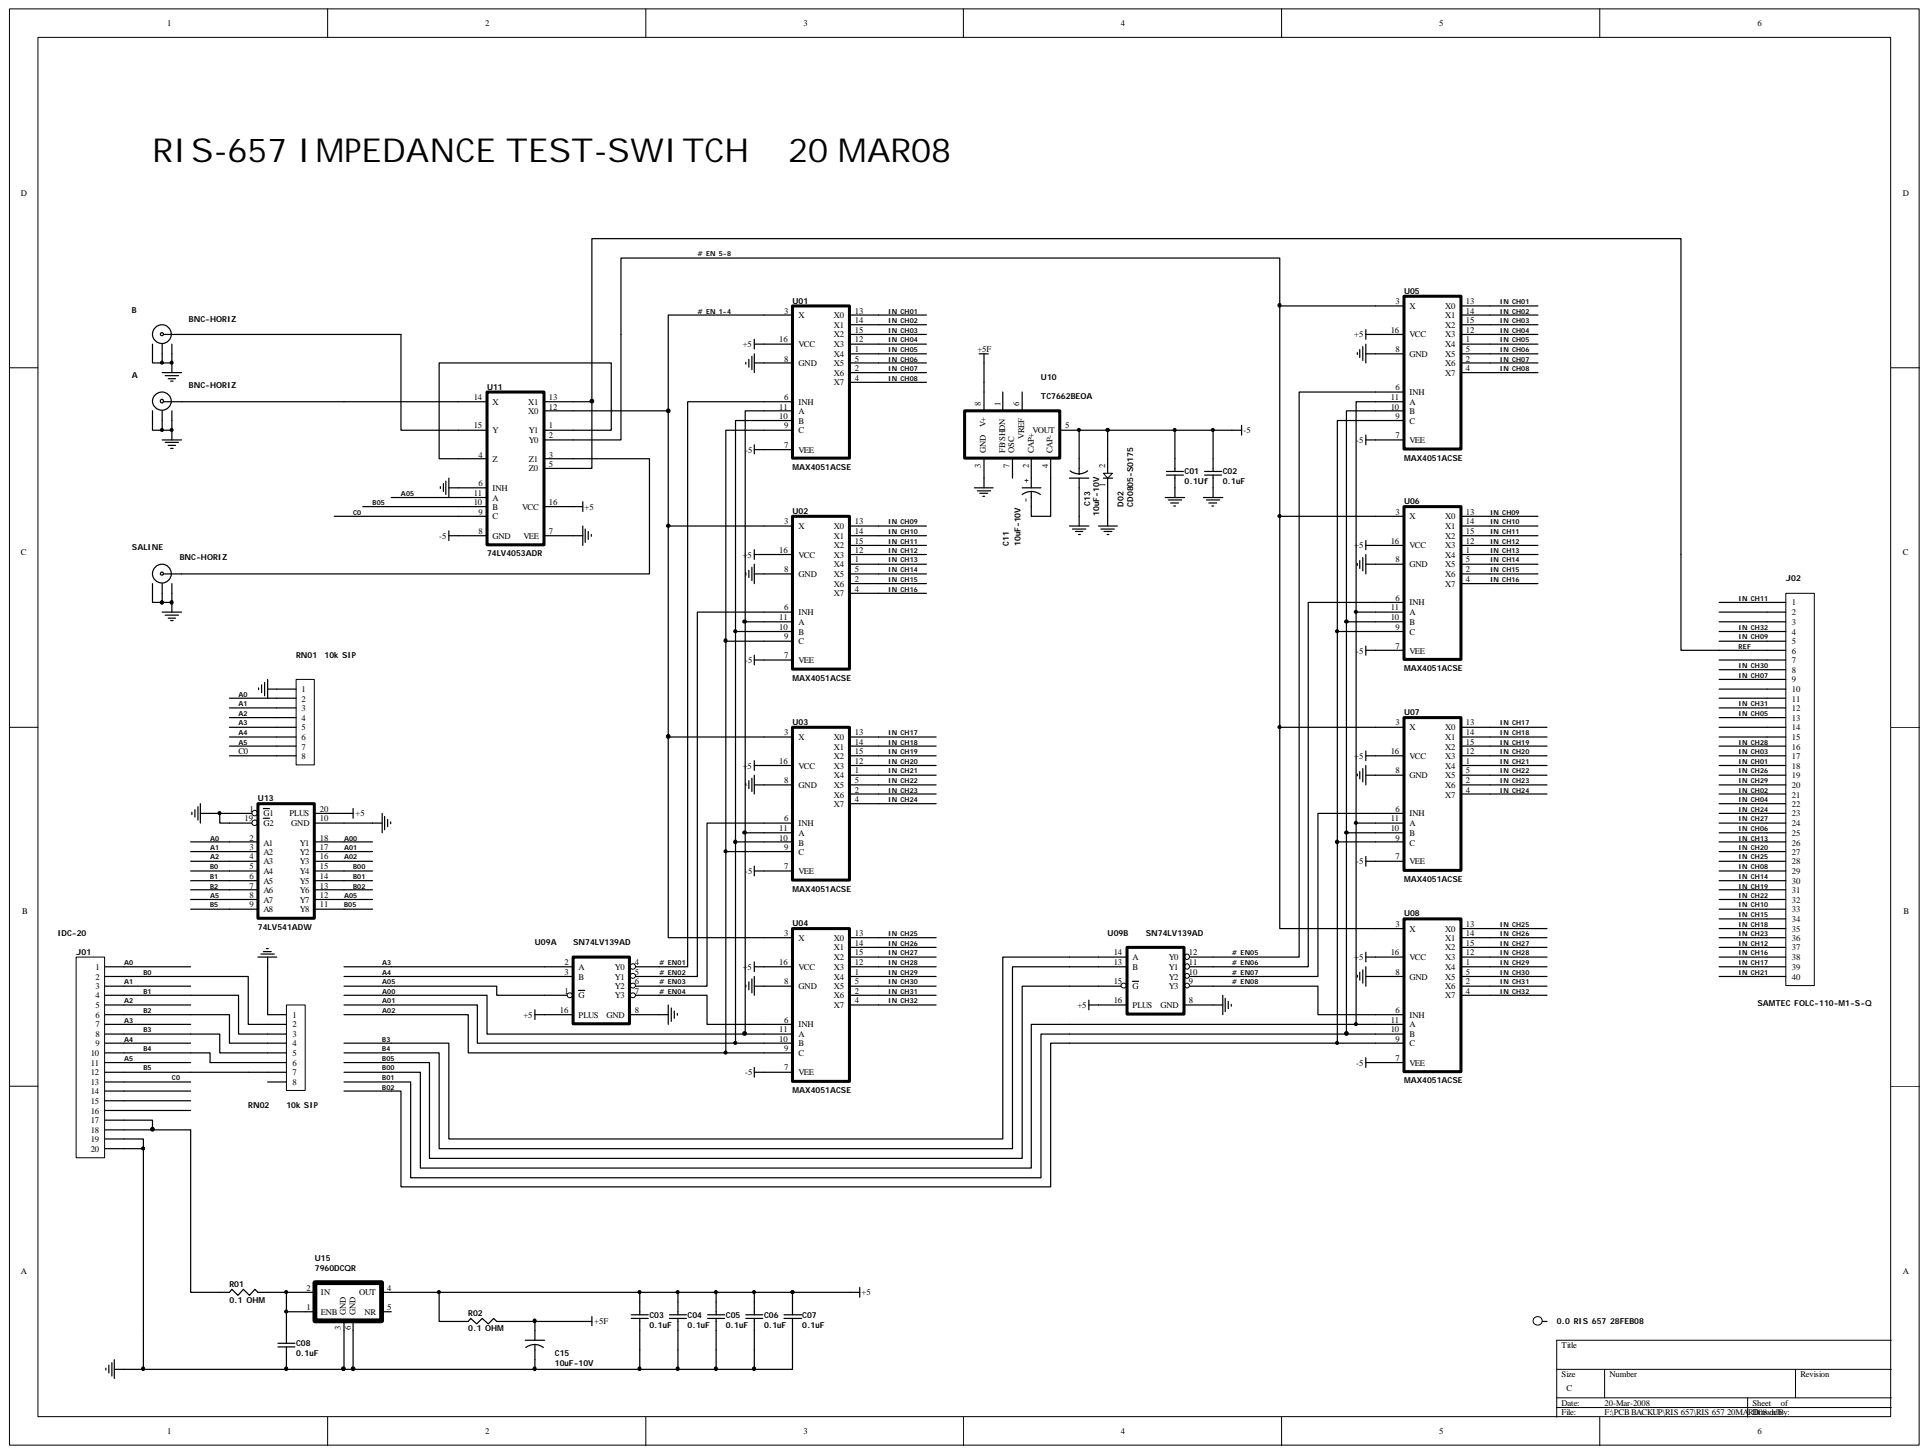
[picture p101: page 1]
