coxlab/physiology_rig/recording/z_old/32_channel_multiplexer/RIS-657/RIS-657-20MAR08-LOC-ASY.pdf

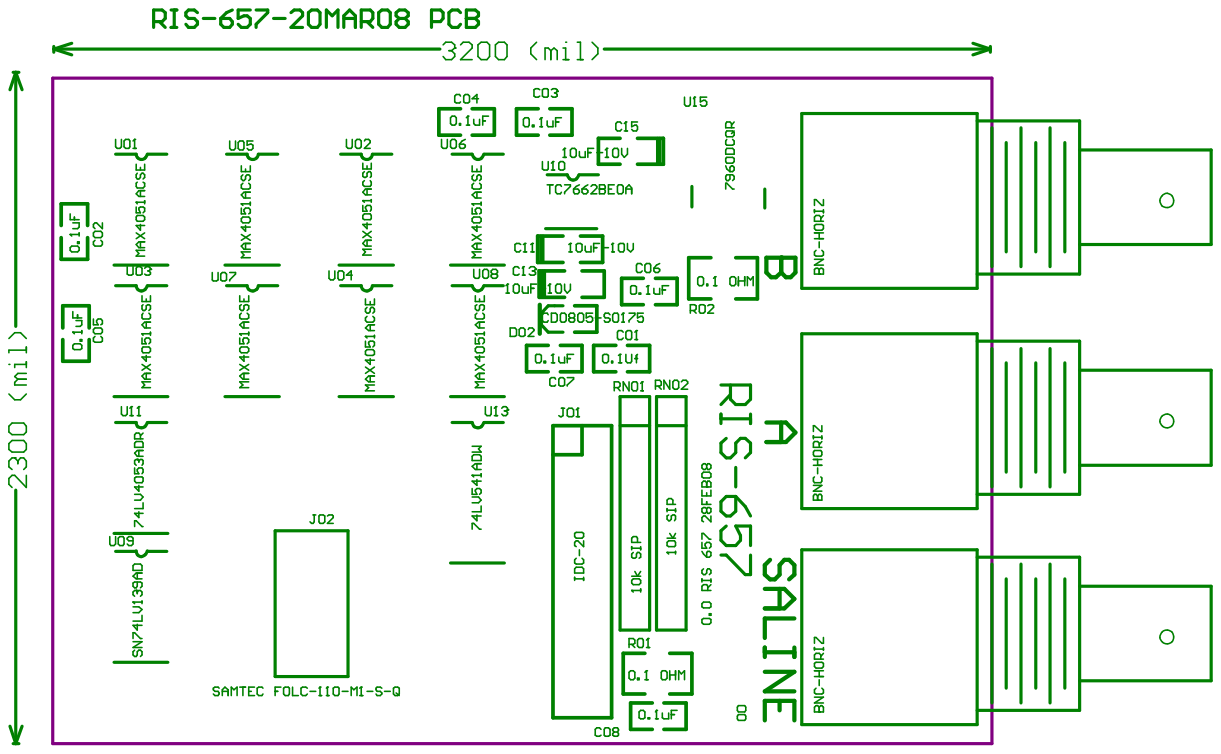
[picture p102: page 1]
