coxlab/physiology_rig/recording/z_old/32_channel_multiplexer/RIS-657/RIS-657-20MAR08-PCB.pdf

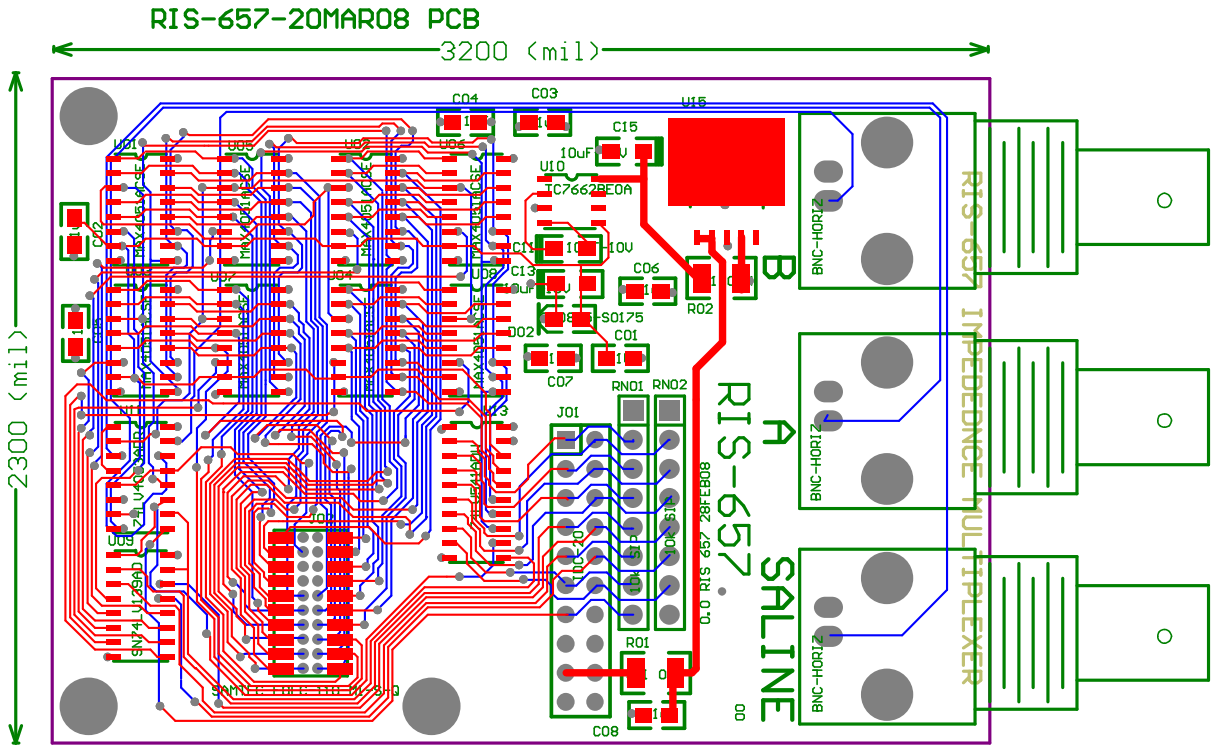
[picture p103: page 1]
