coxlab/physiology_rig/recording/z_old/32_channel_preamp/RIS-655-5/RIS-655-5-ASY.pdf

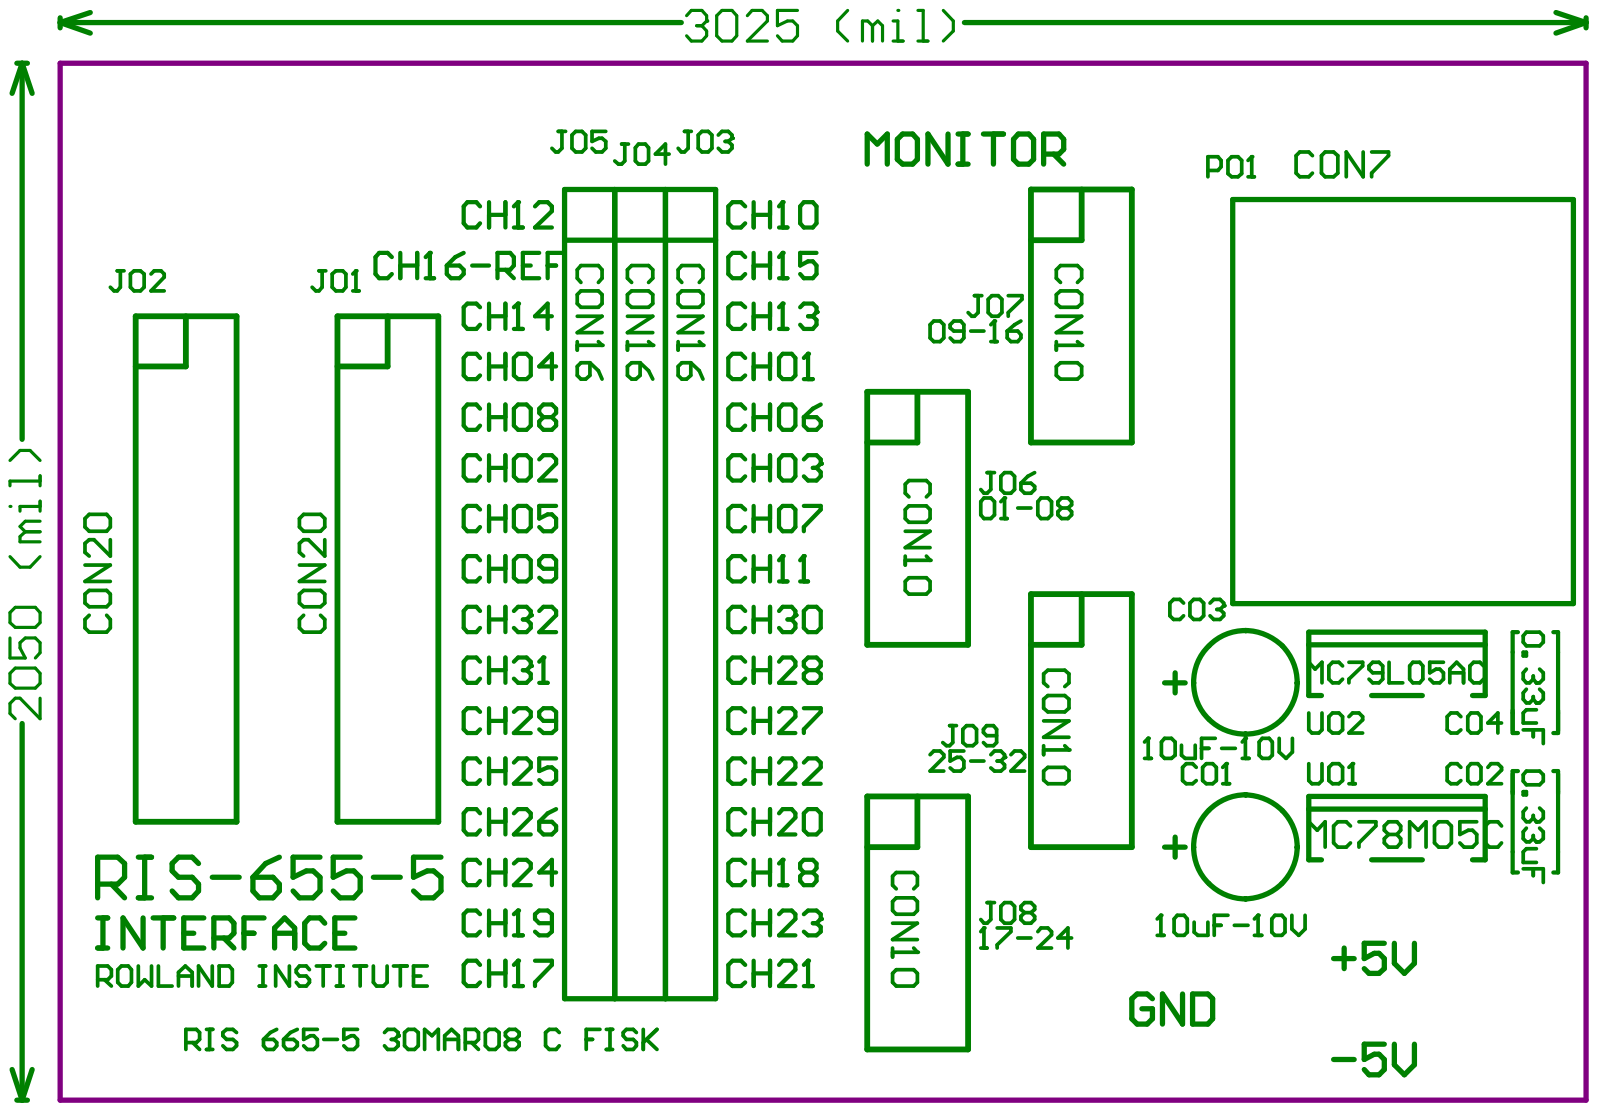
[picture p104: page 1]
