coxlab/physiology_rig/recording/z_old/32_channel_preamp/RIS-655-5/RIS-655-5-PCB.pdf

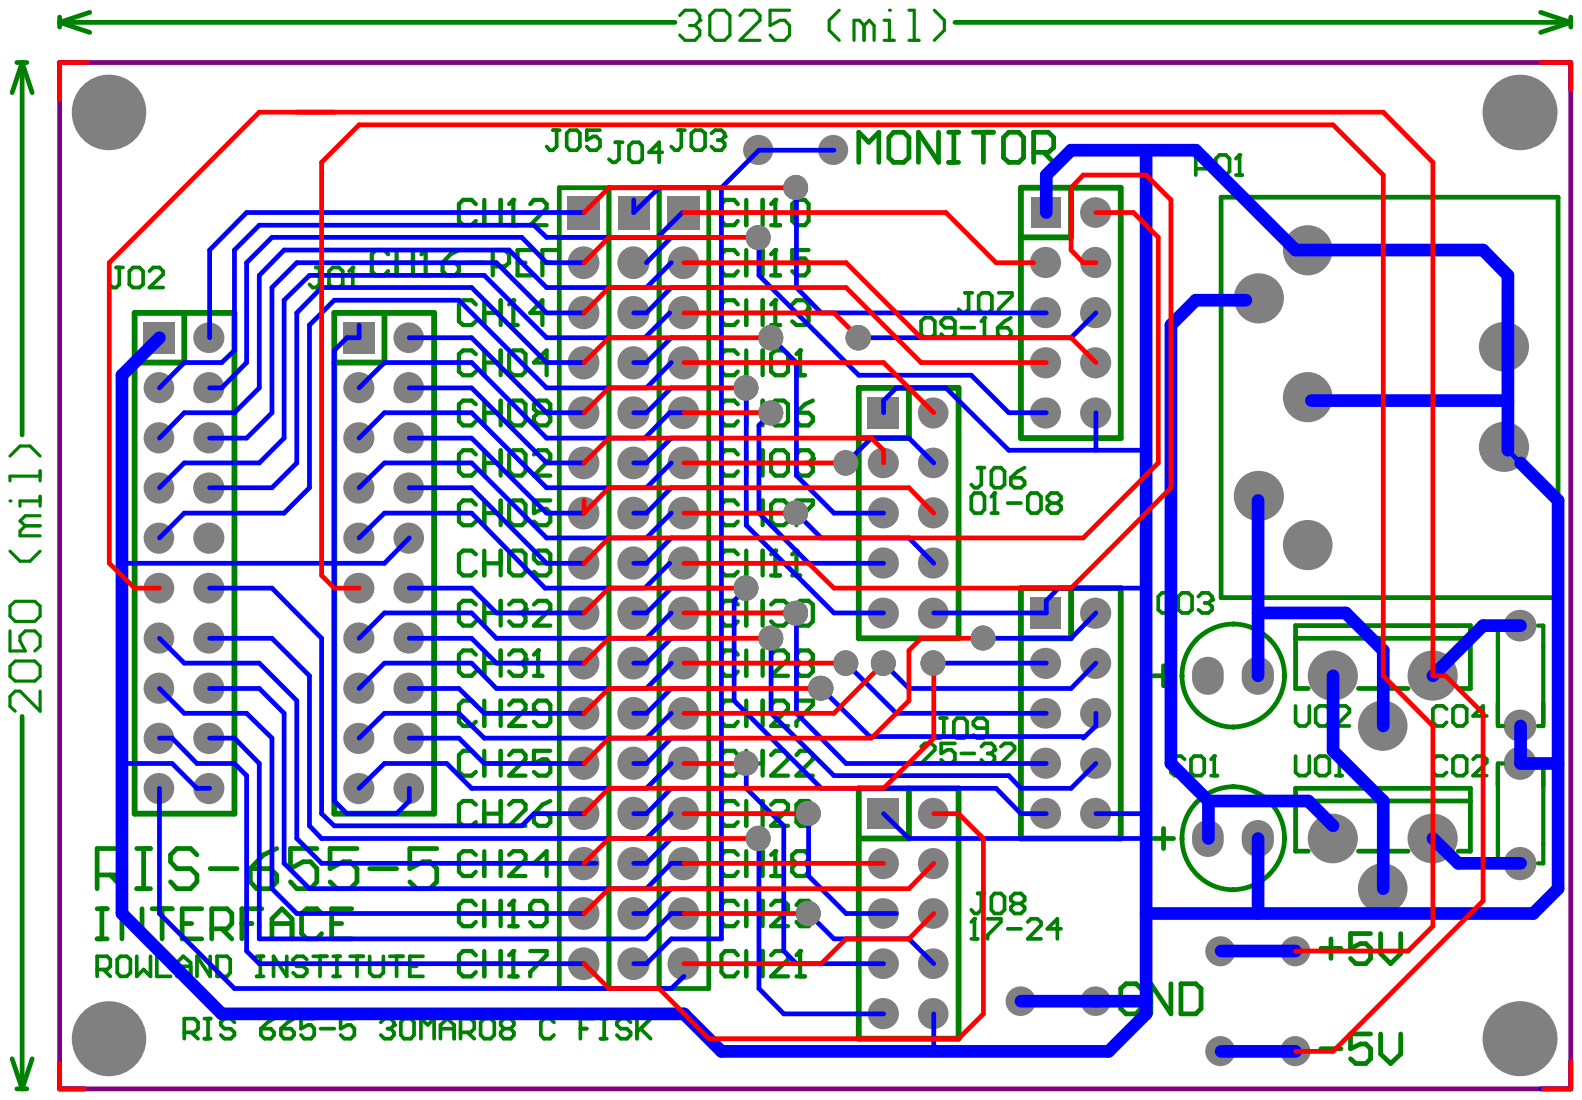
[picture p105: page 1]
