coxlab/physiology_rig/recording/z_old/32_channel_preamp/RIS-655-5/RIS-655-5-sch.pdf

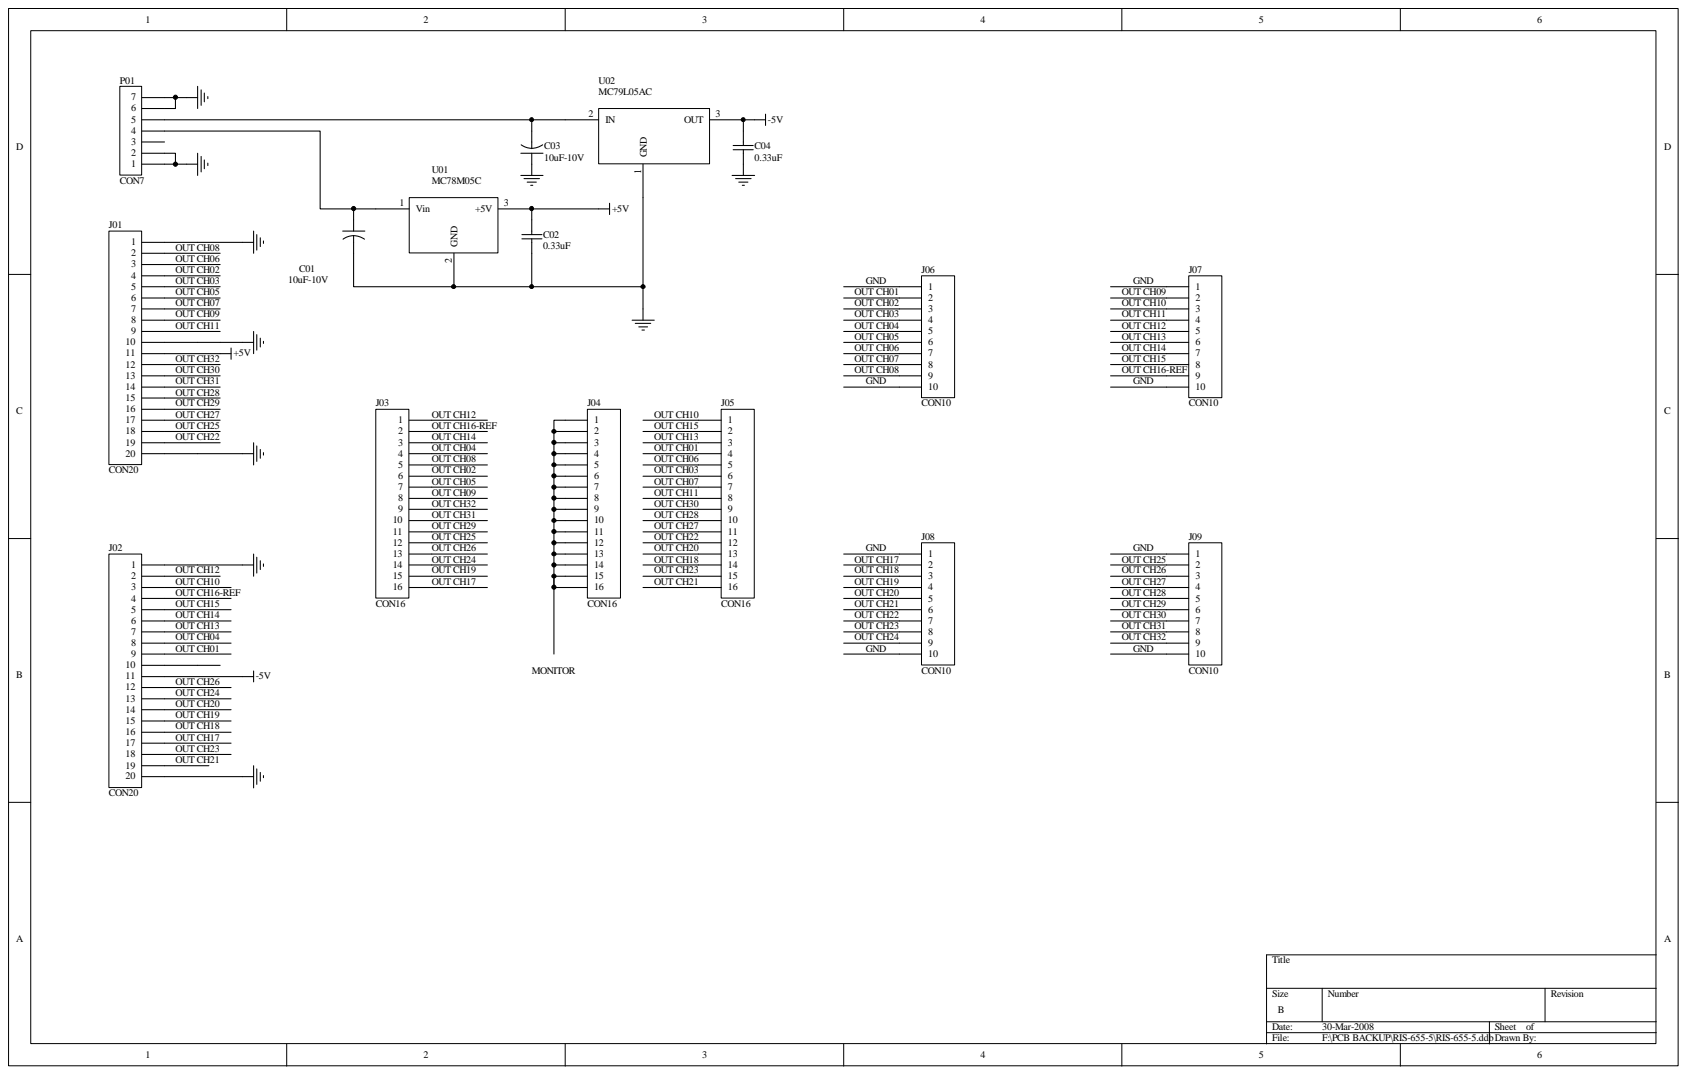
[picture p106: page 1]
