coxlab/physiology_rig/recording/z_old/32_channel_preamp/RIS-655/RIS-655-20MAR08-ASY-BOT.pdf

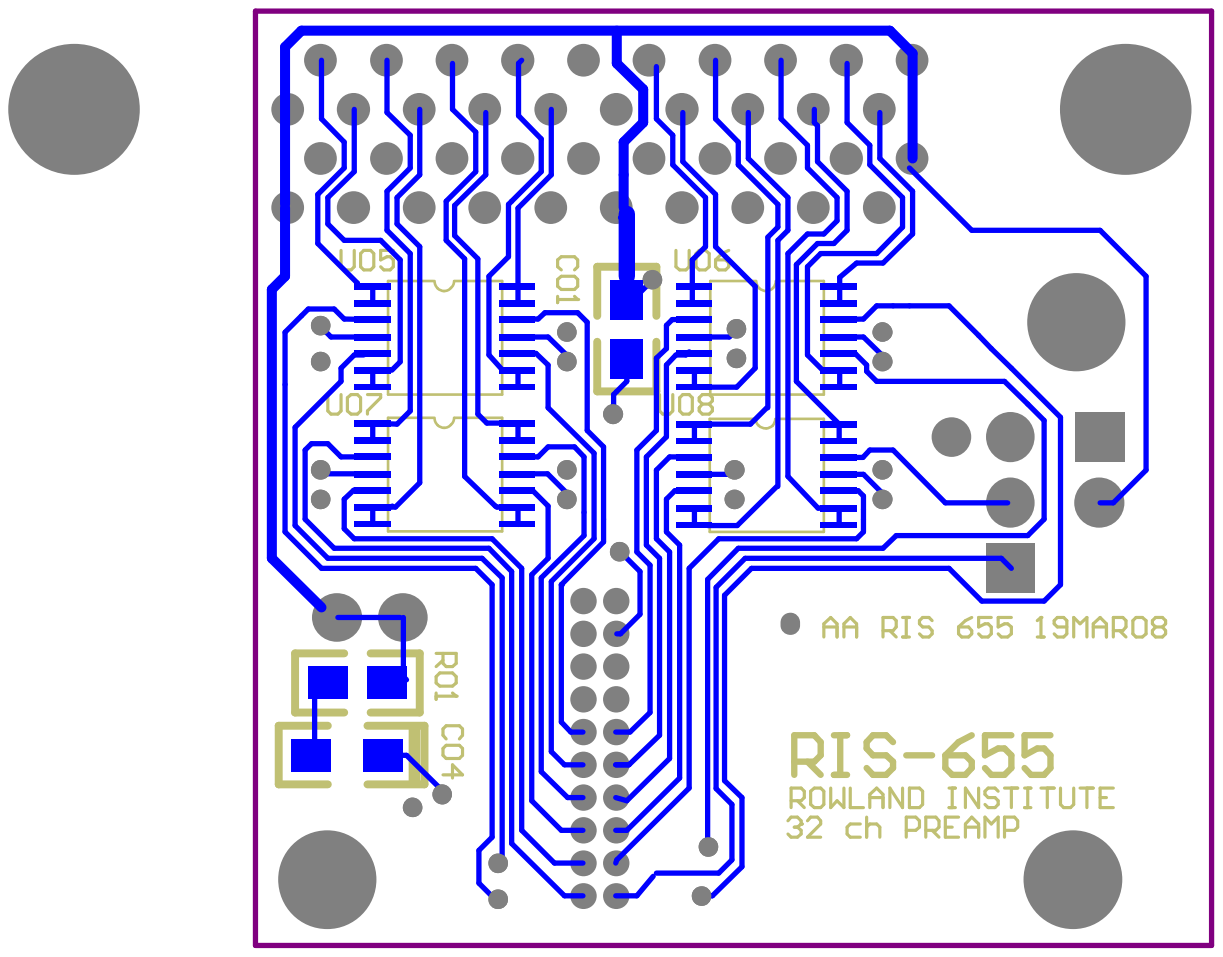
[picture p107: page 1]
