coxlab/physiology_rig/recording/z_old/32_channel_preamp/RIS-655/RIS-655-20MAR08-ASY-TOP.pdf

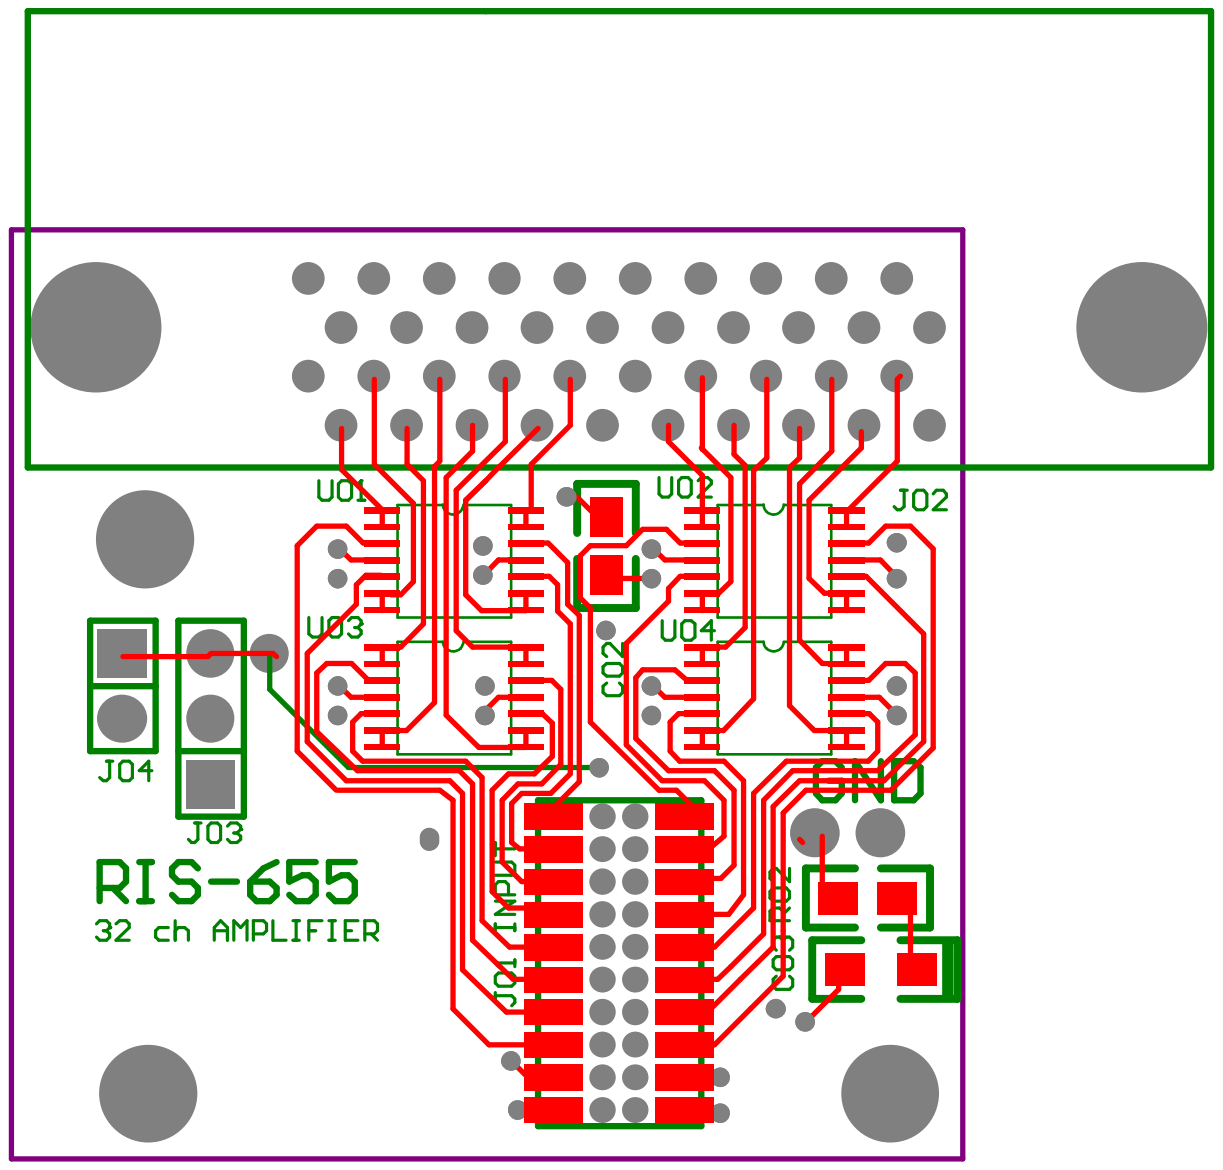
[picture p108: page 1]
