coxlab/physiology_rig/recording/z_old/32_channel_preamp/RIS-655/RIS-655-20MAR08-PCB.pdf

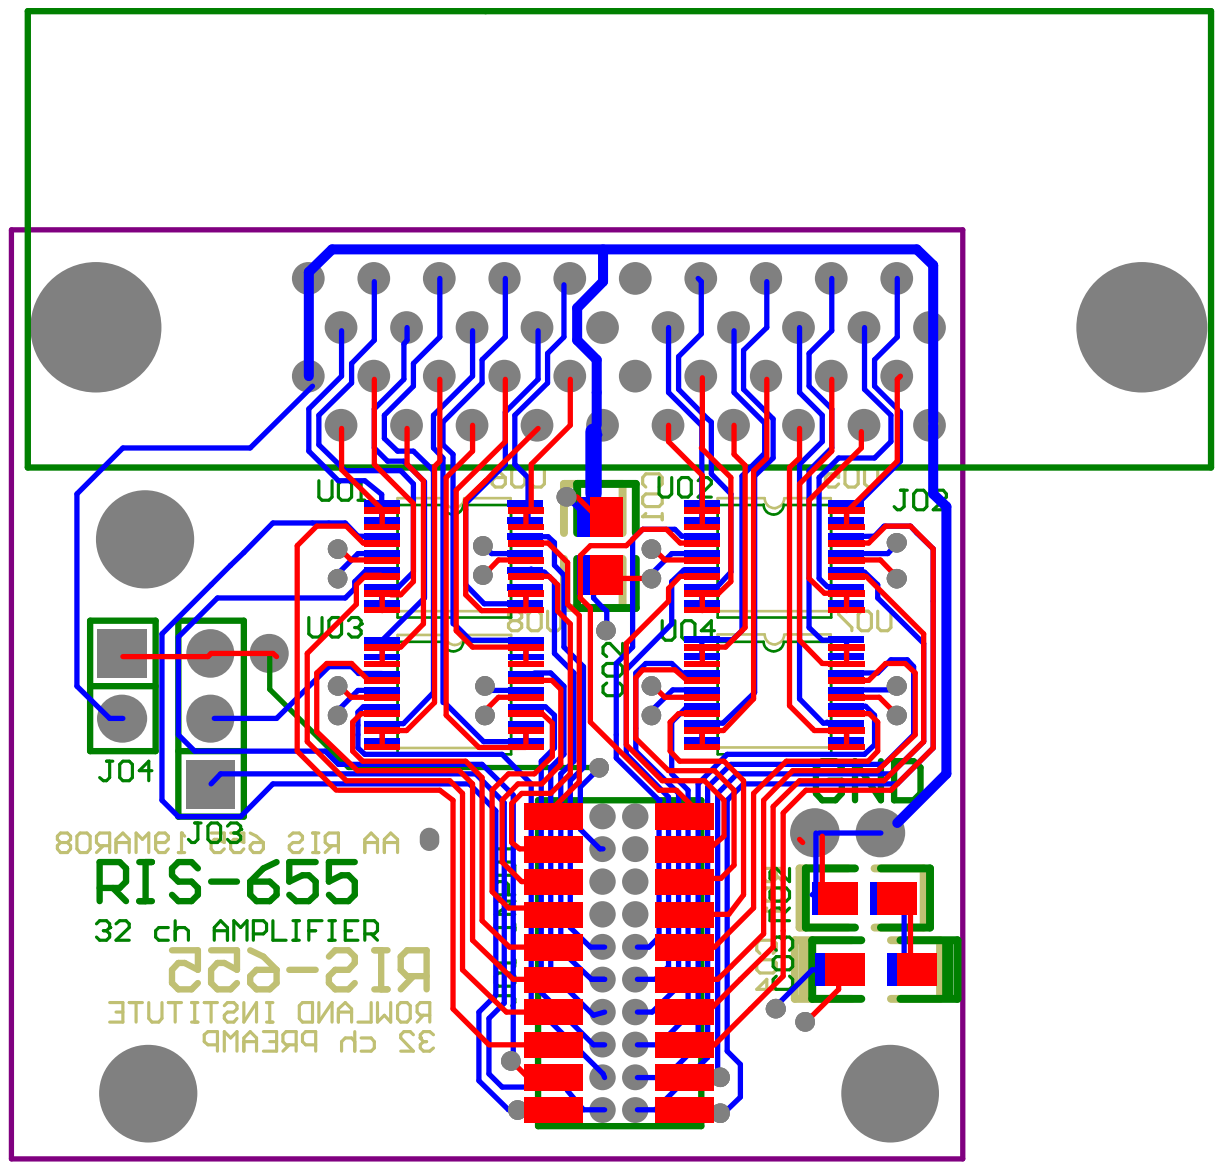
[picture p109: page 1]
