coxlab/physiology_rig/recording/z_old/32_channel_preamp/RIS-655/RIS-655-20MAR08-SCH.pdf

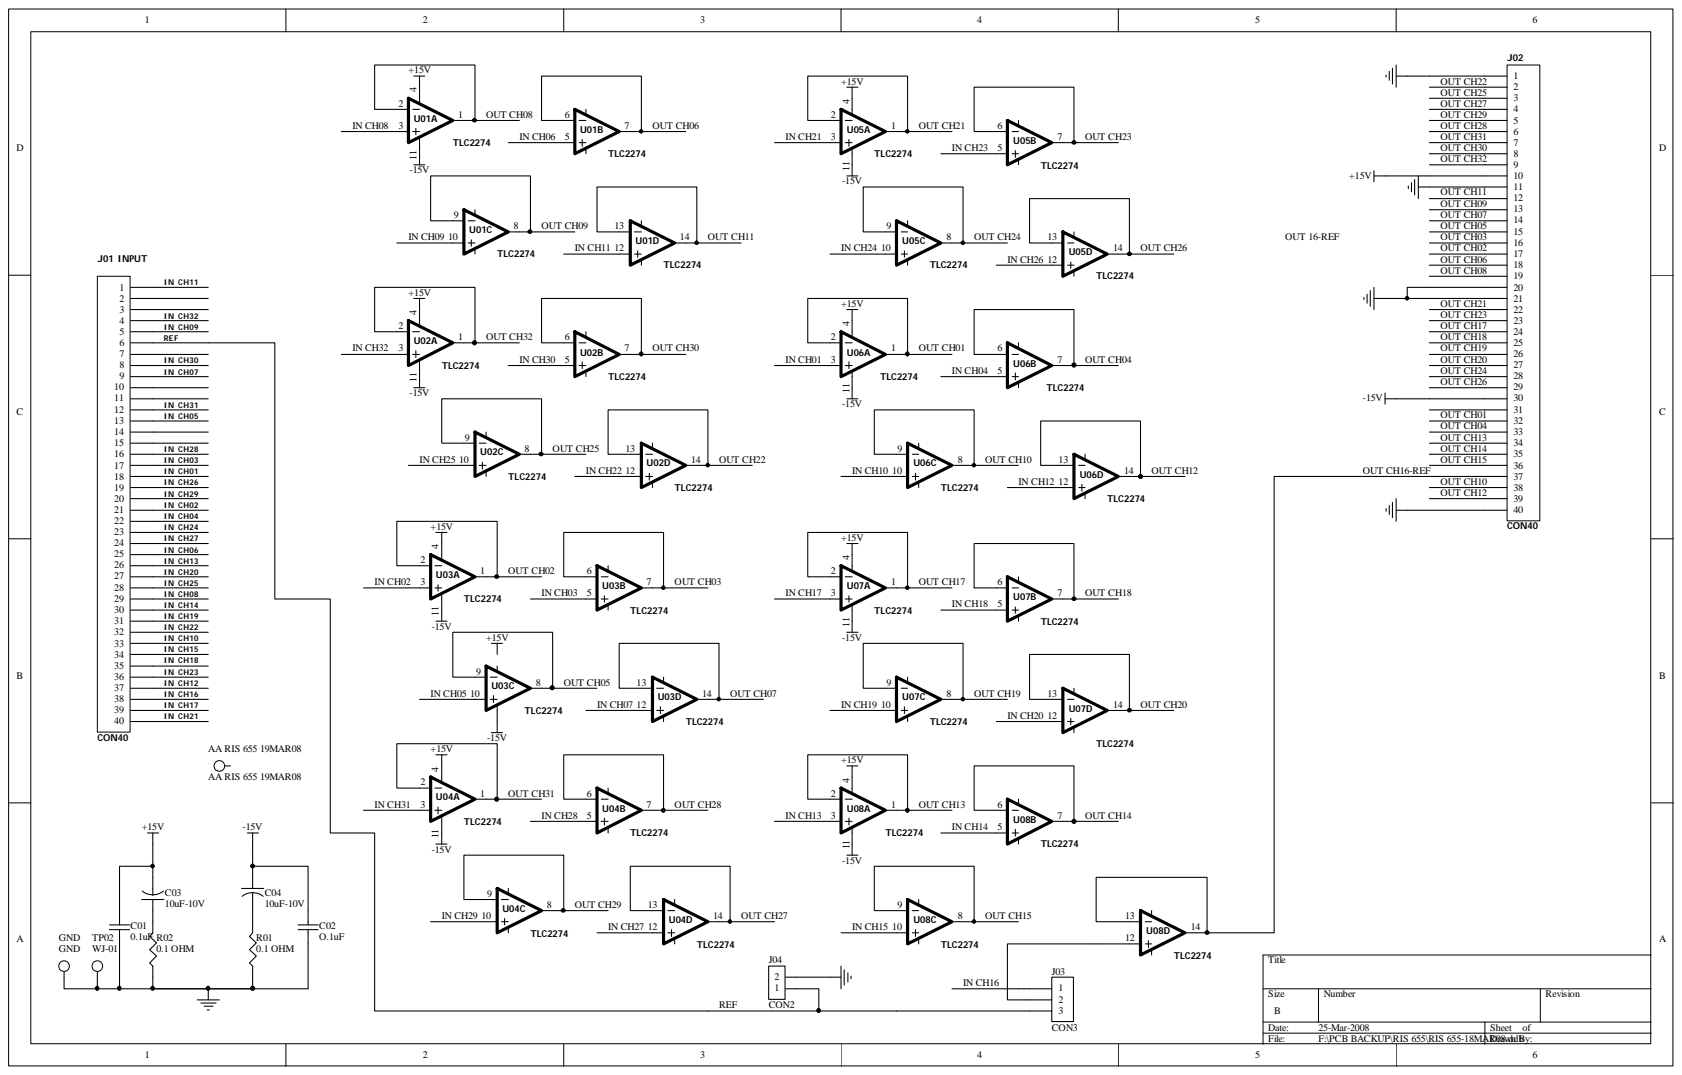
[picture p110: page 1]
