coxlab/physiology_rig/recording/z_old/32_channel_multiplexer/RIS-657/RIS-657_fab-Gerbers_pre/s1.pdf

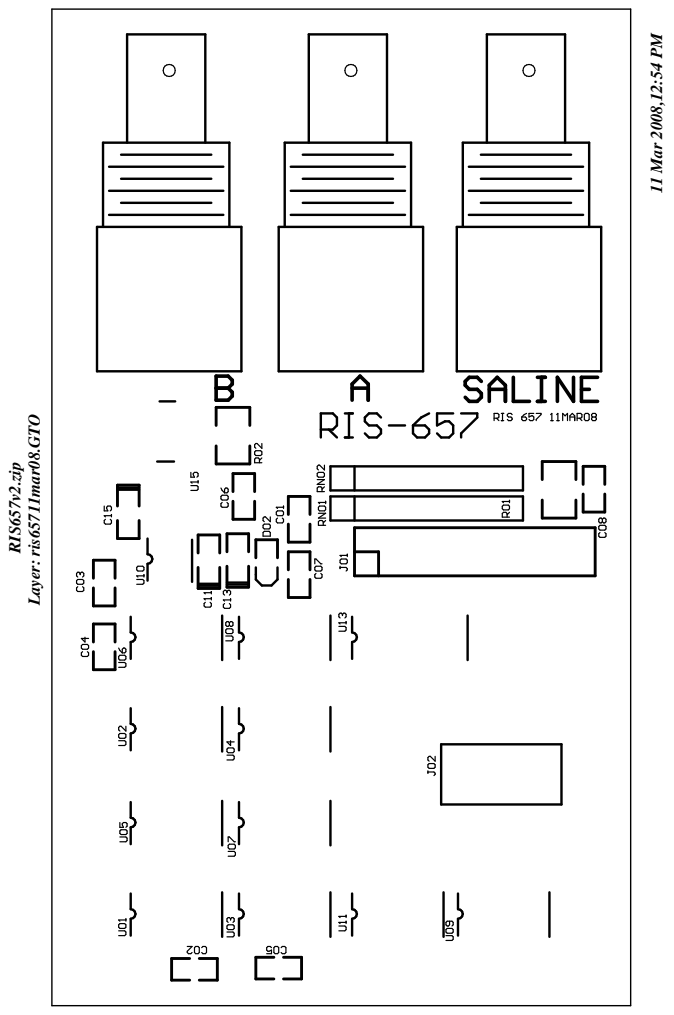
[picture p118: page 1]
RIS657v2.zip; Layer: ris65711mar08.GTO; 11 Mar 2008,12:54 PM
