coxlab/physiology_rig/recording/z_old/32_channel_preamp/RIS-655-5/RIS-655-5_fab-Gerbers/drp.pdf

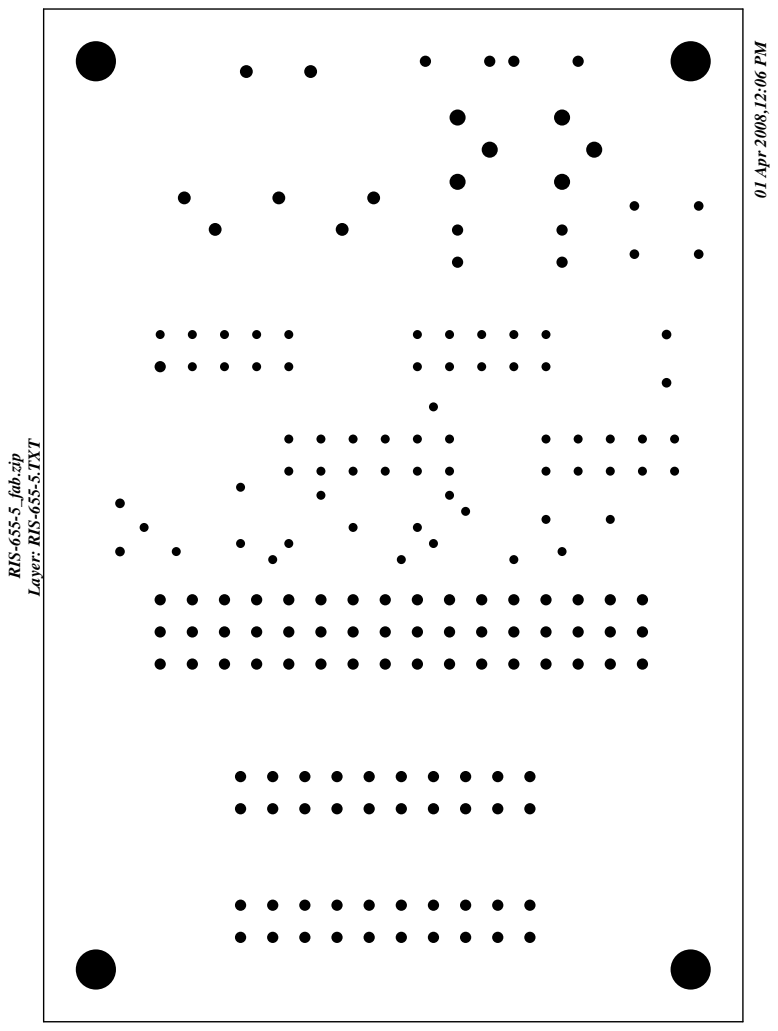
[picture p119: page 1]
RIS-655-5_fab.zip; 01 Apr 2008,12:06 PM

Layer: RIS-655-5.TXT
