coxlab/physiology_rig/recording/z_old/32_channel_preamp/RIS-655/RIS-655_fab-Gerbers/m1.pdf

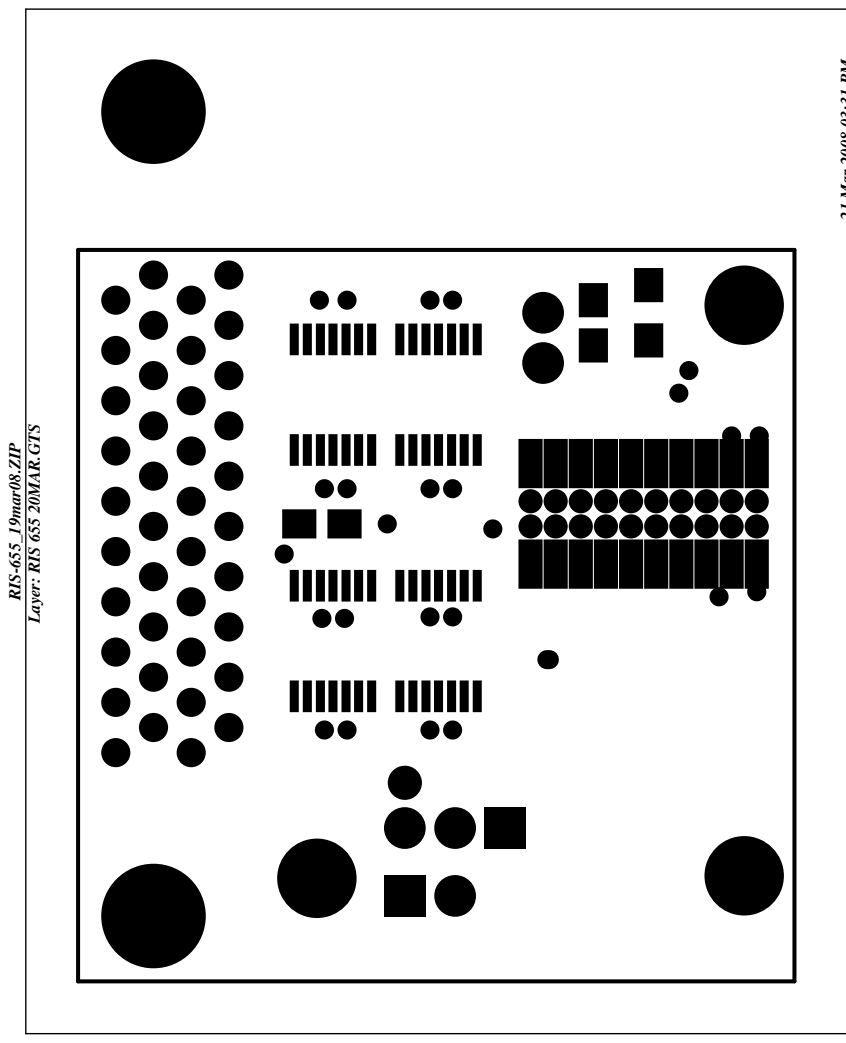
[picture p130: page 1]
RIS-655_19mar08.ZIP; 21 Mar 2008,03:31 PM

Layer: RIS 655 20MAR.GTS
