coxlab/physiology_rig/(commit log)

2012-07-30 adding parts
    [19760-E0W.sldprt, 19760-E0W.step, 316Ball.SLDPRT, 34N42Magnet.SLDPRT, 7mmLidD.DXF, 7mmPanel.DXF, 7mmPanel.SLDDRW, 7mmPanel.SLDPRT]
2013-03-04 adding new stereo camera mounting plate and phidget mount
    [phidget_to_bb_plate.dxf, phidget_to_bb_plate.scad, stereo_cameras_plate.dxf, stereo_cameras_plate.scad]
2013-04-24 Adding 2-photon drawings
    [N20X-PFH-AutoCADDXF.dxf, N20X-PFH-Solidworks.sldprt, N20X-PFH-Step.step]
2013-08-05 adding some lick sensor files and a rough layout image
